MaybeThready/MT-EMI/docs/分镜.md

# MT-EMI 项目展示分镜

## 1. 开头

- +6s（00:06）：拍摄全景，展示外设，口播项目简介。

## 2. 基本交互功能演示

### 2.1. 电容交互演示

- +13s（00:19）：依次演奏 24 个音，展示电容触摸特色交互方式

### 2.2. UI 交互演示

下面的交互方式展示要结合 LCD 显示，口播说明操作逻辑：

- +15s（00:34）：演示旋钮旋动、按下、微调三种交互方式。以音量为例
- +10s（00:44）：演示四个外接按键的使用，展示不同功能的切换。以波形、频谱为例

## 3. 多维表情调控演示

### 3.1. 基本表情演示

- +10s（00:54）：演示力度感应，以不同的力度按压同一个音，展示力度感应的音量变化。
- +10s（01:04）：演示弯音轮的使用，展示音高的连续变化。

### 3.2. 波表与失谐演示

- +14s（01:18）：演示波表端点和插值的调节，展示音色的变化。
- +10s（01:28）：演示失谐的调节，展示音色的变化。

### 3.3. ADSR 调节演示

- +15s（01:43）：演示 ADSR 的调节，展示音量包络的变化。

### 3.4. 效果器演示

- +15s（01:55）：演示混响、延迟、失真、合唱四种效果干湿比的调节，展示音色的变化。
- +15s（02:10）：演示高级音效设置，以延迟为例，展示高级参数的调节。

## 4. 高级功能演示

### 4.1. 和弦演奏模式演示

- +15s（02:25）：演示和弦演奏模式，展示左手和弦、右手旋律的演奏方式。

### 4.2. 音色保存与读取演示

- +30s（02:50）：先运用加速的方式从零开始捏制一个音色，然后以正常速度进行保存、掉电读取的演示

## 5. 结尾

- +10s（03:00）：用美妙的音色弹奏一段美妙的动机作为收尾
