MaybeThready/MT-EMI/docs/S1测试计划.md

# S1 上板测试计划

## 1. 目的与公共接线

四个测试顶层依次增加 ROM 与 I2S、单声部机架、32 声部机架、键盘与 UI。每次只选择一个 `src/test` 中的模块为 Gowin 顶层；四个模块使用相同的顶层端口名称，便于复用一份物理管脚约束。仍需将相应测试文件加入工程，并检查综合、布线报告及约束覆盖情况。

| 顶层端口 | 用途 | 预期 |
| --- | --- | --- |
| `clk_core`、`rst_n` | 50 MHz 输入时钟、低有效复位 | PLL 锁定后系统运行；复位后从乐句或键盘初始状态开始 |
| `i2s_bclk`、`i2s_lrck`、`i2s_dout` | MAX98357A 的 BCLK、LRCK、DIN | 标称 BCLK 1.536 MHz、LRCK 48 kHz；左声道有声，右声道静音 |
| `sd_mode_n` | MAX98357A 声道选择 | **逻辑高电平**，按当前 `i2s_driver` 的约定选择左声道；接线前核对所用功放板 |
| `data_a`、`data_b` | 两块键盘板 74HC165 的串行输出 | 仅第四项使用；1 表示按下 |
| `load_n`、`key_clk` | 74HC165 并行装载和移位时钟 | 前三项固定为 1 和 0；第四项由 `keyboard_driver` 驱动 |
| `status_led[0]` | I2S 帧计数心跳 | 逻辑电平持续翻转，约 1.46 Hz 闪烁频率；实际亮灭取决于 LED 极性 |
| `status_led[1]` | 错误锁存 | 正常为逻辑 0；前三项表示 I2S 欠载，第四项还包含 UI 配置错误和采样超时 |

开始时降低功放音量。示波器测频以板上实际 PLL 输出为准；下面的音频时长和频率按代码标称 48 kHz 计算。I2S 音频经单槽缓冲，机架输出通常会比计算事件晚一个音频帧左右；复位后的短暂静音属于启动过程。

## 2. `test_i2s`：ROM、相位和 I2S

参考文件：[test_i2s_440hz.wav](../assets/audio/s1_expected/test_i2s_440hz.wav)。参考文件截取持续输出的前 2 秒。

- 预期持续听到 **A4、440 Hz** 的纯正弦音，不应有周期性的静音、爆音或音高跳变。没有包络，响度基本恒定。
- 相位累加器每采样前进一步，使用 ROM 的波形 0；I2S 左声道传输 16 位补码采样，右声道传静音。
- 逻辑 `status_led[1]` 应保持 0。若其变为 1，先检查 ROM 采样是否赶上 I2S 接收时刻。

这一项通过后，再接入通道机架。只听到静音时，依次检查 PLL 锁定、`smp_tick_up`、ROM 地址/数据和 I2S 接线。

## 3. `test_static_music`：单声部乐句

参考文件：[test_static_music.wav](../assets/audio/s1_expected/test_static_music.wav)，含两个循环，共 4 秒。

| 乐句位置 | 0 | 1 | 2 | 3 | 4 | 5 | 6 | 7 |
| --- | --- | --- | --- | --- | --- | --- | --- | --- |
| 音符 | C4 | C4 | G4 | G4 | A4 | A4 | G4 | 休止 |

- 每格 12,000 个采样，即 250 ms；第 10,800 个采样发 `note_off`，释放持续 240 个采样，约 5 ms。换音前约有 20 ms 静音。整句每 2 秒重复。
- 单声部、正弦波；力度 `0xC000`，Attack/Decay 各 48 个采样，Sustain `0xB000`。应听到清楚的七个音和末尾休止，不应有两个音同时响起。
- 逻辑 `status_led[1]` 在第一次机架输出后应保持 0；若升高，检查机架每帧是否产生采样和 I2S 缓冲握手。

## 4. `test_dynamic_music`：32 声部与音色变化

参考文件：[test_dynamic_music.wav](../assets/audio/s1_expected/test_dynamic_music.wav)，含两个循环，共 7 秒。

- 每 250 ms 依次演奏 `C4 C4 G4 G4 A4 A4 G4 / F4 F4 E4 E4 D4 D4 C4`，单句 3.5 秒。每个新音只触发一个声部，声部在 32 路中轮流分配。
- 音符在本格第 10,000 个采样，约 208.3 ms 时释放；Release 为 4,800 个采样，约 100 ms。因此相邻音符约有 **58.3 ms 的释放尾音重叠**，听起来比上一项连贯。这种尾音叠加属于预期，不代表同时触发了多个新音。
- Attack 为 240 个采样（5 ms），Decay 为 2,400 个采样（50 ms），Sustain `0x9000`，力度 `0x7000`。正弦波与三角波插值系数随音符序号变化，音色应有规律地改变。当前测试未加入滑音。
- 21 位复音和在输出 I2S 前饱和到 16 位，单音不除以 32；通常不应听到持续削波或采样空洞。逻辑 `status_led[1]` 应保持 0。

## 5. `test_keyboard_interaction`：实物琴键

这一项使用两块键盘板、`keyboard_driver`、`user_interface`、32 声部机架和 I2S。当前驱动为所有琴键提供固定满刻度力度；旋钮、UI 按钮、弯音轮及音色存储不参与测试。UI 默认正弦波，Attack 约 5 ms、Decay 约 150 ms、Sustain 约 70%、Release 约 200 ms。顶层尚未使用 UI 输出的 `master_volume`，因此参考声音不按 UI 默认总音量 30% 缩放。

建议按下面顺序检查，按键编号见 [UI 交互设计](UI交互设计.md)：

1. 按住 A 板 P01（C4），确认只触发一次 `note_on`，持续发声；松开时只触发一次 `note_off`，声音在约 200 ms 内逐渐消失。
2. 按住 A 板 P10（A4），确认音高约 440 Hz；快速重复按放，检查不会卡音或漏释放。
3. 同时按住 P01、P05、P08（C4、E4、G4），确认能听到和弦；分别松开时，各音应独立进入 Release。
4. 观察 `load_n` 与 `key_clk` 的扫描，及内部 `key_states`、`note_on`、`note_off`、`note_busy`。逻辑 `status_led[1]` 应保持 0；若变为 1，分别排查 UI 配置、计算超时和 I2S 欠载。

[test_keyboard_interaction_demo.wav](../assets/audio/s1_expected/test_keyboard_interaction_demo.wav) 仅给出**可重复的演奏示例**：C4 按下 0～0.45 秒，A4 按下 0.70～1.15 秒，C4/E4/G4 和弦按下 1.40～2.10 秒，随后等待释放。实际键盘何时按下由演奏者决定，不能把这份 WAV 当成第四项的固定逐点黄金数据。

## 6. 生成与比较参考音频

在工程根目录运行：

```text
python scripts/audio/generate_s1_expected_audio.py
```

脚本读取现有的 `assets/audio/wavetables.mi`，在 `assets/audio/s1_expected/` 生成上述四个 **48 kHz、单声道、16 位 PCM WAV**。更新 ROM、音符序列或 ADSR 常数后，需同步更新脚本参数并重新生成。

WAV 用于比较音高、节奏、波形和包络趋势。脚本按照线性 ADSR 与定点波表运算生成听感参考，没有模拟 PLL 启动、键盘扫描抖动、每个 valid/ready 状态或 I2S 帧缓冲的精确延迟；录音对比时先对齐起点，并允许少量采样级相位和量化差异。第四项还取决于实际按键动作，重点检查事件与声音响应，不作固定逐点比较。
