MaybeThready/MT-EMI/docs/包络计算公式.md

# 包络模块计算公式

2026.10.19 最后一次修订

## Attack 阶段

Attack 阶段包络由 $(0, 0)$ 线性上升到 $(a, M)$，其中，$a$ 为 Attack 采样周期数，$M$ 为定点数最大值。

设当前阶段采样周期数为 $t$，则 Attack 阶段包络计算公式为：

$$ y(t) = K_a t $$

$$ K_a = M I_a $$

$$ I_a = \frac{1}{a} $$

## Decay 阶段

### 二次曲线方案

Decay 阶段包络由 $(0, M)$ 二次下降到 $(d, s)$，其中，$d$ 为 Decay 采样周期数，$s$ 为 Sustain 阶段的包络值。

设当前阶段采样周期数为 $t$，则 Decay 阶段包络计算公式为：

$$ y(t) = \frac{M - s}{d^2} t^2 - \frac{2(M-s)}{d} t + M $$

取微分，得

$$ -dy(t) = K_d(1-I_d t) dt $$

$$ K_d = \frac{2(M-s)}{d} $$

### 线性方案

Decay 阶段包络由 $(0, M)$ 线性下降到 $(d, s)$，其中，$d$ 为 Decay 采样周期数，$s$ 为 Sustain 阶段的包络值。

设当前阶段采样周期数为 $t$，则 Decay 阶段包络计算公式为：

$$ y(t) = M - K_d t $$

$$ K_d = \frac{M - s}{d} $$

## Sustain 阶段

Sustain 阶段包络为常数 $s$，即：

$$ y(t) = s $$

## Release 阶段

### 二次曲线方案

Release 阶段包络由 $(0, s)$ 二次下降到 $(r, 0)$，其中，$r$ 为 Release 采样周期数。

设当前阶段采样周期数为 $t$，则 Release 阶段包络计算公式为：

$$ y(t) = \frac{s}{r^2} t^2 - \frac{2s}{r} t + s$$

取微分，得

$$ -dy(t) = K_r(1-I_r t) dt $$

$$ K_r = \frac{2s}{r} $$

### 线性方案

Release 阶段包络由 $(0, s)$ 线性下降到 $(r, 0)$，其中，$r$ 为 Release 采样周期数。

设当前阶段采样周期数为 $t$，则 Release 阶段包络计算公式为：

$$ y(t) = s - K_r t $$

$$ K_r = \frac{s}{r} $$
