MaybeThready/MT-EMI/src/audio_mix_buffer/audio_mix_buffer.v

//Copyright (C)2014-2026 Gowin Semiconductor Corporation.
//All rights reserved.
//File Title: IP file
//Tool Version: V1.9.12.04 (64-bit)
//IP Version: 1.0
//Part Number: GW5AST-LV138FPG676AC1/I0
//Device: GW5AST-138
//Device Version: C
//Created Time: Tue Oct 27 20:31:01 2026

module audio_mix_buffer (dout, clka, cea, clkb, ceb, oce, reset, ada, din, adb);

output [23:0] dout;
input clka;
input cea;
input clkb;
input ceb;
input oce;
input reset;
input [16:0] ada;
input [23:0] din;
input [16:0] adb;

wire lut_f_0;
wire lut_f_1;
wire lut_f_2;
wire lut_f_3;
wire lut_f_4;
wire lut_f_5;
wire lut_f_6;
wire lut_f_7;
wire lut_f_8;
wire lut_f_9;
wire lut_f_10;
wire lut_f_11;
wire lut_f_12;
wire lut_f_13;
wire lut_f_14;
wire lut_f_15;
wire lut_f_16;
wire lut_f_17;
wire lut_f_18;
wire lut_f_19;
wire lut_f_20;
wire lut_f_21;
wire lut_f_22;
wire lut_f_23;
wire lut_f_24;
wire lut_f_25;
wire lut_f_26;
wire lut_f_27;
wire lut_f_28;
wire lut_f_29;
wire lut_f_30;
wire lut_f_31;
wire lut_f_32;
wire lut_f_33;
wire lut_f_34;
wire lut_f_35;
wire lut_f_36;
wire lut_f_37;
wire lut_f_38;
wire lut_f_39;
wire lut_f_40;
wire lut_f_41;
wire lut_f_42;
wire lut_f_43;
wire lut_f_44;
wire lut_f_45;
wire lut_f_46;
wire lut_f_47;
wire lut_f_48;
wire lut_f_49;
wire lut_f_50;
wire lut_f_51;
wire lut_f_52;
wire lut_f_53;
wire lut_f_54;
wire lut_f_55;
wire lut_f_56;
wire lut_f_57;
wire lut_f_58;
wire lut_f_59;
wire lut_f_60;
wire lut_f_61;
wire lut_f_62;
wire lut_f_63;
wire lut_f_64;
wire lut_f_65;
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
    .ADB({adb[10:0],gw_gnd,gw_gnd,gw_gnd})
);

defparam sdpx9b_inst_3.READ_MODE = 1'b0;
defparam sdpx9b_inst_3.BIT_WIDTH_0 = 9;
defparam sdpx9b_inst_3.BIT_WIDTH_1 = 9;
defparam sdpx9b_inst_3.BLK_SEL_0 = 3'b001;
defparam sdpx9b_inst_3.BLK_SEL_1 = 3'b001;
defparam sdpx9b_inst_3.RESET_MODE = "SYNC";

SDPX9B sdpx9b_inst_4 (
    .DO({sdpx9b_inst_4_dout_w[26:0],sdpx9b_inst_4_dout[8:0]}),
    .CLKA(clka),
    .CEA(cea),
    .CLKB(clkb),
    .CEB(ceb),
    .OCE(oce),
    .RESET(reset),
    .BLKSELA({gw_gnd,gw_gnd,lut_f_4}),
    .BLKSELB({gw_gnd,gw_gnd,lut_f_44}),
    .ADA({ada[10:0],gw_gnd,gw_gnd,gw_gnd}),
    .DI({gw_gnd,gw_gnd,gw_gnd,gw_gnd,gw_gnd,gw_gnd,gw_gnd,gw_gnd,gw_gnd,gw_gnd,gw_gnd,gw_gnd,gw_gnd,gw_gnd,gw_gnd,gw_gnd,gw_gnd,gw_gnd,gw_gnd,gw_gnd,gw_gnd,gw_gnd,gw_gnd,gw_gnd,gw_gnd,gw_gnd,gw_gnd,din[8:0]}),
    .ADB({adb[10:0],gw_gnd,gw_gnd,gw_gnd})
);

defparam sdpx9b_inst_4.READ_MODE = 1'b0;
defparam sdpx9b_inst_4.BIT_WIDTH_0 = 9;
defparam sdpx9b_inst_4.BIT_WIDTH_1 = 9;
defparam sdpx9b_inst_4.BLK_SEL_0 = 3'b001;
defparam sdpx9b_inst_4.BLK_SEL_1 = 3'b001;
defparam sdpx9b_inst_4.RESET_MODE = "SYNC";

SDPX9B sdpx9b_inst_5 (
    .DO({sdpx9b_inst_5_dout_w[26:0],sdpx9b_inst_5_dout[8:0]}),
    .CLKA(clka),
    .CEA(cea),
    .CLKB(clkb),
    .CEB(ceb),
    .OCE(oce),
    .RESET(reset),
    .BLKSELA({gw_gnd,gw_gnd,lut_f_5}),
    .BLKSELB({gw_gnd,gw_gnd,lut_f_45}),
    .ADA({ada[10:0],gw_gnd,gw_gnd,gw_gnd}),
    .DI({gw_gnd,gw_gnd,gw_gnd,gw_gnd,gw_gnd,gw_gnd,gw_gnd,gw_gnd,gw_gnd,gw_gnd,gw_gnd,gw_gnd,gw_gnd,gw_gnd,gw_gnd,gw_gnd,gw_gnd,gw_gnd,gw_gnd,gw_gnd,gw_gnd,gw_gnd,gw_gnd,gw_gnd,gw_gnd,gw_gnd,gw_gnd,din[8:0]}),
    .ADB({adb[10:0],gw_gnd,gw_gnd,gw_gnd})
);

defparam sdpx9b_inst_5.READ_MODE = 1'b0;
defparam sdpx9b_inst_5.BIT_WIDTH_0 = 9;
defparam sdpx9b_inst_5.BIT_WIDTH_1 = 9;
defparam sdpx9b_inst_5.BLK_SEL_0 = 3'b001;
defparam sdpx9b_inst_5.BLK_SEL_1 = 3'b001;
defparam sdpx9b_inst_5.RESET_MODE = "SYNC";

SDPX9B sdpx9b_inst_6 (
    .DO({sdpx9b_inst_6_dout_w[26:0],sdpx9b_inst_6_dout[8:0]}),
    .CLKA(clka),
    .CEA(cea),
    .CLKB(clkb),
    .CEB(ceb),
    .OCE(oce),
    .RESET(reset),
    .BLKSELA({gw_gnd,gw_gnd,lut_f_6}),
    .BLKSELB({gw_gnd,gw_gnd,lut_f_46}),
    .ADA({ada[10:0],gw_gnd,gw_gnd,gw_gnd}),
    .DI({gw_gnd,gw_gnd,gw_gnd,gw_gnd,gw_gnd,gw_gnd,gw_gnd,gw_gnd,gw_gnd,gw_gnd,gw_gnd,gw_gnd,gw_gnd,gw_gnd,gw_gnd,gw_gnd,gw_gnd,gw_gnd,gw_gnd,gw_gnd,gw_gnd,gw_gnd,gw_gnd,gw_gnd,gw_gnd,gw_gnd,gw_gnd,din[8:0]}),
    .ADB({adb[10:0],gw_gnd,gw_gnd,gw_gnd})
);

defparam sdpx9b_inst_6.READ_MODE = 1'b0;
defparam sdpx9b_inst_6.BIT_WIDTH_0 = 9;
defparam sdpx9b_inst_6.BIT_WIDTH_1 = 9;
defparam sdpx9b_inst_6.BLK_SEL_0 = 3'b001;
defparam sdpx9b_inst_6.BLK_SEL_1 = 3'b001;
defparam sdpx9b_inst_6.RESET_MODE = "SYNC";

SDPX9B sdpx9b_inst_7 (
    .DO({sdpx9b_inst_7_dout_w[26:0],sdpx9b_inst_7_dout[8:0]}),
    .CLKA(clka),
    .CEA(cea),
    .CLKB(clkb),
    .CEB(ceb),
    .OCE(oce),
    .RESET(reset),
    .BLKSELA({gw_gnd,gw_gnd,lut_f_7}),
    .BLKSELB({gw_gnd,gw_gnd,lut_f_47}),
    .ADA({ada[10:0],gw_gnd,gw_gnd,gw_gnd}),
    .DI({gw_gnd,gw_gnd,gw_gnd,gw_gnd,gw_gnd,gw_gnd,gw_gnd,gw_gnd,gw_gnd,gw_gnd,gw_gnd,gw_gnd,gw_gnd,gw_gnd,gw_gnd,gw_gnd,gw_gnd,gw_gnd,gw_gnd,gw_gnd,gw_gnd,gw_gnd,gw_gnd,gw_gnd,gw_gnd,gw_gnd,gw_gnd,din[8:0]}),
    .ADB({adb[10:0],gw_gnd,gw_gnd,gw_gnd})
);

defparam sdpx9b_inst_7.READ_MODE = 1'b0;
defparam sdpx9b_inst_7.BIT_WIDTH_0 = 9;
defparam sdpx9b_inst_7.BIT_WIDTH_1 = 9;
defparam sdpx9b_inst_7.BLK_SEL_0 = 3'b001;
defparam sdpx9b_inst_7.BLK_SEL_1 = 3'b001;
defparam sdpx9b_inst_7.RESET_MODE = "SYNC";

SDPX9B sdpx9b_inst_8 (
    .DO({sdpx9b_inst_8_dout_w[26:0],sdpx9b_inst_8_dout[8:0]}),
    .CLKA(clka),
    .CEA(cea),
    .CLKB(clkb),
    .CEB(ceb),
    .OCE(oce),
    .RESET(reset),
    .BLKSELA({gw_gnd,gw_gnd,lut_f_8}),
    .BLKSELB({gw_gnd,gw_gnd,lut_f_48}),
    .ADA({ada[10:0],gw_gnd,gw_gnd,gw_gnd}),
    .DI({gw_gnd,gw_gnd,gw_gnd,gw_gnd,gw_gnd,gw_gnd,gw_gnd,gw_gnd,gw_gnd,gw_gnd,gw_gnd,gw_gnd,gw_gnd,gw_gnd,gw_gnd,gw_gnd,gw_gnd,gw_gnd,gw_gnd,gw_gnd,gw_gnd,gw_gnd,gw_gnd,gw_gnd,gw_gnd,gw_gnd,gw_gnd,din[8:0]}),
    .ADB({adb[10:0],gw_gnd,gw_gnd,gw_gnd})
);

defparam sdpx9b_inst_8.READ_MODE = 1'b0;
defparam sdpx9b_inst_8.BIT_WIDTH_0 = 9;
defparam sdpx9b_inst_8.BIT_WIDTH_1 = 9;
defparam sdpx9b_inst_8.BLK_SEL_0 = 3'b001;
defparam sdpx9b_inst_8.BLK_SEL_1 = 3'b001;
defparam sdpx9b_inst_8.RESET_MODE = "SYNC";

SDPX9B sdpx9b_inst_9 (
    .DO({sdpx9b_inst_9_dout_w[26:0],sdpx9b_inst_9_dout[8:0]}),
    .CLKA(clka),
    .CEA(cea),
    .CLKB(clkb),
    .CEB(ceb),
    .OCE(oce),
    .RESET(reset),
    .BLKSELA({gw_gnd,gw_gnd,lut_f_9}),
    .BLKSELB({gw_gnd,gw_gnd,lut_f_49}),
    .ADA({ada[10:0],gw_gnd,gw_gnd,gw_gnd}),
    .DI({gw_gnd,gw_gnd,gw_gnd,gw_gnd,gw_gnd,gw_gnd,gw_gnd,gw_gnd,gw_gnd,gw_gnd,gw_gnd,gw_gnd,gw_gnd,gw_gnd,gw_gnd,gw_gnd,gw_gnd,gw_gnd,gw_gnd,gw_gnd,gw_gnd,gw_gnd,gw_gnd,gw_gnd,gw_gnd,gw_gnd,gw_gnd,din[8:0]}),
    .ADB({adb[10:0],gw_gnd,gw_gnd,gw_gnd})
);

defparam sdpx9b_inst_9.READ_MODE = 1'b0;
defparam sdpx9b_inst_9.BIT_WIDTH_0 = 9;
defparam sdpx9b_inst_9.BIT_WIDTH_1 = 9;
defparam sdpx9b_inst_9.BLK_SEL_0 = 3'b001;
defparam sdpx9b_inst_9.BLK_SEL_1 = 3'b001;
defparam sdpx9b_inst_9.RESET_MODE = "SYNC";

SDPX9B sdpx9b_inst_10 (
    .DO({sdpx9b_inst_10_dout_w[26:0],sdpx9b_inst_10_dout[8:0]}),
    .CLKA(clka),
    .CEA(cea),
    .CLKB(clkb),
    .CEB(ceb),
    .OCE(oce),
    .RESET(reset),
    .BLKSELA({gw_gnd,gw_gnd,lut_f_10}),
    .BLKSELB({gw_gnd,gw_gnd,lut_f_50}),
    .ADA({ada[10:0],gw_gnd,gw_gnd,gw_gnd}),
    .DI({gw_gnd,gw_gnd,gw_gnd,gw_gnd,gw_gnd,gw_gnd,gw_gnd,gw_gnd,gw_gnd,gw_gnd,gw_gnd,gw_gnd,gw_gnd,gw_gnd,gw_gnd,gw_gnd,gw_gnd,gw_gnd,gw_gnd,gw_gnd,gw_gnd,gw_gnd,gw_gnd,gw_gnd,gw_gnd,gw_gnd,gw_gnd,din[8:0]}),
    .ADB({adb[10:0],gw_gnd,gw_gnd,gw_gnd})
);

defparam sdpx9b_inst_10.READ_MODE = 1'b0;
defparam sdpx9b_inst_10.BIT_WIDTH_0 = 9;
defparam sdpx9b_inst_10.BIT_WIDTH_1 = 9;
defparam sdpx9b_inst_10.BLK_SEL_0 = 3'b001;
defparam sdpx9b_inst_10.BLK_SEL_1 = 3'b001;
defparam sdpx9b_inst_10.RESET_MODE = "SYNC";

SDPX9B sdpx9b_inst_11 (
    .DO({sdpx9b_inst_11_dout_w[26:0],sdpx9b_inst_11_dout[8:0]}),
    .CLKA(clka),
    .CEA(cea),
    .CLKB(clkb),
    .CEB(ceb),
    .OCE(oce),
    .RESET(reset),
    .BLKSELA({gw_gnd,gw_gnd,lut_f_11}),
    .BLKSELB({gw_gnd,gw_gnd,lut_f_51}),
    .ADA({ada[10:0],gw_gnd,gw_gnd,gw_gnd}),
    .DI({gw_gnd,gw_gnd,gw_gnd,gw_gnd,gw_gnd,gw_gnd,gw_gnd,gw_gnd,gw_gnd,gw_gnd,gw_gnd,gw_gnd,gw_gnd,gw_gnd,gw_gnd,gw_gnd,gw_gnd,gw_gnd,gw_gnd,gw_gnd,gw_gnd,gw_gnd,gw_gnd,gw_gnd,gw_gnd,gw_gnd,gw_gnd,din[8:0]}),
    .ADB({adb[10:0],gw_gnd,gw_gnd,gw_gnd})
);

defparam sdpx9b_inst_11.READ_MODE = 1'b0;
defparam sdpx9b_inst_11.BIT_WIDTH_0 = 9;
defparam sdpx9b_inst_11.BIT_WIDTH_1 = 9;
defparam sdpx9b_inst_11.BLK_SEL_0 = 3'b001;
defparam sdpx9b_inst_11.BLK_SEL_1 = 3'b001;
defparam sdpx9b_inst_11.RESET_MODE = "SYNC";

SDPX9B sdpx9b_inst_12 (
    .DO({sdpx9b_inst_12_dout_w[26:0],sdpx9b_inst_12_dout[8:0]}),
    .CLKA(clka),
    .CEA(cea),
    .CLKB(clkb),
    .CEB(ceb),
    .OCE(oce),
    .RESET(reset),
    .BLKSELA({gw_gnd,gw_gnd,lut_f_12}),
    .BLKSELB({gw_gnd,gw_gnd,lut_f_52}),
    .ADA({ada[10:0],gw_gnd,gw_gnd,gw_gnd}),
    .DI({gw_gnd,gw_gnd,gw_gnd,gw_gnd,gw_gnd,gw_gnd,gw_gnd,gw_gnd,gw_gnd,gw_gnd,gw_gnd,gw_gnd,gw_gnd,gw_gnd,gw_gnd,gw_gnd,gw_gnd,gw_gnd,gw_gnd,gw_gnd,gw_gnd,gw_gnd,gw_gnd,gw_gnd,gw_gnd,gw_gnd,gw_gnd,din[8:0]}),
    .ADB({adb[10:0],gw_gnd,gw_gnd,gw_gnd})
);

defparam sdpx9b_inst_12.READ_MODE = 1'b0;
defparam sdpx9b_inst_12.BIT_WIDTH_0 = 9;
defparam sdpx9b_inst_12.BIT_WIDTH_1 = 9;
defparam sdpx9b_inst_12.BLK_SEL_0 = 3'b001;
defparam sdpx9b_inst_12.BLK_SEL_1 = 3'b001;
defparam sdpx9b_inst_12.RESET_MODE = "SYNC";

SDPX9B sdpx9b_inst_13 (
    .DO({sdpx9b_inst_13_dout_w[26:0],sdpx9b_inst_13_dout[8:0]}),
    .CLKA(clka),
    .CEA(cea),
    .CLKB(clkb),
    .CEB(ceb),
    .OCE(oce),
    .RESET(reset),
    .BLKSELA({gw_gnd,gw_gnd,lut_f_13}),
    .BLKSELB({gw_gnd,gw_gnd,lut_f_53}),
    .ADA({ada[10:0],gw_gnd,gw_gnd,gw_gnd}),
    .DI({gw_gnd,gw_gnd,gw_gnd,gw_gnd,gw_gnd,gw_gnd,gw_gnd,gw_gnd,gw_gnd,gw_gnd,gw_gnd,gw_gnd,gw_gnd,gw_gnd,gw_gnd,gw_gnd,gw_gnd,gw_gnd,gw_gnd,gw_gnd,gw_gnd,gw_gnd,gw_gnd,gw_gnd,gw_gnd,gw_gnd,gw_gnd,din[8:0]}),
    .ADB({adb[10:0],gw_gnd,gw_gnd,gw_gnd})
);

defparam sdpx9b_inst_13.READ_MODE = 1'b0;
defparam sdpx9b_inst_13.BIT_WIDTH_0 = 9;
defparam sdpx9b_inst_13.BIT_WIDTH_1 = 9;
defparam sdpx9b_inst_13.BLK_SEL_0 = 3'b001;
defparam sdpx9b_inst_13.BLK_SEL_1 = 3'b001;
defparam sdpx9b_inst_13.RESET_MODE = "SYNC";

SDPX9B sdpx9b_inst_14 (
    .DO({sdpx9b_inst_14_dout_w[26:0],sdpx9b_inst_14_dout[8:0]}),
    .CLKA(clka),
    .CEA(cea),
    .CLKB(clkb),
    .CEB(ceb),
    .OCE(oce),
    .RESET(reset),
    .BLKSELA({gw_gnd,gw_gnd,lut_f_14}),
    .BLKSELB({gw_gnd,gw_gnd,lut_f_54}),
    .ADA({ada[10:0],gw_gnd,gw_gnd,gw_gnd}),
    .DI({gw_gnd,gw_gnd,gw_gnd,gw_gnd,gw_gnd,gw_gnd,gw_gnd,gw_gnd,gw_gnd,gw_gnd,gw_gnd,gw_gnd,gw_gnd,gw_gnd,gw_gnd,gw_gnd,gw_gnd,gw_gnd,gw_gnd,gw_gnd,gw_gnd,gw_gnd,gw_gnd,gw_gnd,gw_gnd,gw_gnd,gw_gnd,din[8:0]}),
    .ADB({adb[10:0],gw_gnd,gw_gnd,gw_gnd})
);

defparam sdpx9b_inst_14.READ_MODE = 1'b0;
defparam sdpx9b_inst_14.BIT_WIDTH_0 = 9;
defparam sdpx9b_inst_14.BIT_WIDTH_1 = 9;
defparam sdpx9b_inst_14.BLK_SEL_0 = 3'b001;
defparam sdpx9b_inst_14.BLK_SEL_1 = 3'b001;
defparam sdpx9b_inst_14.RESET_MODE = "SYNC";

SDPX9B sdpx9b_inst_15 (
    .DO({sdpx9b_inst_15_dout_w[26:0],sdpx9b_inst_15_dout[8:0]}),
    .CLKA(clka),
    .CEA(cea),
    .CLKB(clkb),
    .CEB(ceb),
    .OCE(oce),
    .RESET(reset),
    .BLKSELA({gw_gnd,gw_gnd,lut_f_15}),
    .BLKSELB({gw_gnd,gw_gnd,lut_f_55}),
    .ADA({ada[10:0],gw_gnd,gw_gnd,gw_gnd}),
    .DI({gw_gnd,gw_gnd,gw_gnd,gw_gnd,gw_gnd,gw_gnd,gw_gnd,gw_gnd,gw_gnd,gw_gnd,gw_gnd,gw_gnd,gw_gnd,gw_gnd,gw_gnd,gw_gnd,gw_gnd,gw_gnd,gw_gnd,gw_gnd,gw_gnd,gw_gnd,gw_gnd,gw_gnd,gw_gnd,gw_gnd,gw_gnd,din[8:0]}),
    .ADB({adb[10:0],gw_gnd,gw_gnd,gw_gnd})
);

defparam sdpx9b_inst_15.READ_MODE = 1'b0;
defparam sdpx9b_inst_15.BIT_WIDTH_0 = 9;
defparam sdpx9b_inst_15.BIT_WIDTH_1 = 9;
defparam sdpx9b_inst_15.BLK_SEL_0 = 3'b001;
defparam sdpx9b_inst_15.BLK_SEL_1 = 3'b001;
defparam sdpx9b_inst_15.RESET_MODE = "SYNC";

SDPX9B sdpx9b_inst_16 (
    .DO({sdpx9b_inst_16_dout_w[26:0],sdpx9b_inst_16_dout[8:0]}),
    .CLKA(clka),
    .CEA(cea),
    .CLKB(clkb),
    .CEB(ceb),
    .OCE(oce),
    .RESET(reset),
    .BLKSELA({gw_gnd,gw_gnd,lut_f_16}),
    .BLKSELB({gw_gnd,gw_gnd,lut_f_56}),
    .ADA({ada[10:0],gw_gnd,gw_gnd,gw_gnd}),
    .DI({gw_gnd,gw_gnd,gw_gnd,gw_gnd,gw_gnd,gw_gnd,gw_gnd,gw_gnd,gw_gnd,gw_gnd,gw_gnd,gw_gnd,gw_gnd,gw_gnd,gw_gnd,gw_gnd,gw_gnd,gw_gnd,gw_gnd,gw_gnd,gw_gnd,gw_gnd,gw_gnd,gw_gnd,gw_gnd,gw_gnd,gw_gnd,din[8:0]}),
    .ADB({adb[10:0],gw_gnd,gw_gnd,gw_gnd})
);

defparam sdpx9b_inst_16.READ_MODE = 1'b0;
defparam sdpx9b_inst_16.BIT_WIDTH_0 = 9;
defparam sdpx9b_inst_16.BIT_WIDTH_1 = 9;
defparam sdpx9b_inst_16.BLK_SEL_0 = 3'b001;
defparam sdpx9b_inst_16.BLK_SEL_1 = 3'b001;
defparam sdpx9b_inst_16.RESET_MODE = "SYNC";

SDPX9B sdpx9b_inst_17 (
    .DO({sdpx9b_inst_17_dout_w[26:0],sdpx9b_inst_17_dout[8:0]}),
    .CLKA(clka),
    .CEA(cea),
    .CLKB(clkb),
    .CEB(ceb),
    .OCE(oce),
    .RESET(reset),
    .BLKSELA({gw_gnd,gw_gnd,lut_f_17}),
    .BLKSELB({gw_gnd,gw_gnd,lut_f_57}),
    .ADA({ada[10:0],gw_gnd,gw_gnd,gw_gnd}),
    .DI({gw_gnd,gw_gnd,gw_gnd,gw_gnd,gw_gnd,gw_gnd,gw_gnd,gw_gnd,gw_gnd,gw_gnd,gw_gnd,gw_gnd,gw_gnd,gw_gnd,gw_gnd,gw_gnd,gw_gnd,gw_gnd,gw_gnd,gw_gnd,gw_gnd,gw_gnd,gw_gnd,gw_gnd,gw_gnd,gw_gnd,gw_gnd,din[8:0]}),
    .ADB({adb[10:0],gw_gnd,gw_gnd,gw_gnd})
);

defparam sdpx9b_inst_17.READ_MODE = 1'b0;
defparam sdpx9b_inst_17.BIT_WIDTH_0 = 9;
defparam sdpx9b_inst_17.BIT_WIDTH_1 = 9;
defparam sdpx9b_inst_17.BLK_SEL_0 = 3'b001;
defparam sdpx9b_inst_17.BLK_SEL_1 = 3'b001;
defparam sdpx9b_inst_17.RESET_MODE = "SYNC";

SDPX9B sdpx9b_inst_18 (
    .DO({sdpx9b_inst_18_dout_w[26:0],sdpx9b_inst_18_dout[8:0]}),
    .CLKA(clka),
    .CEA(cea),
    .CLKB(clkb),
    .CEB(ceb),
    .OCE(oce),
    .RESET(reset),
    .BLKSELA({gw_gnd,gw_gnd,lut_f_18}),
    .BLKSELB({gw_gnd,gw_gnd,lut_f_58}),
    .ADA({ada[10:0],gw_gnd,gw_gnd,gw_gnd}),
    .DI({gw_gnd,gw_gnd,gw_gnd,gw_gnd,gw_gnd,gw_gnd,gw_gnd,gw_gnd,gw_gnd,gw_gnd,gw_gnd,gw_gnd,gw_gnd,gw_gnd,gw_gnd,gw_gnd,gw_gnd,gw_gnd,gw_gnd,gw_gnd,gw_gnd,gw_gnd,gw_gnd,gw_gnd,gw_gnd,gw_gnd,gw_gnd,din[8:0]}),
    .ADB({adb[10:0],gw_gnd,gw_gnd,gw_gnd})
);

defparam sdpx9b_inst_18.READ_MODE = 1'b0;
defparam sdpx9b_inst_18.BIT_WIDTH_0 = 9;
defparam sdpx9b_inst_18.BIT_WIDTH_1 = 9;
defparam sdpx9b_inst_18.BLK_SEL_0 = 3'b001;
defparam sdpx9b_inst_18.BLK_SEL_1 = 3'b001;
defparam sdpx9b_inst_18.RESET_MODE = "SYNC";

SDPX9B sdpx9b_inst_19 (
    .DO({sdpx9b_inst_19_dout_w[26:0],sdpx9b_inst_19_dout[8:0]}),
    .CLKA(clka),
    .CEA(cea),
    .CLKB(clkb),
    .CEB(ceb),
    .OCE(oce),
    .RESET(reset),
    .BLKSELA({gw_gnd,gw_gnd,lut_f_19}),
    .BLKSELB({gw_gnd,gw_gnd,lut_f_59}),
    .ADA({ada[10:0],gw_gnd,gw_gnd,gw_gnd}),
    .DI({gw_gnd,gw_gnd,gw_gnd,gw_gnd,gw_gnd,gw_gnd,gw_gnd,gw_gnd,gw_gnd,gw_gnd,gw_gnd,gw_gnd,gw_gnd,gw_gnd,gw_gnd,gw_gnd,gw_gnd,gw_gnd,gw_gnd,gw_gnd,gw_gnd,gw_gnd,gw_gnd,gw_gnd,gw_gnd,gw_gnd,gw_gnd,din[8:0]}),
    .ADB({adb[10:0],gw_gnd,gw_gnd,gw_gnd})
);

defparam sdpx9b_inst_19.READ_MODE = 1'b0;
defparam sdpx9b_inst_19.BIT_WIDTH_0 = 9;
defparam sdpx9b_inst_19.BIT_WIDTH_1 = 9;
defparam sdpx9b_inst_19.BLK_SEL_0 = 3'b001;
defparam sdpx9b_inst_19.BLK_SEL_1 = 3'b001;
defparam sdpx9b_inst_19.RESET_MODE = "SYNC";

SDPX9B sdpx9b_inst_20 (
    .DO({sdpx9b_inst_20_dout_w[26:0],sdpx9b_inst_20_dout[8:0]}),
    .CLKA(clka),
    .CEA(cea),
    .CLKB(clkb),
    .CEB(ceb),
    .OCE(oce),
    .RESET(reset),
    .BLKSELA({gw_gnd,gw_gnd,lut_f_20}),
    .BLKSELB({gw_gnd,gw_gnd,lut_f_60}),
    .ADA({ada[10:0],gw_gnd,gw_gnd,gw_gnd}),
    .DI({gw_gnd,gw_gnd,gw_gnd,gw_gnd,gw_gnd,gw_gnd,gw_gnd,gw_gnd,gw_gnd,gw_gnd,gw_gnd,gw_gnd,gw_gnd,gw_gnd,gw_gnd,gw_gnd,gw_gnd,gw_gnd,gw_gnd,gw_gnd,gw_gnd,gw_gnd,gw_gnd,gw_gnd,gw_gnd,gw_gnd,gw_gnd,din[8:0]}),
    .ADB({adb[10:0],gw_gnd,gw_gnd,gw_gnd})
);

defparam sdpx9b_inst_20.READ_MODE = 1'b0;
defparam sdpx9b_inst_20.BIT_WIDTH_0 = 9;
defparam sdpx9b_inst_20.BIT_WIDTH_1 = 9;
defparam sdpx9b_inst_20.BLK_SEL_0 = 3'b001;
defparam sdpx9b_inst_20.BLK_SEL_1 = 3'b001;
defparam sdpx9b_inst_20.RESET_MODE = "SYNC";

SDPX9B sdpx9b_inst_21 (
    .DO({sdpx9b_inst_21_dout_w[26:0],sdpx9b_inst_21_dout[8:0]}),
    .CLKA(clka),
    .CEA(cea),
    .CLKB(clkb),
    .CEB(ceb),
    .OCE(oce),
    .RESET(reset),
    .BLKSELA({gw_gnd,gw_gnd,lut_f_21}),
    .BLKSELB({gw_gnd,gw_gnd,lut_f_61}),
    .ADA({ada[10:0],gw_gnd,gw_gnd,gw_gnd}),
    .DI({gw_gnd,gw_gnd,gw_gnd,gw_gnd,gw_gnd,gw_gnd,gw_gnd,gw_gnd,gw_gnd,gw_gnd,gw_gnd,gw_gnd,gw_gnd,gw_gnd,gw_gnd,gw_gnd,gw_gnd,gw_gnd,gw_gnd,gw_gnd,gw_gnd,gw_gnd,gw_gnd,gw_gnd,gw_gnd,gw_gnd,gw_gnd,din[8:0]}),
    .ADB({adb[10:0],gw_gnd,gw_gnd,gw_gnd})
);

defparam sdpx9b_inst_21.READ_MODE = 1'b0;
defparam sdpx9b_inst_21.BIT_WIDTH_0 = 9;
defparam sdpx9b_inst_21.BIT_WIDTH_1 = 9;
defparam sdpx9b_inst_21.BLK_SEL_0 = 3'b001;
defparam sdpx9b_inst_21.BLK_SEL_1 = 3'b001;
defparam sdpx9b_inst_21.RESET_MODE = "SYNC";

SDPX9B sdpx9b_inst_22 (
    .DO({sdpx9b_inst_22_dout_w[26:0],sdpx9b_inst_22_dout[8:0]}),
    .CLKA(clka),
    .CEA(cea),
    .CLKB(clkb),
    .CEB(ceb),
    .OCE(oce),
    .RESET(reset),
    .BLKSELA({gw_gnd,gw_gnd,lut_f_22}),
    .BLKSELB({gw_gnd,gw_gnd,lut_f_62}),
    .ADA({ada[10:0],gw_gnd,gw_gnd,gw_gnd}),
    .DI({gw_gnd,gw_gnd,gw_gnd,gw_gnd,gw_gnd,gw_gnd,gw_gnd,gw_gnd,gw_gnd,gw_gnd,gw_gnd,gw_gnd,gw_gnd,gw_gnd,gw_gnd,gw_gnd,gw_gnd,gw_gnd,gw_gnd,gw_gnd,gw_gnd,gw_gnd,gw_gnd,gw_gnd,gw_gnd,gw_gnd,gw_gnd,din[8:0]}),
    .ADB({adb[10:0],gw_gnd,gw_gnd,gw_gnd})
);

defparam sdpx9b_inst_22.READ_MODE = 1'b0;
defparam sdpx9b_inst_22.BIT_WIDTH_0 = 9;
defparam sdpx9b_inst_22.BIT_WIDTH_1 = 9;
defparam sdpx9b_inst_22.BLK_SEL_0 = 3'b001;
defparam sdpx9b_inst_22.BLK_SEL_1 = 3'b001;
defparam sdpx9b_inst_22.RESET_MODE = "SYNC";

SDPX9B sdpx9b_inst_23 (
    .DO({sdpx9b_inst_23_dout_w[26:0],sdpx9b_inst_23_dout[8:0]}),
    .CLKA(clka),
    .CEA(cea),
    .CLKB(clkb),
    .CEB(ceb),
    .OCE(oce),
    .RESET(reset),
    .BLKSELA({gw_gnd,gw_gnd,lut_f_23}),
    .BLKSELB({gw_gnd,gw_gnd,lut_f_63}),
    .ADA({ada[10:0],gw_gnd,gw_gnd,gw_gnd}),
    .DI({gw_gnd,gw_gnd,gw_gnd,gw_gnd,gw_gnd,gw_gnd,gw_gnd,gw_gnd,gw_gnd,gw_gnd,gw_gnd,gw_gnd,gw_gnd,gw_gnd,gw_gnd,gw_gnd,gw_gnd,gw_gnd,gw_gnd,gw_gnd,gw_gnd,gw_gnd,gw_gnd,gw_gnd,gw_gnd,gw_gnd,gw_gnd,din[8:0]}),
    .ADB({adb[10:0],gw_gnd,gw_gnd,gw_gnd})
);

defparam sdpx9b_inst_23.READ_MODE = 1'b0;
defparam sdpx9b_inst_23.BIT_WIDTH_0 = 9;
defparam sdpx9b_inst_23.BIT_WIDTH_1 = 9;
defparam sdpx9b_inst_23.BLK_SEL_0 = 3'b001;
defparam sdpx9b_inst_23.BLK_SEL_1 = 3'b001;
defparam sdpx9b_inst_23.RESET_MODE = "SYNC";

SDPX9B sdpx9b_inst_24 (
    .DO({sdpx9b_inst_24_dout_w[26:0],sdpx9b_inst_24_dout[8:0]}),
    .CLKA(clka),
    .CEA(cea),
    .CLKB(clkb),
    .CEB(ceb),
    .OCE(oce),
    .RESET(reset),
    .BLKSELA({gw_gnd,gw_gnd,lut_f_24}),
    .BLKSELB({gw_gnd,gw_gnd,lut_f_64}),
    .ADA({ada[10:0],gw_gnd,gw_gnd,gw_gnd}),
    .DI({gw_gnd,gw_gnd,gw_gnd,gw_gnd,gw_gnd,gw_gnd,gw_gnd,gw_gnd,gw_gnd,gw_gnd,gw_gnd,gw_gnd,gw_gnd,gw_gnd,gw_gnd,gw_gnd,gw_gnd,gw_gnd,gw_gnd,gw_gnd,gw_gnd,gw_gnd,gw_gnd,gw_gnd,gw_gnd,gw_gnd,gw_gnd,din[8:0]}),
    .ADB({adb[10:0],gw_gnd,gw_gnd,gw_gnd})
);

defparam sdpx9b_inst_24.READ_MODE = 1'b0;
defparam sdpx9b_inst_24.BIT_WIDTH_0 = 9;
defparam sdpx9b_inst_24.BIT_WIDTH_1 = 9;
defparam sdpx9b_inst_24.BLK_SEL_0 = 3'b001;
defparam sdpx9b_inst_24.BLK_SEL_1 = 3'b001;
defparam sdpx9b_inst_24.RESET_MODE = "SYNC";

SDPX9B sdpx9b_inst_25 (
    .DO({sdpx9b_inst_25_dout_w[26:0],sdpx9b_inst_25_dout[8:0]}),
    .CLKA(clka),
    .CEA(cea),
    .CLKB(clkb),
    .CEB(ceb),
    .OCE(oce),
    .RESET(reset),
    .BLKSELA({gw_gnd,gw_gnd,lut_f_25}),
    .BLKSELB({gw_gnd,gw_gnd,lut_f_65}),
    .ADA({ada[10:0],gw_gnd,gw_gnd,gw_gnd}),
    .DI({gw_gnd,gw_gnd,gw_gnd,gw_gnd,gw_gnd,gw_gnd,gw_gnd,gw_gnd,gw_gnd,gw_gnd,gw_gnd,gw_gnd,gw_gnd,gw_gnd,gw_gnd,gw_gnd,gw_gnd,gw_gnd,gw_gnd,gw_gnd,gw_gnd,gw_gnd,gw_gnd,gw_gnd,gw_gnd,gw_gnd,gw_gnd,din[8:0]}),
    .ADB({adb[10:0],gw_gnd,gw_gnd,gw_gnd})
);

defparam sdpx9b_inst_25.READ_MODE = 1'b0;
defparam sdpx9b_inst_25.BIT_WIDTH_0 = 9;
defparam sdpx9b_inst_25.BIT_WIDTH_1 = 9;
defparam sdpx9b_inst_25.BLK_SEL_0 = 3'b001;
defparam sdpx9b_inst_25.BLK_SEL_1 = 3'b001;
defparam sdpx9b_inst_25.RESET_MODE = "SYNC";

SDPX9B sdpx9b_inst_26 (
    .DO({sdpx9b_inst_26_dout_w[26:0],sdpx9b_inst_26_dout[8:0]}),
    .CLKA(clka),
    .CEA(cea),
    .CLKB(clkb),
    .CEB(ceb),
    .OCE(oce),
    .RESET(reset),
    .BLKSELA({gw_gnd,gw_gnd,lut_f_26}),
    .BLKSELB({gw_gnd,gw_gnd,lut_f_66}),
    .ADA({ada[10:0],gw_gnd,gw_gnd,gw_gnd}),
    .DI({gw_gnd,gw_gnd,gw_gnd,gw_gnd,gw_gnd,gw_gnd,gw_gnd,gw_gnd,gw_gnd,gw_gnd,gw_gnd,gw_gnd,gw_gnd,gw_gnd,gw_gnd,gw_gnd,gw_gnd,gw_gnd,gw_gnd,gw_gnd,gw_gnd,gw_gnd,gw_gnd,gw_gnd,gw_gnd,gw_gnd,gw_gnd,din[8:0]}),
    .ADB({adb[10:0],gw_gnd,gw_gnd,gw_gnd})
);

defparam sdpx9b_inst_26.READ_MODE = 1'b0;
defparam sdpx9b_inst_26.BIT_WIDTH_0 = 9;
defparam sdpx9b_inst_26.BIT_WIDTH_1 = 9;
defparam sdpx9b_inst_26.BLK_SEL_0 = 3'b001;
defparam sdpx9b_inst_26.BLK_SEL_1 = 3'b001;
defparam sdpx9b_inst_26.RESET_MODE = "SYNC";

SDPX9B sdpx9b_inst_27 (
    .DO({sdpx9b_inst_27_dout_w[26:0],sdpx9b_inst_27_dout[8:0]}),
    .CLKA(clka),
    .CEA(cea),
    .CLKB(clkb),
    .CEB(ceb),
    .OCE(oce),
    .RESET(reset),
    .BLKSELA({gw_gnd,gw_gnd,lut_f_27}),
    .BLKSELB({gw_gnd,gw_gnd,lut_f_67}),
    .ADA({ada[10:0],gw_gnd,gw_gnd,gw_gnd}),
    .DI({gw_gnd,gw_gnd,gw_gnd,gw_gnd,gw_gnd,gw_gnd,gw_gnd,gw_gnd,gw_gnd,gw_gnd,gw_gnd,gw_gnd,gw_gnd,gw_gnd,gw_gnd,gw_gnd,gw_gnd,gw_gnd,gw_gnd,gw_gnd,gw_gnd,gw_gnd,gw_gnd,gw_gnd,gw_gnd,gw_gnd,gw_gnd,din[8:0]}),
    .ADB({adb[10:0],gw_gnd,gw_gnd,gw_gnd})
);

defparam sdpx9b_inst_27.READ_MODE = 1'b0;
defparam sdpx9b_inst_27.BIT_WIDTH_0 = 9;
defparam sdpx9b_inst_27.BIT_WIDTH_1 = 9;
defparam sdpx9b_inst_27.BLK_SEL_0 = 3'b001;
defparam sdpx9b_inst_27.BLK_SEL_1 = 3'b001;
defparam sdpx9b_inst_27.RESET_MODE = "SYNC";

SDPX9B sdpx9b_inst_28 (
    .DO({sdpx9b_inst_28_dout_w[26:0],sdpx9b_inst_28_dout[8:0]}),
    .CLKA(clka),
    .CEA(cea),
    .CLKB(clkb),
    .CEB(ceb),
    .OCE(oce),
    .RESET(reset),
    .BLKSELA({gw_gnd,gw_gnd,lut_f_28}),
    .BLKSELB({gw_gnd,gw_gnd,lut_f_68}),
    .ADA({ada[10:0],gw_gnd,gw_gnd,gw_gnd}),
    .DI({gw_gnd,gw_gnd,gw_gnd,gw_gnd,gw_gnd,gw_gnd,gw_gnd,gw_gnd,gw_gnd,gw_gnd,gw_gnd,gw_gnd,gw_gnd,gw_gnd,gw_gnd,gw_gnd,gw_gnd,gw_gnd,gw_gnd,gw_gnd,gw_gnd,gw_gnd,gw_gnd,gw_gnd,gw_gnd,gw_gnd,gw_gnd,din[8:0]}),
    .ADB({adb[10:0],gw_gnd,gw_gnd,gw_gnd})
);

defparam sdpx9b_inst_28.READ_MODE = 1'b0;
defparam sdpx9b_inst_28.BIT_WIDTH_0 = 9;
defparam sdpx9b_inst_28.BIT_WIDTH_1 = 9;
defparam sdpx9b_inst_28.BLK_SEL_0 = 3'b001;
defparam sdpx9b_inst_28.BLK_SEL_1 = 3'b001;
defparam sdpx9b_inst_28.RESET_MODE = "SYNC";

SDPX9B sdpx9b_inst_29 (
    .DO({sdpx9b_inst_29_dout_w[26:0],sdpx9b_inst_29_dout[8:0]}),
    .CLKA(clka),
    .CEA(cea),
    .CLKB(clkb),
    .CEB(ceb),
    .OCE(oce),
    .RESET(reset),
    .BLKSELA({gw_gnd,gw_gnd,lut_f_29}),
    .BLKSELB({gw_gnd,gw_gnd,lut_f_69}),
    .ADA({ada[10:0],gw_gnd,gw_gnd,gw_gnd}),
    .DI({gw_gnd,gw_gnd,gw_gnd,gw_gnd,gw_gnd,gw_gnd,gw_gnd,gw_gnd,gw_gnd,gw_gnd,gw_gnd,gw_gnd,gw_gnd,gw_gnd,gw_gnd,gw_gnd,gw_gnd,gw_gnd,gw_gnd,gw_gnd,gw_gnd,gw_gnd,gw_gnd,gw_gnd,gw_gnd,gw_gnd,gw_gnd,din[8:0]}),
    .ADB({adb[10:0],gw_gnd,gw_gnd,gw_gnd})
);

defparam sdpx9b_inst_29.READ_MODE = 1'b0;
defparam sdpx9b_inst_29.BIT_WIDTH_0 = 9;
defparam sdpx9b_inst_29.BIT_WIDTH_1 = 9;
defparam sdpx9b_inst_29.BLK_SEL_0 = 3'b001;
defparam sdpx9b_inst_29.BLK_SEL_1 = 3'b001;
defparam sdpx9b_inst_29.RESET_MODE = "SYNC";

SDPX9B sdpx9b_inst_30 (
    .DO({sdpx9b_inst_30_dout_w[26:0],sdpx9b_inst_30_dout[8:0]}),
    .CLKA(clka),
    .CEA(cea),
    .CLKB(clkb),
    .CEB(ceb),
    .OCE(oce),
    .RESET(reset),
    .BLKSELA({gw_gnd,gw_gnd,lut_f_30}),
    .BLKSELB({gw_gnd,gw_gnd,lut_f_70}),
    .ADA({ada[10:0],gw_gnd,gw_gnd,gw_gnd}),
    .DI({gw_gnd,gw_gnd,gw_gnd,gw_gnd,gw_gnd,gw_gnd,gw_gnd,gw_gnd,gw_gnd,gw_gnd,gw_gnd,gw_gnd,gw_gnd,gw_gnd,gw_gnd,gw_gnd,gw_gnd,gw_gnd,gw_gnd,gw_gnd,gw_gnd,gw_gnd,gw_gnd,gw_gnd,gw_gnd,gw_gnd,gw_gnd,din[8:0]}),
    .ADB({adb[10:0],gw_gnd,gw_gnd,gw_gnd})
);

defparam sdpx9b_inst_30.READ_MODE = 1'b0;
defparam sdpx9b_inst_30.BIT_WIDTH_0 = 9;
defparam sdpx9b_inst_30.BIT_WIDTH_1 = 9;
defparam sdpx9b_inst_30.BLK_SEL_0 = 3'b001;
defparam sdpx9b_inst_30.BLK_SEL_1 = 3'b001;
defparam sdpx9b_inst_30.RESET_MODE = "SYNC";

SDPX9B sdpx9b_inst_31 (
    .DO({sdpx9b_inst_31_dout_w[26:0],sdpx9b_inst_31_dout[8:0]}),
    .CLKA(clka),
    .CEA(cea),
    .CLKB(clkb),
    .CEB(ceb),
    .OCE(oce),
    .RESET(reset),
    .BLKSELA({gw_gnd,gw_gnd,lut_f_31}),
    .BLKSELB({gw_gnd,gw_gnd,lut_f_71}),
    .ADA({ada[10:0],gw_gnd,gw_gnd,gw_gnd}),
    .DI({gw_gnd,gw_gnd,gw_gnd,gw_gnd,gw_gnd,gw_gnd,gw_gnd,gw_gnd,gw_gnd,gw_gnd,gw_gnd,gw_gnd,gw_gnd,gw_gnd,gw_gnd,gw_gnd,gw_gnd,gw_gnd,gw_gnd,gw_gnd,gw_gnd,gw_gnd,gw_gnd,gw_gnd,gw_gnd,gw_gnd,gw_gnd,din[8:0]}),
    .ADB({adb[10:0],gw_gnd,gw_gnd,gw_gnd})
);

defparam sdpx9b_inst_31.READ_MODE = 1'b0;
defparam sdpx9b_inst_31.BIT_WIDTH_0 = 9;
defparam sdpx9b_inst_31.BIT_WIDTH_1 = 9;
defparam sdpx9b_inst_31.BLK_SEL_0 = 3'b001;
defparam sdpx9b_inst_31.BLK_SEL_1 = 3'b001;
defparam sdpx9b_inst_31.RESET_MODE = "SYNC";

SDPX9B sdpx9b_inst_32 (
    .DO({sdpx9b_inst_32_dout_w[26:0],sdpx9b_inst_32_dout[8:0]}),
    .CLKA(clka),
    .CEA(cea),
    .CLKB(clkb),
    .CEB(ceb),
    .OCE(oce),
    .RESET(reset),
    .BLKSELA({gw_gnd,gw_gnd,lut_f_32}),
    .BLKSELB({gw_gnd,gw_gnd,lut_f_72}),
    .ADA({ada[10:0],gw_gnd,gw_gnd,gw_gnd}),
    .DI({gw_gnd,gw_gnd,gw_gnd,gw_gnd,gw_gnd,gw_gnd,gw_gnd,gw_gnd,gw_gnd,gw_gnd,gw_gnd,gw_gnd,gw_gnd,gw_gnd,gw_gnd,gw_gnd,gw_gnd,gw_gnd,gw_gnd,gw_gnd,gw_gnd,gw_gnd,gw_gnd,gw_gnd,gw_gnd,gw_gnd,gw_gnd,din[8:0]}),
    .ADB({adb[10:0],gw_gnd,gw_gnd,gw_gnd})
);

defparam sdpx9b_inst_32.READ_MODE = 1'b0;
defparam sdpx9b_inst_32.BIT_WIDTH_0 = 9;
defparam sdpx9b_inst_32.BIT_WIDTH_1 = 9;
defparam sdpx9b_inst_32.BLK_SEL_0 = 3'b001;
defparam sdpx9b_inst_32.BLK_SEL_1 = 3'b001;
defparam sdpx9b_inst_32.RESET_MODE = "SYNC";

SDPX9B sdpx9b_inst_33 (
    .DO({sdpx9b_inst_33_dout_w[26:0],sdpx9b_inst_33_dout[8:0]}),
    .CLKA(clka),
    .CEA(cea),
    .CLKB(clkb),
    .CEB(ceb),
    .OCE(oce),
    .RESET(reset),
    .BLKSELA({gw_gnd,gw_gnd,lut_f_33}),
    .BLKSELB({gw_gnd,gw_gnd,lut_f_73}),
    .ADA({ada[10:0],gw_gnd,gw_gnd,gw_gnd}),
    .DI({gw_gnd,gw_gnd,gw_gnd,gw_gnd,gw_gnd,gw_gnd,gw_gnd,gw_gnd,gw_gnd,gw_gnd,gw_gnd,gw_gnd,gw_gnd,gw_gnd,gw_gnd,gw_gnd,gw_gnd,gw_gnd,gw_gnd,gw_gnd,gw_gnd,gw_gnd,gw_gnd,gw_gnd,gw_gnd,gw_gnd,gw_gnd,din[8:0]}),
    .ADB({adb[10:0],gw_gnd,gw_gnd,gw_gnd})
);

defparam sdpx9b_inst_33.READ_MODE = 1'b0;
defparam sdpx9b_inst_33.BIT_WIDTH_0 = 9;
defparam sdpx9b_inst_33.BIT_WIDTH_1 = 9;
defparam sdpx9b_inst_33.BLK_SEL_0 = 3'b001;
defparam sdpx9b_inst_33.BLK_SEL_1 = 3'b001;
defparam sdpx9b_inst_33.RESET_MODE = "SYNC";

SDPX9B sdpx9b_inst_34 (
    .DO({sdpx9b_inst_34_dout_w[26:0],sdpx9b_inst_34_dout[8:0]}),
    .CLKA(clka),
    .CEA(cea),
    .CLKB(clkb),
    .CEB(ceb),
    .OCE(oce),
    .RESET(reset),
    .BLKSELA({gw_gnd,gw_gnd,lut_f_34}),
    .BLKSELB({gw_gnd,gw_gnd,lut_f_74}),
    .ADA({ada[10:0],gw_gnd,gw_gnd,gw_gnd}),
    .DI({gw_gnd,gw_gnd,gw_gnd,gw_gnd,gw_gnd,gw_gnd,gw_gnd,gw_gnd,gw_gnd,gw_gnd,gw_gnd,gw_gnd,gw_gnd,gw_gnd,gw_gnd,gw_gnd,gw_gnd,gw_gnd,gw_gnd,gw_gnd,gw_gnd,gw_gnd,gw_gnd,gw_gnd,gw_gnd,gw_gnd,gw_gnd,din[8:0]}),
    .ADB({adb[10:0],gw_gnd,gw_gnd,gw_gnd})
);

defparam sdpx9b_inst_34.READ_MODE = 1'b0;
defparam sdpx9b_inst_34.BIT_WIDTH_0 = 9;
defparam sdpx9b_inst_34.BIT_WIDTH_1 = 9;
defparam sdpx9b_inst_34.BLK_SEL_0 = 3'b001;
defparam sdpx9b_inst_34.BLK_SEL_1 = 3'b001;
defparam sdpx9b_inst_34.RESET_MODE = "SYNC";

SDPX9B sdpx9b_inst_35 (
    .DO({sdpx9b_inst_35_dout_w[26:0],sdpx9b_inst_35_dout[8:0]}),
    .CLKA(clka),
    .CEA(cea),
    .CLKB(clkb),
    .CEB(ceb),
    .OCE(oce),
    .RESET(reset),
    .BLKSELA({gw_gnd,gw_gnd,lut_f_35}),
    .BLKSELB({gw_gnd,gw_gnd,lut_f_75}),
    .ADA({ada[10:0],gw_gnd,gw_gnd,gw_gnd}),
    .DI({gw_gnd,gw_gnd,gw_gnd,gw_gnd,gw_gnd,gw_gnd,gw_gnd,gw_gnd,gw_gnd,gw_gnd,gw_gnd,gw_gnd,gw_gnd,gw_gnd,gw_gnd,gw_gnd,gw_gnd,gw_gnd,gw_gnd,gw_gnd,gw_gnd,gw_gnd,gw_gnd,gw_gnd,gw_gnd,gw_gnd,gw_gnd,din[8:0]}),
    .ADB({adb[10:0],gw_gnd,gw_gnd,gw_gnd})
);

defparam sdpx9b_inst_35.READ_MODE = 1'b0;
defparam sdpx9b_inst_35.BIT_WIDTH_0 = 9;
defparam sdpx9b_inst_35.BIT_WIDTH_1 = 9;
defparam sdpx9b_inst_35.BLK_SEL_0 = 3'b001;
defparam sdpx9b_inst_35.BLK_SEL_1 = 3'b001;
defparam sdpx9b_inst_35.RESET_MODE = "SYNC";

SDPX9B sdpx9b_inst_36 (
    .DO({sdpx9b_inst_36_dout_w[26:0],sdpx9b_inst_36_dout[8:0]}),
    .CLKA(clka),
    .CEA(cea),
    .CLKB(clkb),
    .CEB(ceb),
    .OCE(oce),
    .RESET(reset),
    .BLKSELA({gw_gnd,gw_gnd,lut_f_36}),
    .BLKSELB({gw_gnd,gw_gnd,lut_f_76}),
    .ADA({ada[10:0],gw_gnd,gw_gnd,gw_gnd}),
    .DI({gw_gnd,gw_gnd,gw_gnd,gw_gnd,gw_gnd,gw_gnd,gw_gnd,gw_gnd,gw_gnd,gw_gnd,gw_gnd,gw_gnd,gw_gnd,gw_gnd,gw_gnd,gw_gnd,gw_gnd,gw_gnd,gw_gnd,gw_gnd,gw_gnd,gw_gnd,gw_gnd,gw_gnd,gw_gnd,gw_gnd,gw_gnd,din[8:0]}),
    .ADB({adb[10:0],gw_gnd,gw_gnd,gw_gnd})
);

defparam sdpx9b_inst_36.READ_MODE = 1'b0;
defparam sdpx9b_inst_36.BIT_WIDTH_0 = 9;
defparam sdpx9b_inst_36.BIT_WIDTH_1 = 9;
defparam sdpx9b_inst_36.BLK_SEL_0 = 3'b001;
defparam sdpx9b_inst_36.BLK_SEL_1 = 3'b001;
defparam sdpx9b_inst_36.RESET_MODE = "SYNC";

SDPX9B sdpx9b_inst_37 (
    .DO({sdpx9b_inst_37_dout_w[26:0],sdpx9b_inst_37_dout[8:0]}),
    .CLKA(clka),
    .CEA(cea),
    .CLKB(clkb),
    .CEB(ceb),
    .OCE(oce),
    .RESET(reset),
    .BLKSELA({gw_gnd,gw_gnd,lut_f_37}),
    .BLKSELB({gw_gnd,gw_gnd,lut_f_77}),
    .ADA({ada[10:0],gw_gnd,gw_gnd,gw_gnd}),
    .DI({gw_gnd,gw_gnd,gw_gnd,gw_gnd,gw_gnd,gw_gnd,gw_gnd,gw_gnd,gw_gnd,gw_gnd,gw_gnd,gw_gnd,gw_gnd,gw_gnd,gw_gnd,gw_gnd,gw_gnd,gw_gnd,gw_gnd,gw_gnd,gw_gnd,gw_gnd,gw_gnd,gw_gnd,gw_gnd,gw_gnd,gw_gnd,din[8:0]}),
    .ADB({adb[10:0],gw_gnd,gw_gnd,gw_gnd})
);

defparam sdpx9b_inst_37.READ_MODE = 1'b0;
defparam sdpx9b_inst_37.BIT_WIDTH_0 = 9;
defparam sdpx9b_inst_37.BIT_WIDTH_1 = 9;
defparam sdpx9b_inst_37.BLK_SEL_0 = 3'b001;
defparam sdpx9b_inst_37.BLK_SEL_1 = 3'b001;
defparam sdpx9b_inst_37.RESET_MODE = "SYNC";

SDPX9B sdpx9b_inst_38 (
    .DO({sdpx9b_inst_38_dout_w[26:0],sdpx9b_inst_38_dout[8:0]}),
    .CLKA(clka),
    .CEA(cea),
    .CLKB(clkb),
    .CEB(ceb),
    .OCE(oce),
    .RESET(reset),
    .BLKSELA({gw_gnd,gw_gnd,lut_f_38}),
    .BLKSELB({gw_gnd,gw_gnd,lut_f_78}),
    .ADA({ada[10:0],gw_gnd,gw_gnd,gw_gnd}),
    .DI({gw_gnd,gw_gnd,gw_gnd,gw_gnd,gw_gnd,gw_gnd,gw_gnd,gw_gnd,gw_gnd,gw_gnd,gw_gnd,gw_gnd,gw_gnd,gw_gnd,gw_gnd,gw_gnd,gw_gnd,gw_gnd,gw_gnd,gw_gnd,gw_gnd,gw_gnd,gw_gnd,gw_gnd,gw_gnd,gw_gnd,gw_gnd,din[8:0]}),
    .ADB({adb[10:0],gw_gnd,gw_gnd,gw_gnd})
);

defparam sdpx9b_inst_38.READ_MODE = 1'b0;
defparam sdpx9b_inst_38.BIT_WIDTH_0 = 9;
defparam sdpx9b_inst_38.BIT_WIDTH_1 = 9;
defparam sdpx9b_inst_38.BLK_SEL_0 = 3'b001;
defparam sdpx9b_inst_38.BLK_SEL_1 = 3'b001;
defparam sdpx9b_inst_38.RESET_MODE = "SYNC";

SDPX9B sdpx9b_inst_39 (
    .DO({sdpx9b_inst_39_dout_w[26:0],sdpx9b_inst_39_dout[8:0]}),
    .CLKA(clka),
    .CEA(cea),
    .CLKB(clkb),
    .CEB(ceb),
    .OCE(oce),
    .RESET(reset),
    .BLKSELA({gw_gnd,gw_gnd,lut_f_39}),
    .BLKSELB({gw_gnd,gw_gnd,lut_f_79}),
    .ADA({ada[10:0],gw_gnd,gw_gnd,gw_gnd}),
    .DI({gw_gnd,gw_gnd,gw_gnd,gw_gnd,gw_gnd,gw_gnd,gw_gnd,gw_gnd,gw_gnd,gw_gnd,gw_gnd,gw_gnd,gw_gnd,gw_gnd,gw_gnd,gw_gnd,gw_gnd,gw_gnd,gw_gnd,gw_gnd,gw_gnd,gw_gnd,gw_gnd,gw_gnd,gw_gnd,gw_gnd,gw_gnd,din[8:0]}),
    .ADB({adb[10:0],gw_gnd,gw_gnd,gw_gnd})
);

defparam sdpx9b_inst_39.READ_MODE = 1'b0;
defparam sdpx9b_inst_39.BIT_WIDTH_0 = 9;
defparam sdpx9b_inst_39.BIT_WIDTH_1 = 9;
defparam sdpx9b_inst_39.BLK_SEL_0 = 3'b001;
defparam sdpx9b_inst_39.BLK_SEL_1 = 3'b001;
defparam sdpx9b_inst_39.RESET_MODE = "SYNC";

SDPX9B sdpx9b_inst_40 (
    .DO({sdpx9b_inst_40_dout_w[26:0],sdpx9b_inst_40_dout[17:9]}),
    .CLKA(clka),
    .CEA(cea),
    .CLKB(clkb),
    .CEB(ceb),
    .OCE(oce),
    .RESET(reset),
    .BLKSELA({gw_gnd,gw_gnd,lut_f_0}),
    .BLKSELB({gw_gnd,gw_gnd,lut_f_40}),
    .ADA({ada[10:0],gw_gnd,gw_gnd,gw_gnd}),
    .DI({gw_gnd,gw_gnd,gw_gnd,gw_gnd,gw_gnd,gw_gnd,gw_gnd,gw_gnd,gw_gnd,gw_gnd,gw_gnd,gw_gnd,gw_gnd,gw_gnd,gw_gnd,gw_gnd,gw_gnd,gw_gnd,gw_gnd,gw_gnd,gw_gnd,gw_gnd,gw_gnd,gw_gnd,gw_gnd,gw_gnd,gw_gnd,din[17:9]}),
    .ADB({adb[10:0],gw_gnd,gw_gnd,gw_gnd})
);

defparam sdpx9b_inst_40.READ_MODE = 1'b0;
defparam sdpx9b_inst_40.BIT_WIDTH_0 = 9;
defparam sdpx9b_inst_40.BIT_WIDTH_1 = 9;
defparam sdpx9b_inst_40.BLK_SEL_0 = 3'b001;
defparam sdpx9b_inst_40.BLK_SEL_1 = 3'b001;
defparam sdpx9b_inst_40.RESET_MODE = "SYNC";

SDPX9B sdpx9b_inst_41 (
    .DO({sdpx9b_inst_41_dout_w[26:0],sdpx9b_inst_41_dout[17:9]}),
    .CLKA(clka),
    .CEA(cea),
    .CLKB(clkb),
    .CEB(ceb),
    .OCE(oce),
    .RESET(reset),
    .BLKSELA({gw_gnd,gw_gnd,lut_f_1}),
    .BLKSELB({gw_gnd,gw_gnd,lut_f_41}),
    .ADA({ada[10:0],gw_gnd,gw_gnd,gw_gnd}),
    .DI({gw_gnd,gw_gnd,gw_gnd,gw_gnd,gw_gnd,gw_gnd,gw_gnd,gw_gnd,gw_gnd,gw_gnd,gw_gnd,gw_gnd,gw_gnd,gw_gnd,gw_gnd,gw_gnd,gw_gnd,gw_gnd,gw_gnd,gw_gnd,gw_gnd,gw_gnd,gw_gnd,gw_gnd,gw_gnd,gw_gnd,gw_gnd,din[17:9]}),
    .ADB({adb[10:0],gw_gnd,gw_gnd,gw_gnd})
);

defparam sdpx9b_inst_41.READ_MODE = 1'b0;
defparam sdpx9b_inst_41.BIT_WIDTH_0 = 9;
defparam sdpx9b_inst_41.BIT_WIDTH_1 = 9;
defparam sdpx9b_inst_41.BLK_SEL_0 = 3'b001;
defparam sdpx9b_inst_41.BLK_SEL_1 = 3'b001;
defparam sdpx9b_inst_41.RESET_MODE = "SYNC";

SDPX9B sdpx9b_inst_42 (
    .DO({sdpx9b_inst_42_dout_w[26:0],sdpx9b_inst_42_dout[17:9]}),
    .CLKA(clka),
    .CEA(cea),
    .CLKB(clkb),
    .CEB(ceb),
    .OCE(oce),
    .RESET(reset),
    .BLKSELA({gw_gnd,gw_gnd,lut_f_2}),
    .BLKSELB({gw_gnd,gw_gnd,lut_f_42}),
    .ADA({ada[10:0],gw_gnd,gw_gnd,gw_gnd}),
    .DI({gw_gnd,gw_gnd,gw_gnd,gw_gnd,gw_gnd,gw_gnd,gw_gnd,gw_gnd,gw_gnd,gw_gnd,gw_gnd,gw_gnd,gw_gnd,gw_gnd,gw_gnd,gw_gnd,gw_gnd,gw_gnd,gw_gnd,gw_gnd,gw_gnd,gw_gnd,gw_gnd,gw_gnd,gw_gnd,gw_gnd,gw_gnd,din[17:9]}),
    .ADB({adb[10:0],gw_gnd,gw_gnd,gw_gnd})
);

defparam sdpx9b_inst_42.READ_MODE = 1'b0;
defparam sdpx9b_inst_42.BIT_WIDTH_0 = 9;
defparam sdpx9b_inst_42.BIT_WIDTH_1 = 9;
defparam sdpx9b_inst_42.BLK_SEL_0 = 3'b001;
defparam sdpx9b_inst_42.BLK_SEL_1 = 3'b001;
defparam sdpx9b_inst_42.RESET_MODE = "SYNC";

SDPX9B sdpx9b_inst_43 (
    .DO({sdpx9b_inst_43_dout_w[26:0],sdpx9b_inst_43_dout[17:9]}),
    .CLKA(clka),
    .CEA(cea),
    .CLKB(clkb),
    .CEB(ceb),
    .OCE(oce),
    .RESET(reset),
    .BLKSELA({gw_gnd,gw_gnd,lut_f_3}),
    .BLKSELB({gw_gnd,gw_gnd,lut_f_43}),
    .ADA({ada[10:0],gw_gnd,gw_gnd,gw_gnd}),
    .DI({gw_gnd,gw_gnd,gw_gnd,gw_gnd,gw_gnd,gw_gnd,gw_gnd,gw_gnd,gw_gnd,gw_gnd,gw_gnd,gw_gnd,gw_gnd,gw_gnd,gw_gnd,gw_gnd,gw_gnd,gw_gnd,gw_gnd,gw_gnd,gw_gnd,gw_gnd,gw_gnd,gw_gnd,gw_gnd,gw_gnd,gw_gnd,din[17:9]}),
    .ADB({adb[10:0],gw_gnd,gw_gnd,gw_gnd})
);

defparam sdpx9b_inst_43.READ_MODE = 1'b0;
defparam sdpx9b_inst_43.BIT_WIDTH_0 = 9;
defparam sdpx9b_inst_43.BIT_WIDTH_1 = 9;
defparam sdpx9b_inst_43.BLK_SEL_0 = 3'b001;
defparam sdpx9b_inst_43.BLK_SEL_1 = 3'b001;
defparam sdpx9b_inst_43.RESET_MODE = "SYNC";

SDPX9B sdpx9b_inst_44 (
    .DO({sdpx9b_inst_44_dout_w[26:0],sdpx9b_inst_44_dout[17:9]}),
    .CLKA(clka),
    .CEA(cea),
    .CLKB(clkb),
    .CEB(ceb),
    .OCE(oce),
    .RESET(reset),
    .BLKSELA({gw_gnd,gw_gnd,lut_f_4}),
    .BLKSELB({gw_gnd,gw_gnd,lut_f_44}),
    .ADA({ada[10:0],gw_gnd,gw_gnd,gw_gnd}),
    .DI({gw_gnd,gw_gnd,gw_gnd,gw_gnd,gw_gnd,gw_gnd,gw_gnd,gw_gnd,gw_gnd,gw_gnd,gw_gnd,gw_gnd,gw_gnd,gw_gnd,gw_gnd,gw_gnd,gw_gnd,gw_gnd,gw_gnd,gw_gnd,gw_gnd,gw_gnd,gw_gnd,gw_gnd,gw_gnd,gw_gnd,gw_gnd,din[17:9]}),
    .ADB({adb[10:0],gw_gnd,gw_gnd,gw_gnd})
);

defparam sdpx9b_inst_44.READ_MODE = 1'b0;
defparam sdpx9b_inst_44.BIT_WIDTH_0 = 9;
defparam sdpx9b_inst_44.BIT_WIDTH_1 = 9;
defparam sdpx9b_inst_44.BLK_SEL_0 = 3'b001;
defparam sdpx9b_inst_44.BLK_SEL_1 = 3'b001;
defparam sdpx9b_inst_44.RESET_MODE = "SYNC";

SDPX9B sdpx9b_inst_45 (
    .DO({sdpx9b_inst_45_dout_w[26:0],sdpx9b_inst_45_dout[17:9]}),
    .CLKA(clka),
    .CEA(cea),
    .CLKB(clkb),
    .CEB(ceb),
    .OCE(oce),
    .RESET(reset),
    .BLKSELA({gw_gnd,gw_gnd,lut_f_5}),
    .BLKSELB({gw_gnd,gw_gnd,lut_f_45}),
    .ADA({ada[10:0],gw_gnd,gw_gnd,gw_gnd}),
    .DI({gw_gnd,gw_gnd,gw_gnd,gw_gnd,gw_gnd,gw_gnd,gw_gnd,gw_gnd,gw_gnd,gw_gnd,gw_gnd,gw_gnd,gw_gnd,gw_gnd,gw_gnd,gw_gnd,gw_gnd,gw_gnd,gw_gnd,gw_gnd,gw_gnd,gw_gnd,gw_gnd,gw_gnd,gw_gnd,gw_gnd,gw_gnd,din[17:9]}),
    .ADB({adb[10:0],gw_gnd,gw_gnd,gw_gnd})
);

defparam sdpx9b_inst_45.READ_MODE = 1'b0;
defparam sdpx9b_inst_45.BIT_WIDTH_0 = 9;
defparam sdpx9b_inst_45.BIT_WIDTH_1 = 9;
defparam sdpx9b_inst_45.BLK_SEL_0 = 3'b001;
defparam sdpx9b_inst_45.BLK_SEL_1 = 3'b001;
defparam sdpx9b_inst_45.RESET_MODE = "SYNC";

SDPX9B sdpx9b_inst_46 (
    .DO({sdpx9b_inst_46_dout_w[26:0],sdpx9b_inst_46_dout[17:9]}),
    .CLKA(clka),
    .CEA(cea),
    .CLKB(clkb),
    .CEB(ceb),
    .OCE(oce),
    .RESET(reset),
    .BLKSELA({gw_gnd,gw_gnd,lut_f_6}),
    .BLKSELB({gw_gnd,gw_gnd,lut_f_46}),
    .ADA({ada[10:0],gw_gnd,gw_gnd,gw_gnd}),
    .DI({gw_gnd,gw_gnd,gw_gnd,gw_gnd,gw_gnd,gw_gnd,gw_gnd,gw_gnd,gw_gnd,gw_gnd,gw_gnd,gw_gnd,gw_gnd,gw_gnd,gw_gnd,gw_gnd,gw_gnd,gw_gnd,gw_gnd,gw_gnd,gw_gnd,gw_gnd,gw_gnd,gw_gnd,gw_gnd,gw_gnd,gw_gnd,din[17:9]}),
    .ADB({adb[10:0],gw_gnd,gw_gnd,gw_gnd})
);

defparam sdpx9b_inst_46.READ_MODE = 1'b0;
defparam sdpx9b_inst_46.BIT_WIDTH_0 = 9;
defparam sdpx9b_inst_46.BIT_WIDTH_1 = 9;
defparam sdpx9b_inst_46.BLK_SEL_0 = 3'b001;
defparam sdpx9b_inst_46.BLK_SEL_1 = 3'b001;
defparam sdpx9b_inst_46.RESET_MODE = "SYNC";

SDPX9B sdpx9b_inst_47 (
    .DO({sdpx9b_inst_47_dout_w[26:0],sdpx9b_inst_47_dout[17:9]}),
    .CLKA(clka),
    .CEA(cea),
    .CLKB(clkb),
    .CEB(ceb),
    .OCE(oce),
    .RESET(reset),
    .BLKSELA({gw_gnd,gw_gnd,lut_f_7}),
    .BLKSELB({gw_gnd,gw_gnd,lut_f_47}),
    .ADA({ada[10:0],gw_gnd,gw_gnd,gw_gnd}),
    .DI({gw_gnd,gw_gnd,gw_gnd,gw_gnd,gw_gnd,gw_gnd,gw_gnd,gw_gnd,gw_gnd,gw_gnd,gw_gnd,gw_gnd,gw_gnd,gw_gnd,gw_gnd,gw_gnd,gw_gnd,gw_gnd,gw_gnd,gw_gnd,gw_gnd,gw_gnd,gw_gnd,gw_gnd,gw_gnd,gw_gnd,gw_gnd,din[17:9]}),
    .ADB({adb[10:0],gw_gnd,gw_gnd,gw_gnd})
);

defparam sdpx9b_inst_47.READ_MODE = 1'b0;
defparam sdpx9b_inst_47.BIT_WIDTH_0 = 9;
defparam sdpx9b_inst_47.BIT_WIDTH_1 = 9;
defparam sdpx9b_inst_47.BLK_SEL_0 = 3'b001;
defparam sdpx9b_inst_47.BLK_SEL_1 = 3'b001;
defparam sdpx9b_inst_47.RESET_MODE = "SYNC";

SDPX9B sdpx9b_inst_48 (
    .DO({sdpx9b_inst_48_dout_w[26:0],sdpx9b_inst_48_dout[17:9]}),
    .CLKA(clka),
    .CEA(cea),
    .CLKB(clkb),
    .CEB(ceb),
    .OCE(oce),
    .RESET(reset),
    .BLKSELA({gw_gnd,gw_gnd,lut_f_8}),
    .BLKSELB({gw_gnd,gw_gnd,lut_f_48}),
    .ADA({ada[10:0],gw_gnd,gw_gnd,gw_gnd}),
    .DI({gw_gnd,gw_gnd,gw_gnd,gw_gnd,gw_gnd,gw_gnd,gw_gnd,gw_gnd,gw_gnd,gw_gnd,gw_gnd,gw_gnd,gw_gnd,gw_gnd,gw_gnd,gw_gnd,gw_gnd,gw_gnd,gw_gnd,gw_gnd,gw_gnd,gw_gnd,gw_gnd,gw_gnd,gw_gnd,gw_gnd,gw_gnd,din[17:9]}),
    .ADB({adb[10:0],gw_gnd,gw_gnd,gw_gnd})
);

defparam sdpx9b_inst_48.READ_MODE = 1'b0;
defparam sdpx9b_inst_48.BIT_WIDTH_0 = 9;
defparam sdpx9b_inst_48.BIT_WIDTH_1 = 9;
defparam sdpx9b_inst_48.BLK_SEL_0 = 3'b001;
defparam sdpx9b_inst_48.BLK_SEL_1 = 3'b001;
defparam sdpx9b_inst_48.RESET_MODE = "SYNC";

SDPX9B sdpx9b_inst_49 (
    .DO({sdpx9b_inst_49_dout_w[26:0],sdpx9b_inst_49_dout[17:9]}),
    .CLKA(clka),
    .CEA(cea),
    .CLKB(clkb),
    .CEB(ceb),
    .OCE(oce),
    .RESET(reset),
    .BLKSELA({gw_gnd,gw_gnd,lut_f_9}),
    .BLKSELB({gw_gnd,gw_gnd,lut_f_49}),
    .ADA({ada[10:0],gw_gnd,gw_gnd,gw_gnd}),
    .DI({gw_gnd,gw_gnd,gw_gnd,gw_gnd,gw_gnd,gw_gnd,gw_gnd,gw_gnd,gw_gnd,gw_gnd,gw_gnd,gw_gnd,gw_gnd,gw_gnd,gw_gnd,gw_gnd,gw_gnd,gw_gnd,gw_gnd,gw_gnd,gw_gnd,gw_gnd,gw_gnd,gw_gnd,gw_gnd,gw_gnd,gw_gnd,din[17:9]}),
    .ADB({adb[10:0],gw_gnd,gw_gnd,gw_gnd})
);

defparam sdpx9b_inst_49.READ_MODE = 1'b0;
defparam sdpx9b_inst_49.BIT_WIDTH_0 = 9;
defparam sdpx9b_inst_49.BIT_WIDTH_1 = 9;
defparam sdpx9b_inst_49.BLK_SEL_0 = 3'b001;
defparam sdpx9b_inst_49.BLK_SEL_1 = 3'b001;
defparam sdpx9b_inst_49.RESET_MODE = "SYNC";

SDPX9B sdpx9b_inst_50 (
    .DO({sdpx9b_inst_50_dout_w[26:0],sdpx9b_inst_50_dout[17:9]}),
    .CLKA(clka),
    .CEA(cea),
    .CLKB(clkb),
    .CEB(ceb),
    .OCE(oce),
    .RESET(reset),
    .BLKSELA({gw_gnd,gw_gnd,lut_f_10}),
    .BLKSELB({gw_gnd,gw_gnd,lut_f_50}),
    .ADA({ada[10:0],gw_gnd,gw_gnd,gw_gnd}),
    .DI({gw_gnd,gw_gnd,gw_gnd,gw_gnd,gw_gnd,gw_gnd,gw_gnd,gw_gnd,gw_gnd,gw_gnd,gw_gnd,gw_gnd,gw_gnd,gw_gnd,gw_gnd,gw_gnd,gw_gnd,gw_gnd,gw_gnd,gw_gnd,gw_gnd,gw_gnd,gw_gnd,gw_gnd,gw_gnd,gw_gnd,gw_gnd,din[17:9]}),
    .ADB({adb[10:0],gw_gnd,gw_gnd,gw_gnd})
);

defparam sdpx9b_inst_50.READ_MODE = 1'b0;
defparam sdpx9b_inst_50.BIT_WIDTH_0 = 9;
defparam sdpx9b_inst_50.BIT_WIDTH_1 = 9;
defparam sdpx9b_inst_50.BLK_SEL_0 = 3'b001;
defparam sdpx9b_inst_50.BLK_SEL_1 = 3'b001;
defparam sdpx9b_inst_50.RESET_MODE = "SYNC";

SDPX9B sdpx9b_inst_51 (
    .DO({sdpx9b_inst_51_dout_w[26:0],sdpx9b_inst_51_dout[17:9]}),
    .CLKA(clka),
    .CEA(cea),
    .CLKB(clkb),
    .CEB(ceb),
    .OCE(oce),
    .RESET(reset),
    .BLKSELA({gw_gnd,gw_gnd,lut_f_11}),
    .BLKSELB({gw_gnd,gw_gnd,lut_f_51}),
    .ADA({ada[10:0],gw_gnd,gw_gnd,gw_gnd}),
    .DI({gw_gnd,gw_gnd,gw_gnd,gw_gnd,gw_gnd,gw_gnd,gw_gnd,gw_gnd,gw_gnd,gw_gnd,gw_gnd,gw_gnd,gw_gnd,gw_gnd,gw_gnd,gw_gnd,gw_gnd,gw_gnd,gw_gnd,gw_gnd,gw_gnd,gw_gnd,gw_gnd,gw_gnd,gw_gnd,gw_gnd,gw_gnd,din[17:9]}),
    .ADB({adb[10:0],gw_gnd,gw_gnd,gw_gnd})
);

defparam sdpx9b_inst_51.READ_MODE = 1'b0;
defparam sdpx9b_inst_51.BIT_WIDTH_0 = 9;
defparam sdpx9b_inst_51.BIT_WIDTH_1 = 9;
defparam sdpx9b_inst_51.BLK_SEL_0 = 3'b001;
defparam sdpx9b_inst_51.BLK_SEL_1 = 3'b001;
defparam sdpx9b_inst_51.RESET_MODE = "SYNC";

SDPX9B sdpx9b_inst_52 (
    .DO({sdpx9b_inst_52_dout_w[26:0],sdpx9b_inst_52_dout[17:9]}),
    .CLKA(clka),
    .CEA(cea),
    .CLKB(clkb),
    .CEB(ceb),
    .OCE(oce),
    .RESET(reset),
    .BLKSELA({gw_gnd,gw_gnd,lut_f_12}),
    .BLKSELB({gw_gnd,gw_gnd,lut_f_52}),
    .ADA({ada[10:0],gw_gnd,gw_gnd,gw_gnd}),
    .DI({gw_gnd,gw_gnd,gw_gnd,gw_gnd,gw_gnd,gw_gnd,gw_gnd,gw_gnd,gw_gnd,gw_gnd,gw_gnd,gw_gnd,gw_gnd,gw_gnd,gw_gnd,gw_gnd,gw_gnd,gw_gnd,gw_gnd,gw_gnd,gw_gnd,gw_gnd,gw_gnd,gw_gnd,gw_gnd,gw_gnd,gw_gnd,din[17:9]}),
    .ADB({adb[10:0],gw_gnd,gw_gnd,gw_gnd})
);

defparam sdpx9b_inst_52.READ_MODE = 1'b0;
defparam sdpx9b_inst_52.BIT_WIDTH_0 = 9;
defparam sdpx9b_inst_52.BIT_WIDTH_1 = 9;
defparam sdpx9b_inst_52.BLK_SEL_0 = 3'b001;
defparam sdpx9b_inst_52.BLK_SEL_1 = 3'b001;
defparam sdpx9b_inst_52.RESET_MODE = "SYNC";

SDPX9B sdpx9b_inst_53 (
    .DO({sdpx9b_inst_53_dout_w[26:0],sdpx9b_inst_53_dout[17:9]}),
    .CLKA(clka),
    .CEA(cea),
    .CLKB(clkb),
    .CEB(ceb),
    .OCE(oce),
    .RESET(reset),
    .BLKSELA({gw_gnd,gw_gnd,lut_f_13}),
    .BLKSELB({gw_gnd,gw_gnd,lut_f_53}),
    .ADA({ada[10:0],gw_gnd,gw_gnd,gw_gnd}),
    .DI({gw_gnd,gw_gnd,gw_gnd,gw_gnd,gw_gnd,gw_gnd,gw_gnd,gw_gnd,gw_gnd,gw_gnd,gw_gnd,gw_gnd,gw_gnd,gw_gnd,gw_gnd,gw_gnd,gw_gnd,gw_gnd,gw_gnd,gw_gnd,gw_gnd,gw_gnd,gw_gnd,gw_gnd,gw_gnd,gw_gnd,gw_gnd,din[17:9]}),
    .ADB({adb[10:0],gw_gnd,gw_gnd,gw_gnd})
);

defparam sdpx9b_inst_53.READ_MODE = 1'b0;
defparam sdpx9b_inst_53.BIT_WIDTH_0 = 9;
defparam sdpx9b_inst_53.BIT_WIDTH_1 = 9;
defparam sdpx9b_inst_53.BLK_SEL_0 = 3'b001;
defparam sdpx9b_inst_53.BLK_SEL_1 = 3'b001;
defparam sdpx9b_inst_53.RESET_MODE = "SYNC";

SDPX9B sdpx9b_inst_54 (
    .DO({sdpx9b_inst_54_dout_w[26:0],sdpx9b_inst_54_dout[17:9]}),
    .CLKA(clka),
    .CEA(cea),
    .CLKB(clkb),
    .CEB(ceb),
    .OCE(oce),
    .RESET(reset),
    .BLKSELA({gw_gnd,gw_gnd,lut_f_14}),
    .BLKSELB({gw_gnd,gw_gnd,lut_f_54}),
    .ADA({ada[10:0],gw_gnd,gw_gnd,gw_gnd}),
    .DI({gw_gnd,gw_gnd,gw_gnd,gw_gnd,gw_gnd,gw_gnd,gw_gnd,gw_gnd,gw_gnd,gw_gnd,gw_gnd,gw_gnd,gw_gnd,gw_gnd,gw_gnd,gw_gnd,gw_gnd,gw_gnd,gw_gnd,gw_gnd,gw_gnd,gw_gnd,gw_gnd,gw_gnd,gw_gnd,gw_gnd,gw_gnd,din[17:9]}),
    .ADB({adb[10:0],gw_gnd,gw_gnd,gw_gnd})
);

defparam sdpx9b_inst_54.READ_MODE = 1'b0;
defparam sdpx9b_inst_54.BIT_WIDTH_0 = 9;
defparam sdpx9b_inst_54.BIT_WIDTH_1 = 9;
defparam sdpx9b_inst_54.BLK_SEL_0 = 3'b001;
defparam sdpx9b_inst_54.BLK_SEL_1 = 3'b001;
defparam sdpx9b_inst_54.RESET_MODE = "SYNC";

SDPX9B sdpx9b_inst_55 (
    .DO({sdpx9b_inst_55_dout_w[26:0],sdpx9b_inst_55_dout[17:9]}),
    .CLKA(clka),
    .CEA(cea),
    .CLKB(clkb),
    .CEB(ceb),
    .OCE(oce),
    .RESET(reset),
    .BLKSELA({gw_gnd,gw_gnd,lut_f_15}),
    .BLKSELB({gw_gnd,gw_gnd,lut_f_55}),
    .ADA({ada[10:0],gw_gnd,gw_gnd,gw_gnd}),
    .DI({gw_gnd,gw_gnd,gw_gnd,gw_gnd,gw_gnd,gw_gnd,gw_gnd,gw_gnd,gw_gnd,gw_gnd,gw_gnd,gw_gnd,gw_gnd,gw_gnd,gw_gnd,gw_gnd,gw_gnd,gw_gnd,gw_gnd,gw_gnd,gw_gnd,gw_gnd,gw_gnd,gw_gnd,gw_gnd,gw_gnd,gw_gnd,din[17:9]}),
    .ADB({adb[10:0],gw_gnd,gw_gnd,gw_gnd})
);

defparam sdpx9b_inst_55.READ_MODE = 1'b0;
defparam sdpx9b_inst_55.BIT_WIDTH_0 = 9;
defparam sdpx9b_inst_55.BIT_WIDTH_1 = 9;
defparam sdpx9b_inst_55.BLK_SEL_0 = 3'b001;
defparam sdpx9b_inst_55.BLK_SEL_1 = 3'b001;
defparam sdpx9b_inst_55.RESET_MODE = "SYNC";

SDPX9B sdpx9b_inst_56 (
    .DO({sdpx9b_inst_56_dout_w[26:0],sdpx9b_inst_56_dout[17:9]}),
    .CLKA(clka),
    .CEA(cea),
    .CLKB(clkb),
    .CEB(ceb),
    .OCE(oce),
    .RESET(reset),
    .BLKSELA({gw_gnd,gw_gnd,lut_f_16}),
    .BLKSELB({gw_gnd,gw_gnd,lut_f_56}),
    .ADA({ada[10:0],gw_gnd,gw_gnd,gw_gnd}),
    .DI({gw_gnd,gw_gnd,gw_gnd,gw_gnd,gw_gnd,gw_gnd,gw_gnd,gw_gnd,gw_gnd,gw_gnd,gw_gnd,gw_gnd,gw_gnd,gw_gnd,gw_gnd,gw_gnd,gw_gnd,gw_gnd,gw_gnd,gw_gnd,gw_gnd,gw_gnd,gw_gnd,gw_gnd,gw_gnd,gw_gnd,gw_gnd,din[17:9]}),
    .ADB({adb[10:0],gw_gnd,gw_gnd,gw_gnd})
);

defparam sdpx9b_inst_56.READ_MODE = 1'b0;
defparam sdpx9b_inst_56.BIT_WIDTH_0 = 9;
defparam sdpx9b_inst_56.BIT_WIDTH_1 = 9;
defparam sdpx9b_inst_56.BLK_SEL_0 = 3'b001;
defparam sdpx9b_inst_56.BLK_SEL_1 = 3'b001;
defparam sdpx9b_inst_56.RESET_MODE = "SYNC";

SDPX9B sdpx9b_inst_57 (
    .DO({sdpx9b_inst_57_dout_w[26:0],sdpx9b_inst_57_dout[17:9]}),
    .CLKA(clka),
    .CEA(cea),
    .CLKB(clkb),
    .CEB(ceb),
    .OCE(oce),
    .RESET(reset),
    .BLKSELA({gw_gnd,gw_gnd,lut_f_17}),
    .BLKSELB({gw_gnd,gw_gnd,lut_f_57}),
    .ADA({ada[10:0],gw_gnd,gw_gnd,gw_gnd}),
    .DI({gw_gnd,gw_gnd,gw_gnd,gw_gnd,gw_gnd,gw_gnd,gw_gnd,gw_gnd,gw_gnd,gw_gnd,gw_gnd,gw_gnd,gw_gnd,gw_gnd,gw_gnd,gw_gnd,gw_gnd,gw_gnd,gw_gnd,gw_gnd,gw_gnd,gw_gnd,gw_gnd,gw_gnd,gw_gnd,gw_gnd,gw_gnd,din[17:9]}),
    .ADB({adb[10:0],gw_gnd,gw_gnd,gw_gnd})
);

defparam sdpx9b_inst_57.READ_MODE = 1'b0;
defparam sdpx9b_inst_57.BIT_WIDTH_0 = 9;
defparam sdpx9b_inst_57.BIT_WIDTH_1 = 9;
defparam sdpx9b_inst_57.BLK_SEL_0 = 3'b001;
defparam sdpx9b_inst_57.BLK_SEL_1 = 3'b001;
defparam sdpx9b_inst_57.RESET_MODE = "SYNC";

SDPX9B sdpx9b_inst_58 (
    .DO({sdpx9b_inst_58_dout_w[26:0],sdpx9b_inst_58_dout[17:9]}),
    .CLKA(clka),
    .CEA(cea),
    .CLKB(clkb),
    .CEB(ceb),
    .OCE(oce),
    .RESET(reset),
    .BLKSELA({gw_gnd,gw_gnd,lut_f_18}),
    .BLKSELB({gw_gnd,gw_gnd,lut_f_58}),
    .ADA({ada[10:0],gw_gnd,gw_gnd,gw_gnd}),
    .DI({gw_gnd,gw_gnd,gw_gnd,gw_gnd,gw_gnd,gw_gnd,gw_gnd,gw_gnd,gw_gnd,gw_gnd,gw_gnd,gw_gnd,gw_gnd,gw_gnd,gw_gnd,gw_gnd,gw_gnd,gw_gnd,gw_gnd,gw_gnd,gw_gnd,gw_gnd,gw_gnd,gw_gnd,gw_gnd,gw_gnd,gw_gnd,din[17:9]}),
    .ADB({adb[10:0],gw_gnd,gw_gnd,gw_gnd})
);

defparam sdpx9b_inst_58.READ_MODE = 1'b0;
defparam sdpx9b_inst_58.BIT_WIDTH_0 = 9;
defparam sdpx9b_inst_58.BIT_WIDTH_1 = 9;
defparam sdpx9b_inst_58.BLK_SEL_0 = 3'b001;
defparam sdpx9b_inst_58.BLK_SEL_1 = 3'b001;
defparam sdpx9b_inst_58.RESET_MODE = "SYNC";

SDPX9B sdpx9b_inst_59 (
    .DO({sdpx9b_inst_59_dout_w[26:0],sdpx9b_inst_59_dout[17:9]}),
    .CLKA(clka),
    .CEA(cea),
    .CLKB(clkb),
    .CEB(ceb),
    .OCE(oce),
    .RESET(reset),
    .BLKSELA({gw_gnd,gw_gnd,lut_f_19}),
    .BLKSELB({gw_gnd,gw_gnd,lut_f_59}),
    .ADA({ada[10:0],gw_gnd,gw_gnd,gw_gnd}),
    .DI({gw_gnd,gw_gnd,gw_gnd,gw_gnd,gw_gnd,gw_gnd,gw_gnd,gw_gnd,gw_gnd,gw_gnd,gw_gnd,gw_gnd,gw_gnd,gw_gnd,gw_gnd,gw_gnd,gw_gnd,gw_gnd,gw_gnd,gw_gnd,gw_gnd,gw_gnd,gw_gnd,gw_gnd,gw_gnd,gw_gnd,gw_gnd,din[17:9]}),
    .ADB({adb[10:0],gw_gnd,gw_gnd,gw_gnd})
);

defparam sdpx9b_inst_59.READ_MODE = 1'b0;
defparam sdpx9b_inst_59.BIT_WIDTH_0 = 9;
defparam sdpx9b_inst_59.BIT_WIDTH_1 = 9;
defparam sdpx9b_inst_59.BLK_SEL_0 = 3'b001;
defparam sdpx9b_inst_59.BLK_SEL_1 = 3'b001;
defparam sdpx9b_inst_59.RESET_MODE = "SYNC";

SDPX9B sdpx9b_inst_60 (
    .DO({sdpx9b_inst_60_dout_w[26:0],sdpx9b_inst_60_dout[17:9]}),
    .CLKA(clka),
    .CEA(cea),
    .CLKB(clkb),
    .CEB(ceb),
    .OCE(oce),
    .RESET(reset),
    .BLKSELA({gw_gnd,gw_gnd,lut_f_20}),
    .BLKSELB({gw_gnd,gw_gnd,lut_f_60}),
    .ADA({ada[10:0],gw_gnd,gw_gnd,gw_gnd}),
    .DI({gw_gnd,gw_gnd,gw_gnd,gw_gnd,gw_gnd,gw_gnd,gw_gnd,gw_gnd,gw_gnd,gw_gnd,gw_gnd,gw_gnd,gw_gnd,gw_gnd,gw_gnd,gw_gnd,gw_gnd,gw_gnd,gw_gnd,gw_gnd,gw_gnd,gw_gnd,gw_gnd,gw_gnd,gw_gnd,gw_gnd,gw_gnd,din[17:9]}),
    .ADB({adb[10:0],gw_gnd,gw_gnd,gw_gnd})
);

defparam sdpx9b_inst_60.READ_MODE = 1'b0;
defparam sdpx9b_inst_60.BIT_WIDTH_0 = 9;
defparam sdpx9b_inst_60.BIT_WIDTH_1 = 9;
defparam sdpx9b_inst_60.BLK_SEL_0 = 3'b001;
defparam sdpx9b_inst_60.BLK_SEL_1 = 3'b001;
defparam sdpx9b_inst_60.RESET_MODE = "SYNC";

SDPX9B sdpx9b_inst_61 (
    .DO({sdpx9b_inst_61_dout_w[26:0],sdpx9b_inst_61_dout[17:9]}),
    .CLKA(clka),
    .CEA(cea),
    .CLKB(clkb),
    .CEB(ceb),
    .OCE(oce),
    .RESET(reset),
    .BLKSELA({gw_gnd,gw_gnd,lut_f_21}),
    .BLKSELB({gw_gnd,gw_gnd,lut_f_61}),
    .ADA({ada[10:0],gw_gnd,gw_gnd,gw_gnd}),
    .DI({gw_gnd,gw_gnd,gw_gnd,gw_gnd,gw_gnd,gw_gnd,gw_gnd,gw_gnd,gw_gnd,gw_gnd,gw_gnd,gw_gnd,gw_gnd,gw_gnd,gw_gnd,gw_gnd,gw_gnd,gw_gnd,gw_gnd,gw_gnd,gw_gnd,gw_gnd,gw_gnd,gw_gnd,gw_gnd,gw_gnd,gw_gnd,din[17:9]}),
    .ADB({adb[10:0],gw_gnd,gw_gnd,gw_gnd})
);

defparam sdpx9b_inst_61.READ_MODE = 1'b0;
defparam sdpx9b_inst_61.BIT_WIDTH_0 = 9;
defparam sdpx9b_inst_61.BIT_WIDTH_1 = 9;
defparam sdpx9b_inst_61.BLK_SEL_0 = 3'b001;
defparam sdpx9b_inst_61.BLK_SEL_1 = 3'b001;
defparam sdpx9b_inst_61.RESET_MODE = "SYNC";

SDPX9B sdpx9b_inst_62 (
    .DO({sdpx9b_inst_62_dout_w[26:0],sdpx9b_inst_62_dout[17:9]}),
    .CLKA(clka),
    .CEA(cea),
    .CLKB(clkb),
    .CEB(ceb),
    .OCE(oce),
    .RESET(reset),
    .BLKSELA({gw_gnd,gw_gnd,lut_f_22}),
    .BLKSELB({gw_gnd,gw_gnd,lut_f_62}),
    .ADA({ada[10:0],gw_gnd,gw_gnd,gw_gnd}),
    .DI({gw_gnd,gw_gnd,gw_gnd,gw_gnd,gw_gnd,gw_gnd,gw_gnd,gw_gnd,gw_gnd,gw_gnd,gw_gnd,gw_gnd,gw_gnd,gw_gnd,gw_gnd,gw_gnd,gw_gnd,gw_gnd,gw_gnd,gw_gnd,gw_gnd,gw_gnd,gw_gnd,gw_gnd,gw_gnd,gw_gnd,gw_gnd,din[17:9]}),
    .ADB({adb[10:0],gw_gnd,gw_gnd,gw_gnd})
);

defparam sdpx9b_inst_62.READ_MODE = 1'b0;
defparam sdpx9b_inst_62.BIT_WIDTH_0 = 9;
defparam sdpx9b_inst_62.BIT_WIDTH_1 = 9;
defparam sdpx9b_inst_62.BLK_SEL_0 = 3'b001;
defparam sdpx9b_inst_62.BLK_SEL_1 = 3'b001;
defparam sdpx9b_inst_62.RESET_MODE = "SYNC";

SDPX9B sdpx9b_inst_63 (
    .DO({sdpx9b_inst_63_dout_w[26:0],sdpx9b_inst_63_dout[17:9]}),
    .CLKA(clka),
    .CEA(cea),
    .CLKB(clkb),
    .CEB(ceb),
    .OCE(oce),
    .RESET(reset),
    .BLKSELA({gw_gnd,gw_gnd,lut_f_23}),
    .BLKSELB({gw_gnd,gw_gnd,lut_f_63}),
    .ADA({ada[10:0],gw_gnd,gw_gnd,gw_gnd}),
    .DI({gw_gnd,gw_gnd,gw_gnd,gw_gnd,gw_gnd,gw_gnd,gw_gnd,gw_gnd,gw_gnd,gw_gnd,gw_gnd,gw_gnd,gw_gnd,gw_gnd,gw_gnd,gw_gnd,gw_gnd,gw_gnd,gw_gnd,gw_gnd,gw_gnd,gw_gnd,gw_gnd,gw_gnd,gw_gnd,gw_gnd,gw_gnd,din[17:9]}),
    .ADB({adb[10:0],gw_gnd,gw_gnd,gw_gnd})
);

defparam sdpx9b_inst_63.READ_MODE = 1'b0;
defparam sdpx9b_inst_63.BIT_WIDTH_0 = 9;
defparam sdpx9b_inst_63.BIT_WIDTH_1 = 9;
defparam sdpx9b_inst_63.BLK_SEL_0 = 3'b001;
defparam sdpx9b_inst_63.BLK_SEL_1 = 3'b001;
defparam sdpx9b_inst_63.RESET_MODE = "SYNC";

SDPX9B sdpx9b_inst_64 (
    .DO({sdpx9b_inst_64_dout_w[26:0],sdpx9b_inst_64_dout[17:9]}),
    .CLKA(clka),
    .CEA(cea),
    .CLKB(clkb),
    .CEB(ceb),
    .OCE(oce),
    .RESET(reset),
    .BLKSELA({gw_gnd,gw_gnd,lut_f_24}),
    .BLKSELB({gw_gnd,gw_gnd,lut_f_64}),
    .ADA({ada[10:0],gw_gnd,gw_gnd,gw_gnd}),
    .DI({gw_gnd,gw_gnd,gw_gnd,gw_gnd,gw_gnd,gw_gnd,gw_gnd,gw_gnd,gw_gnd,gw_gnd,gw_gnd,gw_gnd,gw_gnd,gw_gnd,gw_gnd,gw_gnd,gw_gnd,gw_gnd,gw_gnd,gw_gnd,gw_gnd,gw_gnd,gw_gnd,gw_gnd,gw_gnd,gw_gnd,gw_gnd,din[17:9]}),
    .ADB({adb[10:0],gw_gnd,gw_gnd,gw_gnd})
);

defparam sdpx9b_inst_64.READ_MODE = 1'b0;
defparam sdpx9b_inst_64.BIT_WIDTH_0 = 9;
defparam sdpx9b_inst_64.BIT_WIDTH_1 = 9;
defparam sdpx9b_inst_64.BLK_SEL_0 = 3'b001;
defparam sdpx9b_inst_64.BLK_SEL_1 = 3'b001;
defparam sdpx9b_inst_64.RESET_MODE = "SYNC";

SDPX9B sdpx9b_inst_65 (
    .DO({sdpx9b_inst_65_dout_w[26:0],sdpx9b_inst_65_dout[17:9]}),
    .CLKA(clka),
    .CEA(cea),
    .CLKB(clkb),
    .CEB(ceb),
    .OCE(oce),
    .RESET(reset),
    .BLKSELA({gw_gnd,gw_gnd,lut_f_25}),
    .BLKSELB({gw_gnd,gw_gnd,lut_f_65}),
    .ADA({ada[10:0],gw_gnd,gw_gnd,gw_gnd}),
    .DI({gw_gnd,gw_gnd,gw_gnd,gw_gnd,gw_gnd,gw_gnd,gw_gnd,gw_gnd,gw_gnd,gw_gnd,gw_gnd,gw_gnd,gw_gnd,gw_gnd,gw_gnd,gw_gnd,gw_gnd,gw_gnd,gw_gnd,gw_gnd,gw_gnd,gw_gnd,gw_gnd,gw_gnd,gw_gnd,gw_gnd,gw_gnd,din[17:9]}),
    .ADB({adb[10:0],gw_gnd,gw_gnd,gw_gnd})
);

defparam sdpx9b_inst_65.READ_MODE = 1'b0;
defparam sdpx9b_inst_65.BIT_WIDTH_0 = 9;
defparam sdpx9b_inst_65.BIT_WIDTH_1 = 9;
defparam sdpx9b_inst_65.BLK_SEL_0 = 3'b001;
defparam sdpx9b_inst_65.BLK_SEL_1 = 3'b001;
defparam sdpx9b_inst_65.RESET_MODE = "SYNC";

SDPX9B sdpx9b_inst_66 (
    .DO({sdpx9b_inst_66_dout_w[26:0],sdpx9b_inst_66_dout[17:9]}),
    .CLKA(clka),
    .CEA(cea),
    .CLKB(clkb),
    .CEB(ceb),
    .OCE(oce),
    .RESET(reset),
    .BLKSELA({gw_gnd,gw_gnd,lut_f_26}),
    .BLKSELB({gw_gnd,gw_gnd,lut_f_66}),
    .ADA({ada[10:0],gw_gnd,gw_gnd,gw_gnd}),
    .DI({gw_gnd,gw_gnd,gw_gnd,gw_gnd,gw_gnd,gw_gnd,gw_gnd,gw_gnd,gw_gnd,gw_gnd,gw_gnd,gw_gnd,gw_gnd,gw_gnd,gw_gnd,gw_gnd,gw_gnd,gw_gnd,gw_gnd,gw_gnd,gw_gnd,gw_gnd,gw_gnd,gw_gnd,gw_gnd,gw_gnd,gw_gnd,din[17:9]}),
    .ADB({adb[10:0],gw_gnd,gw_gnd,gw_gnd})
);

defparam sdpx9b_inst_66.READ_MODE = 1'b0;
defparam sdpx9b_inst_66.BIT_WIDTH_0 = 9;
defparam sdpx9b_inst_66.BIT_WIDTH_1 = 9;
defparam sdpx9b_inst_66.BLK_SEL_0 = 3'b001;
defparam sdpx9b_inst_66.BLK_SEL_1 = 3'b001;
defparam sdpx9b_inst_66.RESET_MODE = "SYNC";

SDPX9B sdpx9b_inst_67 (
    .DO({sdpx9b_inst_67_dout_w[26:0],sdpx9b_inst_67_dout[17:9]}),
    .CLKA(clka),
    .CEA(cea),
    .CLKB(clkb),
    .CEB(ceb),
    .OCE(oce),
    .RESET(reset),
    .BLKSELA({gw_gnd,gw_gnd,lut_f_27}),
    .BLKSELB({gw_gnd,gw_gnd,lut_f_67}),
    .ADA({ada[10:0],gw_gnd,gw_gnd,gw_gnd}),
    .DI({gw_gnd,gw_gnd,gw_gnd,gw_gnd,gw_gnd,gw_gnd,gw_gnd,gw_gnd,gw_gnd,gw_gnd,gw_gnd,gw_gnd,gw_gnd,gw_gnd,gw_gnd,gw_gnd,gw_gnd,gw_gnd,gw_gnd,gw_gnd,gw_gnd,gw_gnd,gw_gnd,gw_gnd,gw_gnd,gw_gnd,gw_gnd,din[17:9]}),
    .ADB({adb[10:0],gw_gnd,gw_gnd,gw_gnd})
);

defparam sdpx9b_inst_67.READ_MODE = 1'b0;
defparam sdpx9b_inst_67.BIT_WIDTH_0 = 9;
defparam sdpx9b_inst_67.BIT_WIDTH_1 = 9;
defparam sdpx9b_inst_67.BLK_SEL_0 = 3'b001;
defparam sdpx9b_inst_67.BLK_SEL_1 = 3'b001;
defparam sdpx9b_inst_67.RESET_MODE = "SYNC";

SDPX9B sdpx9b_inst_68 (
    .DO({sdpx9b_inst_68_dout_w[26:0],sdpx9b_inst_68_dout[17:9]}),
    .CLKA(clka),
    .CEA(cea),
    .CLKB(clkb),
    .CEB(ceb),
    .OCE(oce),
    .RESET(reset),
    .BLKSELA({gw_gnd,gw_gnd,lut_f_28}),
    .BLKSELB({gw_gnd,gw_gnd,lut_f_68}),
    .ADA({ada[10:0],gw_gnd,gw_gnd,gw_gnd}),
    .DI({gw_gnd,gw_gnd,gw_gnd,gw_gnd,gw_gnd,gw_gnd,gw_gnd,gw_gnd,gw_gnd,gw_gnd,gw_gnd,gw_gnd,gw_gnd,gw_gnd,gw_gnd,gw_gnd,gw_gnd,gw_gnd,gw_gnd,gw_gnd,gw_gnd,gw_gnd,gw_gnd,gw_gnd,gw_gnd,gw_gnd,gw_gnd,din[17:9]}),
    .ADB({adb[10:0],gw_gnd,gw_gnd,gw_gnd})
);

defparam sdpx9b_inst_68.READ_MODE = 1'b0;
defparam sdpx9b_inst_68.BIT_WIDTH_0 = 9;
defparam sdpx9b_inst_68.BIT_WIDTH_1 = 9;
defparam sdpx9b_inst_68.BLK_SEL_0 = 3'b001;
defparam sdpx9b_inst_68.BLK_SEL_1 = 3'b001;
defparam sdpx9b_inst_68.RESET_MODE = "SYNC";

SDPX9B sdpx9b_inst_69 (
    .DO({sdpx9b_inst_69_dout_w[26:0],sdpx9b_inst_69_dout[17:9]}),
    .CLKA(clka),
    .CEA(cea),
    .CLKB(clkb),
    .CEB(ceb),
    .OCE(oce),
    .RESET(reset),
    .BLKSELA({gw_gnd,gw_gnd,lut_f_29}),
    .BLKSELB({gw_gnd,gw_gnd,lut_f_69}),
    .ADA({ada[10:0],gw_gnd,gw_gnd,gw_gnd}),
    .DI({gw_gnd,gw_gnd,gw_gnd,gw_gnd,gw_gnd,gw_gnd,gw_gnd,gw_gnd,gw_gnd,gw_gnd,gw_gnd,gw_gnd,gw_gnd,gw_gnd,gw_gnd,gw_gnd,gw_gnd,gw_gnd,gw_gnd,gw_gnd,gw_gnd,gw_gnd,gw_gnd,gw_gnd,gw_gnd,gw_gnd,gw_gnd,din[17:9]}),
    .ADB({adb[10:0],gw_gnd,gw_gnd,gw_gnd})
);

defparam sdpx9b_inst_69.READ_MODE = 1'b0;
defparam sdpx9b_inst_69.BIT_WIDTH_0 = 9;
defparam sdpx9b_inst_69.BIT_WIDTH_1 = 9;
defparam sdpx9b_inst_69.BLK_SEL_0 = 3'b001;
defparam sdpx9b_inst_69.BLK_SEL_1 = 3'b001;
defparam sdpx9b_inst_69.RESET_MODE = "SYNC";

SDPX9B sdpx9b_inst_70 (
    .DO({sdpx9b_inst_70_dout_w[26:0],sdpx9b_inst_70_dout[17:9]}),
    .CLKA(clka),
    .CEA(cea),
    .CLKB(clkb),
    .CEB(ceb),
    .OCE(oce),
    .RESET(reset),
    .BLKSELA({gw_gnd,gw_gnd,lut_f_30}),
    .BLKSELB({gw_gnd,gw_gnd,lut_f_70}),
    .ADA({ada[10:0],gw_gnd,gw_gnd,gw_gnd}),
    .DI({gw_gnd,gw_gnd,gw_gnd,gw_gnd,gw_gnd,gw_gnd,gw_gnd,gw_gnd,gw_gnd,gw_gnd,gw_gnd,gw_gnd,gw_gnd,gw_gnd,gw_gnd,gw_gnd,gw_gnd,gw_gnd,gw_gnd,gw_gnd,gw_gnd,gw_gnd,gw_gnd,gw_gnd,gw_gnd,gw_gnd,gw_gnd,din[17:9]}),
    .ADB({adb[10:0],gw_gnd,gw_gnd,gw_gnd})
);

defparam sdpx9b_inst_70.READ_MODE = 1'b0;
defparam sdpx9b_inst_70.BIT_WIDTH_0 = 9;
defparam sdpx9b_inst_70.BIT_WIDTH_1 = 9;
defparam sdpx9b_inst_70.BLK_SEL_0 = 3'b001;
defparam sdpx9b_inst_70.BLK_SEL_1 = 3'b001;
defparam sdpx9b_inst_70.RESET_MODE = "SYNC";

SDPX9B sdpx9b_inst_71 (
    .DO({sdpx9b_inst_71_dout_w[26:0],sdpx9b_inst_71_dout[17:9]}),
    .CLKA(clka),
    .CEA(cea),
    .CLKB(clkb),
    .CEB(ceb),
    .OCE(oce),
    .RESET(reset),
    .BLKSELA({gw_gnd,gw_gnd,lut_f_31}),
    .BLKSELB({gw_gnd,gw_gnd,lut_f_71}),
    .ADA({ada[10:0],gw_gnd,gw_gnd,gw_gnd}),
    .DI({gw_gnd,gw_gnd,gw_gnd,gw_gnd,gw_gnd,gw_gnd,gw_gnd,gw_gnd,gw_gnd,gw_gnd,gw_gnd,gw_gnd,gw_gnd,gw_gnd,gw_gnd,gw_gnd,gw_gnd,gw_gnd,gw_gnd,gw_gnd,gw_gnd,gw_gnd,gw_gnd,gw_gnd,gw_gnd,gw_gnd,gw_gnd,din[17:9]}),
    .ADB({adb[10:0],gw_gnd,gw_gnd,gw_gnd})
);

defparam sdpx9b_inst_71.READ_MODE = 1'b0;
defparam sdpx9b_inst_71.BIT_WIDTH_0 = 9;
defparam sdpx9b_inst_71.BIT_WIDTH_1 = 9;
defparam sdpx9b_inst_71.BLK_SEL_0 = 3'b001;
defparam sdpx9b_inst_71.BLK_SEL_1 = 3'b001;
defparam sdpx9b_inst_71.RESET_MODE = "SYNC";

SDPX9B sdpx9b_inst_72 (
    .DO({sdpx9b_inst_72_dout_w[26:0],sdpx9b_inst_72_dout[17:9]}),
    .CLKA(clka),
    .CEA(cea),
    .CLKB(clkb),
    .CEB(ceb),
    .OCE(oce),
    .RESET(reset),
    .BLKSELA({gw_gnd,gw_gnd,lut_f_32}),
    .BLKSELB({gw_gnd,gw_gnd,lut_f_72}),
    .ADA({ada[10:0],gw_gnd,gw_gnd,gw_gnd}),
    .DI({gw_gnd,gw_gnd,gw_gnd,gw_gnd,gw_gnd,gw_gnd,gw_gnd,gw_gnd,gw_gnd,gw_gnd,gw_gnd,gw_gnd,gw_gnd,gw_gnd,gw_gnd,gw_gnd,gw_gnd,gw_gnd,gw_gnd,gw_gnd,gw_gnd,gw_gnd,gw_gnd,gw_gnd,gw_gnd,gw_gnd,gw_gnd,din[17:9]}),
    .ADB({adb[10:0],gw_gnd,gw_gnd,gw_gnd})
);

defparam sdpx9b_inst_72.READ_MODE = 1'b0;
defparam sdpx9b_inst_72.BIT_WIDTH_0 = 9;
defparam sdpx9b_inst_72.BIT_WIDTH_1 = 9;
defparam sdpx9b_inst_72.BLK_SEL_0 = 3'b001;
defparam sdpx9b_inst_72.BLK_SEL_1 = 3'b001;
defparam sdpx9b_inst_72.RESET_MODE = "SYNC";

SDPX9B sdpx9b_inst_73 (
    .DO({sdpx9b_inst_73_dout_w[26:0],sdpx9b_inst_73_dout[17:9]}),
    .CLKA(clka),
    .CEA(cea),
    .CLKB(clkb),
    .CEB(ceb),
    .OCE(oce),
    .RESET(reset),
    .BLKSELA({gw_gnd,gw_gnd,lut_f_33}),
    .BLKSELB({gw_gnd,gw_gnd,lut_f_73}),
    .ADA({ada[10:0],gw_gnd,gw_gnd,gw_gnd}),
    .DI({gw_gnd,gw_gnd,gw_gnd,gw_gnd,gw_gnd,gw_gnd,gw_gnd,gw_gnd,gw_gnd,gw_gnd,gw_gnd,gw_gnd,gw_gnd,gw_gnd,gw_gnd,gw_gnd,gw_gnd,gw_gnd,gw_gnd,gw_gnd,gw_gnd,gw_gnd,gw_gnd,gw_gnd,gw_gnd,gw_gnd,gw_gnd,din[17:9]}),
    .ADB({adb[10:0],gw_gnd,gw_gnd,gw_gnd})
);

defparam sdpx9b_inst_73.READ_MODE = 1'b0;
defparam sdpx9b_inst_73.BIT_WIDTH_0 = 9;
defparam sdpx9b_inst_73.BIT_WIDTH_1 = 9;
defparam sdpx9b_inst_73.BLK_SEL_0 = 3'b001;
defparam sdpx9b_inst_73.BLK_SEL_1 = 3'b001;
defparam sdpx9b_inst_73.RESET_MODE = "SYNC";

SDPX9B sdpx9b_inst_74 (
    .DO({sdpx9b_inst_74_dout_w[26:0],sdpx9b_inst_74_dout[17:9]}),
    .CLKA(clka),
    .CEA(cea),
    .CLKB(clkb),
    .CEB(ceb),
    .OCE(oce),
    .RESET(reset),
    .BLKSELA({gw_gnd,gw_gnd,lut_f_34}),
    .BLKSELB({gw_gnd,gw_gnd,lut_f_74}),
    .ADA({ada[10:0],gw_gnd,gw_gnd,gw_gnd}),
    .DI({gw_gnd,gw_gnd,gw_gnd,gw_gnd,gw_gnd,gw_gnd,gw_gnd,gw_gnd,gw_gnd,gw_gnd,gw_gnd,gw_gnd,gw_gnd,gw_gnd,gw_gnd,gw_gnd,gw_gnd,gw_gnd,gw_gnd,gw_gnd,gw_gnd,gw_gnd,gw_gnd,gw_gnd,gw_gnd,gw_gnd,gw_gnd,din[17:9]}),
    .ADB({adb[10:0],gw_gnd,gw_gnd,gw_gnd})
);

defparam sdpx9b_inst_74.READ_MODE = 1'b0;
defparam sdpx9b_inst_74.BIT_WIDTH_0 = 9;
defparam sdpx9b_inst_74.BIT_WIDTH_1 = 9;
defparam sdpx9b_inst_74.BLK_SEL_0 = 3'b001;
defparam sdpx9b_inst_74.BLK_SEL_1 = 3'b001;
defparam sdpx9b_inst_74.RESET_MODE = "SYNC";

SDPX9B sdpx9b_inst_75 (
    .DO({sdpx9b_inst_75_dout_w[26:0],sdpx9b_inst_75_dout[17:9]}),
    .CLKA(clka),
    .CEA(cea),
    .CLKB(clkb),
    .CEB(ceb),
    .OCE(oce),
    .RESET(reset),
    .BLKSELA({gw_gnd,gw_gnd,lut_f_35}),
    .BLKSELB({gw_gnd,gw_gnd,lut_f_75}),
    .ADA({ada[10:0],gw_gnd,gw_gnd,gw_gnd}),
    .DI({gw_gnd,gw_gnd,gw_gnd,gw_gnd,gw_gnd,gw_gnd,gw_gnd,gw_gnd,gw_gnd,gw_gnd,gw_gnd,gw_gnd,gw_gnd,gw_gnd,gw_gnd,gw_gnd,gw_gnd,gw_gnd,gw_gnd,gw_gnd,gw_gnd,gw_gnd,gw_gnd,gw_gnd,gw_gnd,gw_gnd,gw_gnd,din[17:9]}),
    .ADB({adb[10:0],gw_gnd,gw_gnd,gw_gnd})
);

defparam sdpx9b_inst_75.READ_MODE = 1'b0;
defparam sdpx9b_inst_75.BIT_WIDTH_0 = 9;
defparam sdpx9b_inst_75.BIT_WIDTH_1 = 9;
defparam sdpx9b_inst_75.BLK_SEL_0 = 3'b001;
defparam sdpx9b_inst_75.BLK_SEL_1 = 3'b001;
defparam sdpx9b_inst_75.RESET_MODE = "SYNC";

SDPX9B sdpx9b_inst_76 (
    .DO({sdpx9b_inst_76_dout_w[26:0],sdpx9b_inst_76_dout[17:9]}),
    .CLKA(clka),
    .CEA(cea),
    .CLKB(clkb),
    .CEB(ceb),
    .OCE(oce),
    .RESET(reset),
    .BLKSELA({gw_gnd,gw_gnd,lut_f_36}),
    .BLKSELB({gw_gnd,gw_gnd,lut_f_76}),
    .ADA({ada[10:0],gw_gnd,gw_gnd,gw_gnd}),
    .DI({gw_gnd,gw_gnd,gw_gnd,gw_gnd,gw_gnd,gw_gnd,gw_gnd,gw_gnd,gw_gnd,gw_gnd,gw_gnd,gw_gnd,gw_gnd,gw_gnd,gw_gnd,gw_gnd,gw_gnd,gw_gnd,gw_gnd,gw_gnd,gw_gnd,gw_gnd,gw_gnd,gw_gnd,gw_gnd,gw_gnd,gw_gnd,din[17:9]}),
    .ADB({adb[10:0],gw_gnd,gw_gnd,gw_gnd})
);

defparam sdpx9b_inst_76.READ_MODE = 1'b0;
defparam sdpx9b_inst_76.BIT_WIDTH_0 = 9;
defparam sdpx9b_inst_76.BIT_WIDTH_1 = 9;
defparam sdpx9b_inst_76.BLK_SEL_0 = 3'b001;
defparam sdpx9b_inst_76.BLK_SEL_1 = 3'b001;
defparam sdpx9b_inst_76.RESET_MODE = "SYNC";

SDPX9B sdpx9b_inst_77 (
    .DO({sdpx9b_inst_77_dout_w[26:0],sdpx9b_inst_77_dout[17:9]}),
    .CLKA(clka),
    .CEA(cea),
    .CLKB(clkb),
    .CEB(ceb),
    .OCE(oce),
    .RESET(reset),
    .BLKSELA({gw_gnd,gw_gnd,lut_f_37}),
    .BLKSELB({gw_gnd,gw_gnd,lut_f_77}),
    .ADA({ada[10:0],gw_gnd,gw_gnd,gw_gnd}),
    .DI({gw_gnd,gw_gnd,gw_gnd,gw_gnd,gw_gnd,gw_gnd,gw_gnd,gw_gnd,gw_gnd,gw_gnd,gw_gnd,gw_gnd,gw_gnd,gw_gnd,gw_gnd,gw_gnd,gw_gnd,gw_gnd,gw_gnd,gw_gnd,gw_gnd,gw_gnd,gw_gnd,gw_gnd,gw_gnd,gw_gnd,gw_gnd,din[17:9]}),
    .ADB({adb[10:0],gw_gnd,gw_gnd,gw_gnd})
);

defparam sdpx9b_inst_77.READ_MODE = 1'b0;
defparam sdpx9b_inst_77.BIT_WIDTH_0 = 9;
defparam sdpx9b_inst_77.BIT_WIDTH_1 = 9;
defparam sdpx9b_inst_77.BLK_SEL_0 = 3'b001;
defparam sdpx9b_inst_77.BLK_SEL_1 = 3'b001;
defparam sdpx9b_inst_77.RESET_MODE = "SYNC";

SDPX9B sdpx9b_inst_78 (
    .DO({sdpx9b_inst_78_dout_w[26:0],sdpx9b_inst_78_dout[17:9]}),
    .CLKA(clka),
    .CEA(cea),
    .CLKB(clkb),
    .CEB(ceb),
    .OCE(oce),
    .RESET(reset),
    .BLKSELA({gw_gnd,gw_gnd,lut_f_38}),
    .BLKSELB({gw_gnd,gw_gnd,lut_f_78}),
    .ADA({ada[10:0],gw_gnd,gw_gnd,gw_gnd}),
    .DI({gw_gnd,gw_gnd,gw_gnd,gw_gnd,gw_gnd,gw_gnd,gw_gnd,gw_gnd,gw_gnd,gw_gnd,gw_gnd,gw_gnd,gw_gnd,gw_gnd,gw_gnd,gw_gnd,gw_gnd,gw_gnd,gw_gnd,gw_gnd,gw_gnd,gw_gnd,gw_gnd,gw_gnd,gw_gnd,gw_gnd,gw_gnd,din[17:9]}),
    .ADB({adb[10:0],gw_gnd,gw_gnd,gw_gnd})
);

defparam sdpx9b_inst_78.READ_MODE = 1'b0;
defparam sdpx9b_inst_78.BIT_WIDTH_0 = 9;
defparam sdpx9b_inst_78.BIT_WIDTH_1 = 9;
defparam sdpx9b_inst_78.BLK_SEL_0 = 3'b001;
defparam sdpx9b_inst_78.BLK_SEL_1 = 3'b001;
defparam sdpx9b_inst_78.RESET_MODE = "SYNC";

SDPX9B sdpx9b_inst_79 (
    .DO({sdpx9b_inst_79_dout_w[26:0],sdpx9b_inst_79_dout[17:9]}),
    .CLKA(clka),
    .CEA(cea),
    .CLKB(clkb),
    .CEB(ceb),
    .OCE(oce),
    .RESET(reset),
    .BLKSELA({gw_gnd,gw_gnd,lut_f_39}),
    .BLKSELB({gw_gnd,gw_gnd,lut_f_79}),
    .ADA({ada[10:0],gw_gnd,gw_gnd,gw_gnd}),
    .DI({gw_gnd,gw_gnd,gw_gnd,gw_gnd,gw_gnd,gw_gnd,gw_gnd,gw_gnd,gw_gnd,gw_gnd,gw_gnd,gw_gnd,gw_gnd,gw_gnd,gw_gnd,gw_gnd,gw_gnd,gw_gnd,gw_gnd,gw_gnd,gw_gnd,gw_gnd,gw_gnd,gw_gnd,gw_gnd,gw_gnd,gw_gnd,din[17:9]}),
    .ADB({adb[10:0],gw_gnd,gw_gnd,gw_gnd})
);

defparam sdpx9b_inst_79.READ_MODE = 1'b0;
defparam sdpx9b_inst_79.BIT_WIDTH_0 = 9;
defparam sdpx9b_inst_79.BIT_WIDTH_1 = 9;
defparam sdpx9b_inst_79.BLK_SEL_0 = 3'b001;
defparam sdpx9b_inst_79.BLK_SEL_1 = 3'b001;
defparam sdpx9b_inst_79.RESET_MODE = "SYNC";

SDPB sdpb_inst_80 (
    .DO({sdpb_inst_80_dout_w[30:0],sdpb_inst_80_dout[18]}),
    .CLKA(clka),
    .CEA(cea),
    .CLKB(clkb),
    .CEB(ceb),
    .OCE(oce),
    .RESET(reset),
    .BLKSELA({ada[16],ada[15],ada[14]}),
    .BLKSELB({adb[16],adb[15],adb[14]}),
    .ADA(ada[13:0]),
    .DI({gw_gnd,gw_gnd,gw_gnd,gw_gnd,gw_gnd,gw_gnd,gw_gnd,gw_gnd,gw_gnd,gw_gnd,gw_gnd,gw_gnd,gw_gnd,gw_gnd,gw_gnd,gw_gnd,gw_gnd,gw_gnd,gw_gnd,gw_gnd,gw_gnd,gw_gnd,gw_gnd,gw_gnd,gw_gnd,gw_gnd,gw_gnd,gw_gnd,gw_gnd,gw_gnd,gw_gnd,din[18]}),
    .ADB(adb[13:0])
);

defparam sdpb_inst_80.READ_MODE = 1'b0;
defparam sdpb_inst_80.BIT_WIDTH_0 = 1;
defparam sdpb_inst_80.BIT_WIDTH_1 = 1;
defparam sdpb_inst_80.BLK_SEL_0 = 3'b000;
defparam sdpb_inst_80.BLK_SEL_1 = 3'b000;
defparam sdpb_inst_80.RESET_MODE = "SYNC";

SDPB sdpb_inst_81 (
    .DO({sdpb_inst_81_dout_w[30:0],sdpb_inst_81_dout[18]}),
    .CLKA(clka),
    .CEA(cea),
    .CLKB(clkb),
    .CEB(ceb),
    .OCE(oce),
    .RESET(reset),
    .BLKSELA({ada[16],ada[15],ada[14]}),
    .BLKSELB({adb[16],adb[15],adb[14]}),
    .ADA(ada[13:0]),
    .DI({gw_gnd,gw_gnd,gw_gnd,gw_gnd,gw_gnd,gw_gnd,gw_gnd,gw_gnd,gw_gnd,gw_gnd,gw_gnd,gw_gnd,gw_gnd,gw_gnd,gw_gnd,gw_gnd,gw_gnd,gw_gnd,gw_gnd,gw_gnd,gw_gnd,gw_gnd,gw_gnd,gw_gnd,gw_gnd,gw_gnd,gw_gnd,gw_gnd,gw_gnd,gw_gnd,gw_gnd,din[18]}),
    .ADB(adb[13:0])
);

defparam sdpb_inst_81.READ_MODE = 1'b0;
defparam sdpb_inst_81.BIT_WIDTH_0 = 1;
defparam sdpb_inst_81.BIT_WIDTH_1 = 1;
defparam sdpb_inst_81.BLK_SEL_0 = 3'b001;
defparam sdpb_inst_81.BLK_SEL_1 = 3'b001;
defparam sdpb_inst_81.RESET_MODE = "SYNC";

SDPB sdpb_inst_82 (
    .DO({sdpb_inst_82_dout_w[30:0],sdpb_inst_82_dout[18]}),
    .CLKA(clka),
    .CEA(cea),
    .CLKB(clkb),
    .CEB(ceb),
    .OCE(oce),
    .RESET(reset),
    .BLKSELA({ada[16],ada[15],ada[14]}),
    .BLKSELB({adb[16],adb[15],adb[14]}),
    .ADA(ada[13:0]),
    .DI({gw_gnd,gw_gnd,gw_gnd,gw_gnd,gw_gnd,gw_gnd,gw_gnd,gw_gnd,gw_gnd,gw_gnd,gw_gnd,gw_gnd,gw_gnd,gw_gnd,gw_gnd,gw_gnd,gw_gnd,gw_gnd,gw_gnd,gw_gnd,gw_gnd,gw_gnd,gw_gnd,gw_gnd,gw_gnd,gw_gnd,gw_gnd,gw_gnd,gw_gnd,gw_gnd,gw_gnd,din[18]}),
    .ADB(adb[13:0])
);

defparam sdpb_inst_82.READ_MODE = 1'b0;
defparam sdpb_inst_82.BIT_WIDTH_0 = 1;
defparam sdpb_inst_82.BIT_WIDTH_1 = 1;
defparam sdpb_inst_82.BLK_SEL_0 = 3'b010;
defparam sdpb_inst_82.BLK_SEL_1 = 3'b010;
defparam sdpb_inst_82.RESET_MODE = "SYNC";

SDPB sdpb_inst_83 (
    .DO({sdpb_inst_83_dout_w[30:0],sdpb_inst_83_dout[18]}),
    .CLKA(clka),
    .CEA(cea),
    .CLKB(clkb),
    .CEB(ceb),
    .OCE(oce),
    .RESET(reset),
    .BLKSELA({ada[16],ada[15],ada[14]}),
    .BLKSELB({adb[16],adb[15],adb[14]}),
    .ADA(ada[13:0]),
    .DI({gw_gnd,gw_gnd,gw_gnd,gw_gnd,gw_gnd,gw_gnd,gw_gnd,gw_gnd,gw_gnd,gw_gnd,gw_gnd,gw_gnd,gw_gnd,gw_gnd,gw_gnd,gw_gnd,gw_gnd,gw_gnd,gw_gnd,gw_gnd,gw_gnd,gw_gnd,gw_gnd,gw_gnd,gw_gnd,gw_gnd,gw_gnd,gw_gnd,gw_gnd,gw_gnd,gw_gnd,din[18]}),
    .ADB(adb[13:0])
);

defparam sdpb_inst_83.READ_MODE = 1'b0;
defparam sdpb_inst_83.BIT_WIDTH_0 = 1;
defparam sdpb_inst_83.BIT_WIDTH_1 = 1;
defparam sdpb_inst_83.BLK_SEL_0 = 3'b011;
defparam sdpb_inst_83.BLK_SEL_1 = 3'b011;
defparam sdpb_inst_83.RESET_MODE = "SYNC";

SDPB sdpb_inst_84 (
    .DO({sdpb_inst_84_dout_w[30:0],sdpb_inst_84_dout[18]}),
    .CLKA(clka),
    .CEA(cea),
    .CLKB(clkb),
    .CEB(ceb),
    .OCE(oce),
    .RESET(reset),
    .BLKSELA({ada[16],ada[15],ada[14]}),
    .BLKSELB({adb[16],adb[15],adb[14]}),
    .ADA(ada[13:0]),
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
    .ADA(ada[13:0]),
    .DI({gw_gnd,gw_gnd,gw_gnd,gw_gnd,gw_gnd,gw_gnd,gw_gnd,gw_gnd,gw_gnd,gw_gnd,gw_gnd,gw_gnd,gw_gnd,gw_gnd,gw_gnd,gw_gnd,gw_gnd,gw_gnd,gw_gnd,gw_gnd,gw_gnd,gw_gnd,gw_gnd,gw_gnd,gw_gnd,gw_gnd,gw_gnd,gw_gnd,gw_gnd,gw_gnd,gw_gnd,din[22]}),
    .ADB(adb[13:0])
);

defparam sdpb_inst_103.READ_MODE = 1'b0;
defparam sdpb_inst_103.BIT_WIDTH_0 = 1;
defparam sdpb_inst_103.BIT_WIDTH_1 = 1;
defparam sdpb_inst_103.BLK_SEL_0 = 3'b011;
defparam sdpb_inst_103.BLK_SEL_1 = 3'b011;
defparam sdpb_inst_103.RESET_MODE = "SYNC";
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
