MaybeThready/MT-EMI/src/rom_wavetables/rom_wavetables.v

//Copyright (C)2014-2026 Gowin Semiconductor Corporation.
//All rights reserved.
//File Title: IP file
//Tool Version: V1.9.12.04 (64-bit)
//IP Version: 1.0
//Part Number: GW5AST-LV138FPG676AC1/I0
//Device: GW5AST-138
//Device Version: C
//Created Time: Fri Oct 23 20:37:56 2026

module rom_wavetables (dout, clk, oce, ce, reset, ad);

output [15:0] dout;
input clk;
input oce;
input ce;
input reset;
input [13:0] ad;

wire lut_f_0;
wire lut_f_1;
wire lut_f_2;
wire lut_f_3;
wire lut_f_4;
wire lut_f_5;
wire lut_f_6;
wire lut_f_7;
wire [26:0] promx9_inst_0_dout_w;
wire [8:0] promx9_inst_0_dout;
wire [26:0] promx9_inst_1_dout_w;
wire [8:0] promx9_inst_1_dout;
wire [26:0] promx9_inst_2_dout_w;
wire [8:0] promx9_inst_2_dout;
wire [26:0] promx9_inst_3_dout_w;
wire [8:0] promx9_inst_3_dout;
wire [26:0] promx9_inst_4_dout_w;
wire [8:0] promx9_inst_4_dout;
wire [26:0] promx9_inst_5_dout_w;
wire [8:0] promx9_inst_5_dout;
wire [26:0] promx9_inst_6_dout_w;
wire [8:0] promx9_inst_6_dout;
wire [26:0] promx9_inst_7_dout_w;
wire [8:0] promx9_inst_7_dout;
wire [30:0] prom_inst_8_dout_w;
wire [30:0] prom_inst_9_dout_w;
wire [30:0] prom_inst_10_dout_w;
wire [30:0] prom_inst_11_dout_w;
wire [30:0] prom_inst_12_dout_w;
wire [30:0] prom_inst_13_dout_w;
wire [30:0] prom_inst_14_dout_w;
wire dff_q_0;
wire dff_q_1;
wire dff_q_2;
wire mux_o_0;
wire mux_o_1;
wire mux_o_2;
wire mux_o_3;
wire mux_o_4;
wire mux_o_5;
wire mux_o_7;
wire mux_o_8;
wire mux_o_9;
wire mux_o_10;
wire mux_o_11;
wire mux_o_12;
wire mux_o_14;
wire mux_o_15;
wire mux_o_16;
wire mux_o_17;
wire mux_o_18;
wire mux_o_19;
wire mux_o_21;
wire mux_o_22;
wire mux_o_23;
wire mux_o_24;
wire mux_o_25;
wire mux_o_26;
wire mux_o_28;
wire mux_o_29;
wire mux_o_30;
wire mux_o_31;
wire mux_o_32;
wire mux_o_33;
wire mux_o_35;
wire mux_o_36;
wire mux_o_37;
wire mux_o_38;
wire mux_o_39;
wire mux_o_40;
wire mux_o_42;
wire mux_o_43;
wire mux_o_44;
wire mux_o_45;
wire mux_o_46;
wire mux_o_47;
wire mux_o_49;
wire mux_o_50;
wire mux_o_51;
wire mux_o_52;
wire mux_o_53;
wire mux_o_54;
wire mux_o_56;
wire mux_o_57;
wire mux_o_58;
wire mux_o_59;
wire mux_o_60;
wire mux_o_61;
wire gw_gnd;

assign gw_gnd = 1'b0;

LUT4 lut_inst_0 (
  .F(lut_f_0),
  .I0(ce),
  .I1(ad[11]),
  .I2(ad[12]),
  .I3(ad[13])
);
defparam lut_inst_0.INIT = 16'h0002;
LUT4 lut_inst_1 (
  .F(lut_f_1),
  .I0(ce),
  .I1(ad[11]),
  .I2(ad[12]),
  .I3(ad[13])
);
defparam lut_inst_1.INIT = 16'h0008;
LUT4 lut_inst_2 (
  .F(lut_f_2),
  .I0(ce),
  .I1(ad[11]),
  .I2(ad[12]),
  .I3(ad[13])
);
defparam lut_inst_2.INIT = 16'h0020;
LUT4 lut_inst_3 (
  .F(lut_f_3),
  .I0(ce),
  .I1(ad[11]),
  .I2(ad[12]),
  .I3(ad[13])
);
defparam lut_inst_3.INIT = 16'h0080;
LUT4 lut_inst_4 (
  .F(lut_f_4),
  .I0(ce),
  .I1(ad[11]),
  .I2(ad[12]),
  .I3(ad[13])
);
defparam lut_inst_4.INIT = 16'h0200;
LUT4 lut_inst_5 (
  .F(lut_f_5),
  .I0(ce),
  .I1(ad[11]),
  .I2(ad[12]),
  .I3(ad[13])
);
defparam lut_inst_5.INIT = 16'h0800;
LUT4 lut_inst_6 (
  .F(lut_f_6),
  .I0(ce),
  .I1(ad[11]),
  .I2(ad[12]),
  .I3(ad[13])
);
defparam lut_inst_6.INIT = 16'h2000;
LUT4 lut_inst_7 (
  .F(lut_f_7),
  .I0(ce),
  .I1(ad[11]),
  .I2(ad[12]),
  .I3(ad[13])
);
defparam lut_inst_7.INIT = 16'h8000;
pROMX9 promx9_inst_0 (
    .DO({promx9_inst_0_dout_w[26:0],promx9_inst_0_dout[8:0]}),
    .CLK(clk),
    .OCE(oce),
    .CE(lut_f_0),
    .RESET(reset),
    .AD({ad[10:0],gw_gnd,gw_gnd,gw_gnd})
);

defparam promx9_inst_0.READ_MODE = 1'b0;
defparam promx9_inst_0.BIT_WIDTH = 9;
defparam promx9_inst_0.RESET_MODE = "ASYNC";
defparam promx9_inst_0.INIT_RAM_00 = 288'h0B78F637FA6C6DD0B6421483FEDDDE26AD24793011A5B14FDF8992B04B9F6C94B9946400;
defparam promx9_inst_0.INIT_RAM_01 = 288'h2D0A3EDC4C95825AFB64A5CCA3300F3F3B6B9C419A8A2380F819D9D3DD687116F2B0F448;
defparam promx9_inst_0.INIT_RAM_02 = 288'h4B1946601E7E7AD93A8435948732083FBBABBCD1E2AE4592009C1CF56E30D54913C17C8C;
defparam promx9_inst_0.INIT_RAM_03 = 288'h63A58CA33017473F6E9E42DB4A83B91429E2D8DFE9B1C752E50E55127CB838FAECADF4C8;
defparam promx9_inst_0.INIT_RAM_04 = 288'h74AE11057137D78993B14C602D04F9B87A0CED6A6F1478B395688328883DFBEC6D6E54F9;
defparam promx9_inst_0.INIT_RAM_05 = 288'h7C32130671B81FAFA7BB51A2CE55AA10A824F9F0F256298C05A09F378F81DDDD65EE971A;
defparam promx9_inst_0.INIT_RAM_06 = 288'h7830522621900FA7A4BA5162AE55B218AC27FBF1F2F689C421B0A83C12031E8DC622B128;
defparam promx9_inst_0.INIT_RAM_07 = 288'h66A7CE04209F976D87ACCA9F6CC4F1BC8011F16CF0955933DD9099350EC19DCD6DFA9F1F;
defparam promx9_inst_0.INIT_RAM_08 = 288'h4697C6404EBEA6F74E903C98897348EC1BDFD8E0EAB277CB2D3A6E2004BC9B5C3D6654FC;
defparam promx9_inst_0.INIT_RAM_09 = 288'h157FBA5A5BCD3240F363268DA4009F9F758DB04CE0CD9561FCA425FBF2B3B70A1455D0BA;
defparam promx9_inst_0.INIT_RAM_0A = 288'hD1DE29B217B32D3E7424077E3C6CD5BE87177630128681E043C9B8C658269086E2BD0657;
defparam promx9_inst_0.INIT_RAM_0B = 288'h79B253E7525887EFCDD1DE69F247D3414A7B2809BF7D1D35EEA3267DB414A7A27893F3CE;
defparam promx9_inst_0.INIT_RAM_0C = 288'h0BFBF8F9EBAD3648FB69AA902581781BBBB4C5D8A730F732F5266A2005FDBC4CD5C28F1D;
defparam promx9_inst_0.INIT_RAM_0D = 288'h86B997E983892847FBEA6B70B5E9BC3DD0C04C1C49221FCF475381ACCC612E15CA44D040;
defparam promx9_inst_0.INIT_RAM_0E = 288'hE86AF0D609DC55E0CA521FCB23306F9F839BBAD3E53036E2D9206921873EBCFD4606B734;
defparam promx9_inst_0.INIT_RAM_0F = 288'h2F8EC31F4E86B31164A0471F0D458230CE430F7EBABB1C659E871E7CB515E8A3290037F6;
defparam promx9_inst_0.INIT_RAM_10 = 288'h5B250E45017033D5C8D2E0EC33E8E3E5AEB4489BC98290378F819DBD55E691076B254C82;
defparam promx9_inst_0.INIT_RAM_11 = 288'h692C92472290C823F1E8EC3216FA74BA1AEC65AA91268238980BE4E1687015E9E46DF2D7;
defparam promx9_inst_0.INIT_RAM_12 = 288'h5924CEA571C86FF9DEE06870564A2C9A0EE9652AD166C268B81FEFE86C32371A8CCA24F2;
defparam promx9_inst_0.INIT_RAM_13 = 288'h290D835FDF0F17538CB854E6F1A7EB8188A7451B4A0320AFE3B5BDD060AC94794C2DDAD0;
defparam promx9_inst_0.INIT_RAM_14 = 288'hD865AF962A44BA28F96FB11548F3A9687E2404FBBA7B8CEE0ACD4B98451F0DD60A95126E;
defparam promx9_inst_0.INIT_RAM_15 = 288'h65ACD36833594C762305FCBB5C2D4E42F15FA34B628FB7132560973E99094310BFFBC9CA;
defparam promx9_inst_0.INIT_RAM_16 = 288'hD062EEB5FA54D23D08793718AAF4CA08D8551F8A023FAF1F336B9EC3DC2B14195449F4E3;
defparam promx9_inst_0.INIT_RAM_17 = 288'h1706C11F4F0F3773A6C95FAD556A14B63305783718EB34F224EA60258D8420BFB78797B6;
defparam promx9_inst_0.INIT_RAM_18 = 288'h3A18CA2401787819FBF4F638DB4D1642FD6CAD5226D2388BF9D8D963AD1428E3D9A0AA42;
defparam promx9_inst_0.INIT_RAM_19 = 288'h37180A242198902A06FBF9FB1C9DCEAB358ABD5AAB74A9D4AA350A7CBA5B0C85BA992A85;
defparam promx9_inst_0.INIT_RAM_1A = 288'h0F0440BF9F677FA7C6DCEB33F92C2DE2D55DA850A69278CC2DFAEF70B4D8AB754269187D;
defparam promx9_inst_0.INIT_RAM_1B = 288'hC0DDEDB63AC53A893A97C96350F82BE9DEE46CB3984B7562812A893F1C8CC5A271086C2A;
defparam promx9_inst_0.INIT_RAM_1C = 288'h4B2390E7F3C1C0D0602C140903F1B8BC4C1E0A83007FBF97A7C1D6E6F1375B1D3E7B298A;
defparam promx9_inst_0.INIT_RAM_1D = 288'hAED62A74EA4D0E7D3899CB64F228E45A210A81BF5EEF07538DBAD667B2182BA59AB14A9D;
defparam promx9_inst_0.INIT_RAM_1E = 288'hEB74FA3CEE5F238BC2DFEF373B5D96BB57A7D1E833998CA6431787C1DFAF575B8DB2CF62;
defparam promx9_inst_0.INIT_RAM_1F = 288'hFFFFFFFFFFFFFFFDFEFEFF3F7FAFCFE3EFF6FAFD3E5F1F7FB7D9EAF479BC9E2F0777B7D9;
defparam promx9_inst_0.INIT_RAM_20 = 288'hEDF77C1E2F279BD1EAF67B7DFF1F97D3EBF6FBFE3F3FAFDFF3FBFEFF7FFFFFFFFFFFFFFF;
defparam promx9_inst_0.INIT_RAM_21 = 288'hB3DB2E375BD5FB0787C5E432998CE68347A7D5EBB65B5DCEF37FC2E2F2397CEE8F4FADD9;
defparam promx9_inst_0.INIT_RAM_22 = 288'h52AB166BA60B219ED66EB8DD4F07BBF6070A8845A392293CB667389F50E934EA9D62BB62;
defparam promx9_inst_0.INIT_RAM_23 = 288'hCA67B4FB1DD7139BD6F07A7E5FB018302A1E130BC6E3F24140B060341C0F07F43A392C9D;
defparam promx9_inst_0.INIT_RAM_24 = 288'h1B1089C5A331C8FC894AA8158B761339B2E477BEA0B0F8D4965F3AA253AB163B6DDF038A;
defparam promx9_inst_0.INIT_RAM_25 = 288'h4626950B762B4DC2EF7EC2E33279A50AA15DB55E30B92CFEB373C6E9F7FD9F9028443C2A;
defparam promx9_inst_0.INIT_RAM_26 = 288'h4AA996EC86C3A5F30A8D4AA754AADDAAF58ACD6AB73C9EC79FEE060A890664228980DC7D;
defparam promx9_inst_0.INIT_RAM_27 = 288'h2A9A0F68E50AD18ED9763FA23239B522B56CBF64345B4E3763D3FB060785E402898CE885;
defparam promx9_inst_0.INIT_RAM_28 = 288'hE5F87EC0B108D896603AA253CB363B71E1058CCB68556B55FB25A6DCF37C3F40406C5C42;
defparam promx9_inst_0.INIT_RAM_29 = 288'h7D44A5541AC5C30F9EDAF33C7FA088A07E553620932AF62B71E5088F4D2955FBAE2F41B6;
defparam promx9_inst_0.INIT_RAM_2A = 288'hF27F82E3125190FA9758325C4FB8A4B68D5FBC64353C2ED7C816231D94CD6834DACD96E3;
defparam promx9_inst_0.INIT_RAM_2B = 288'h44A9582DD7C452614BB360B3BB8E9FB812241F968EA8F55311BEF98A4BA9162BE65B61CA;
defparam promx9_inst_0.INIT_RAM_2C = 288'h76C2E5347B260B41BDED7E02A32281B514A762381FB1A9BD4EE18CD4F17C3FD0D0D8A46E;
defparam promx9_inst_0.INIT_RAM_2D = 288'h894CAA371C8EC3A1EF078B89A6C45AAD94E983C9A8B64C168781DEFE06C72573AA4D64D0;
defparam promx9_inst_0.INIT_RAM_2E = 288'h7CC6E795EC068785E4028988E6844AA996EC86CBA9D6FC86C3A3F1088C8A472492C9A4F2;
defparam promx9_inst_0.INIT_RAM_2F = 288'h53325DB109A55EF59DE078C0C29261BD22B46BBE6393EB0E0F4BC8F50305C50392516CD7;
defparam promx9_inst_0.INIT_RAM_30 = 288'h0D900CA8A57B51F31EA1D9F19B1EAFE83C4333A3160D47C4728164C46B3A1F40C0ECBE82;
defparam promx9_inst_0.INIT_RAM_31 = 288'hADE0751CFFA8708669482D9B90394D3EEB9BE0F9C1A332C9FD48CA784567760C36AFA1F6;
defparam promx9_inst_0.INIT_RAM_32 = 288'h3424572E184CC6B381D4F47F221249C530C07443E6F5EC2EB7A9FB11928E2985FB9A1B34;
defparam promx9_inst_0.INIT_RAM_33 = 288'hA3DC335C4F685C806A49AF5CD0F9CD8B17B4EE8185E5840AA9A6FB92536EB9EE3FBC2E40;
defparam promx9_inst_0.INIT_RAM_34 = 288'hFC8909E7A52B41F726A8DEF4DD1FD898A07B52B41F524A7DE747CDFB88496754FB25E71D;
defparam promx9_inst_0.INIT_RAM_35 = 288'h41ABDB9089A58319B8F204078684A301D917A1DBF35C6F887490744FB2DED21A6DE347CE;
defparam promx9_inst_0.INIT_RAM_36 = 288'h744568570CEF2BEE25291FD58D9834CEC18DDD79C264036A698CF390532F3A5E97F85457;
defparam promx9_inst_0.INIT_RAM_37 = 288'h955670FB5F2048806E4EB2DF327AAE0F63DF068ECD297623CA414EBDEA7AE041917D1ABA;
defparam promx9_inst_0.INIT_RAM_38 = 288'hA7DFB5BDC060ECD499643DE4D55C26CFC411201BD3CCC7DCAAB387DB79426423827D9AFC;
defparam promx9_inst_0.INIT_RAM_39 = 288'hAC62371E80C120F0A86C4227168CBF1FEE272B2196CE58AD16E9A4E980C646248B05E11F;
defparam promx9_inst_0.INIT_RAM_3A = 288'hA5DEF59DD070F8DE9F684066362C970FE6242A2116AE58B51AEDA7EB81C6E674C321F128;
defparam promx9_inst_0.INIT_RAM_3B = 288'h9556F1BBEF7880A2835A3962D47BC6A7B40C1E9B93ED080CC6C593E27D44C57442E1D31A;
defparam promx9_inst_0.INIT_RAM_3C = 288'h7D4AEBB8FE0FC8485543AE5D51CA6DFF63E20A114EEA86D42E796ECFF44043332A598EF9;
defparam promx9_inst_0.INIT_RAM_3D = 288'h5F3C24554C36E3D41C2720164E48AD1EF3ABEE83C82735235A113AB667B9E01199952CC8;
defparam promx9_inst_0.INIT_RAM_3E = 288'h3D2B1BD11A1DD74FD9060F8E0A26A41A716BCEF3C023332A5D92FB96D8325C4FB0A0B48C;
defparam promx9_inst_0.INIT_RAM_3F = 288'h191952EC97DCBAC192E27DC525B46B01E524AB62777ED0F94908B67446E9B7FD8F8C2C48;

pROMX9 promx9_inst_1 (
    .DO({promx9_inst_1_dout_w[26:0],promx9_inst_1_dout[8:0]}),
    .CLK(clk),
    .OCE(oce),
    .CE(lut_f_1),
    .RESET(reset),
    .AD({ad[10:0],gw_gnd,gw_gnd,gw_gnd})
);

defparam promx9_inst_1.READ_MODE = 1'b0;
defparam promx9_inst_1.BIT_WIDTH = 9;
defparam promx9_inst_1.RESET_MODE = "ASYNC";
defparam promx9_inst_1.INIT_RAM_00 = 288'hF50749E8159B96314ABE6BBC213229DD54DC87502E7A5EB824786E5034A0B37B4E6F9C00;
defparam promx9_inst_1.INIT_RAM_01 = 288'hD3760143C37281A7059BDA737CDFF8C4C695643EA595EC870BE8272CA2D7AEF915530DB8;
defparam promx9_inst_1.INIT_RAM_02 = 288'hB566F9BFF1898928C67C4AAB98DDFFC4465543AE5D71CA760365E40B120F4AC6F4428574;
defparam promx9_inst_1.INIT_RAM_03 = 288'h9CDAB37CDFF0BCC292623D64D58C4EEFD81E27A0566E48B51EF3ABEE0387E7151B560D38;
defparam promx9_inst_1.INIT_RAM_04 = 288'h8BD22F1A9ED02C786D4F33DFF30B0E4B87F41315D10B97546E997DD7F80224239A95AD07;
defparam promx9_inst_1.INIT_RAM_05 = 288'h844E2D199E4FE45259452E9D51BA5DF359DC068F4DC9E67BFE6161C8F0BE4232A2156AE6;
defparam promx9_inst_1.INIT_RAM_06 = 288'h884FEDF9EE77F45A5C462EDD71BA55EB55D9048E4D298643E25158C46E3D018241E150D8;
defparam promx9_inst_1.INIT_RAM_07 = 288'h99D8721BEF686C947953B5A0B34B164781EF0F134F8AB6D4267167CB717E82429A0962E1;
defparam promx9_inst_1.INIT_RAM_08 = 288'hB9E879DFC1495D0AB27043A7969CBF17E621279F556D983CD6C792E07B8384B3CA9DAD04;
defparam promx9_inst_1.INIT_RAM_09 = 288'hEB0085C5B43AD1C10D9D59B27C0F68648C7350335F527AA6075DDB048D8C6905F3AE3146;
defparam promx9_inst_1.INIT_RAM_0A = 288'h2EA2166DF854D6C38CDC78C1E3A332457AE98A502D998E27C038483A28198F892546FBA9;
defparam promx9_inst_1.INIT_RAM_0B = 288'h86CDEC38BDAF7C12332EA1D62DC834C2B785D87680A2F2D2155EDA82CC2B786D8F700E32;
defparam promx9_inst_1.INIT_RAM_0C = 288'hF4844726245ACDB90596D5AFFA8E8FE8464C3AA798EF18D50EDB96E07A4263C3324172E3;
defparam promx9_inst_1.INIT_RAM_0D = 288'h79C6A8368C7EDBBA051614CF6A264BC63140B463F6FDF038BCAE7F53B3DEF1FA3DBF31C0;
defparam promx9_inst_1.INIT_RAM_0E = 288'h18154F4A062BAE2136AE6074FCDF98647E6545AC5AEFD9252AE197DEF9016312C1FD4ACC;
defparam promx9_inst_1.INIT_RAM_0F = 288'hD0F17D00C18150F09C60392112CA85D333BDF1018564F3A2657AE283CB2A376CDF03CA0A;
defparam promx9_inst_1.INIT_RAM_10 = 288'hA55B31DB0E97D02C382D9F53EC27241E534CB7E4769D7FD0748063432A598F089CDEB57E;
defparam promx9_inst_1.INIT_RAM_11 = 288'h9753ADD8ED773BDE0F17940E09159349E7149AD5AEF98DCF6BF61C1F17D00A2623960F29;
defparam promx9_inst_1.INIT_RAM_12 = 288'hA75B717A9E3F9408222017CFC9C5DB69F3179B556EB94D9F4BE21118140DE8F57B39DD0E;
defparam promx9_inst_1.INIT_RAM_13 = 288'hD772BCC030F8ECAE74482B592E681C827959BB64F61CEF58204C43301F938B96BBD62730;
defparam promx9_inst_1.INIT_RAM_14 = 288'h281A9089E5C349D90790CF2AD71C5E9B83DCFB8485A48319F934B5683B211239FD6EEF92;
defparam promx9_inst_1.INIT_RAM_15 = 288'h9AD36CB7DCAEB78BDDFA8384C3E2B9C110A15D34DD9058F4DEA169C1E736DCFF48083836;
defparam promx9_inst_1.INIT_RAM_16 = 288'h301D516A15B331C4F8874927751B3DFB29ABE0F63DE060E8D096623CA4150BF6B3BA0D1D;
defparam promx9_inst_1.INIT_RAM_17 = 288'hE9797F00C0F8CC8E5A372092CAA5F34DCEFB88492734DB15DF17A0DAF2BBFF50507C6A4A;
defparam promx9_inst_1.INIT_RAM_18 = 288'hC66775FC0E8F8BE8050B8A0744C2F1C10494532E194DD77C0A29279CD32BF72C2E6357BE;
defparam promx9_inst_1.INIT_RAM_19 = 288'hC96835FBEE6F73D7FA04864503723958CC76432594AB663359CCF683C5E5138A4D6AD77B;
defparam promx9_inst_1.INIT_RAM_1A = 288'hF17BFF6070A0845A3A23950C26E3DA212CA3582F998D973BD607118FCB67749AC59AE983;
defparam promx9_inst_1.INIT_RAM_1B = 288'h3FA25269D542C978C668B6DCCF17DC1A231C93CCA7D49AA582D777C163B35A6D96FB95D6;
defparam promx9_inst_1.INIT_RAM_1C = 288'hB55CAF381C464331A0D46C371C1E4F47B5E2F5FD3FA050705C402A198F08C4F2C988D876;
defparam promx9_inst_1.INIT_RAM_1D = 288'h51AA15AB25BAF584C866B4DB2DE723A9E0F67EC0E13108B476472A98CE27F46A6D52B763;
defparam promx9_inst_1.INIT_RAM_1E = 288'h150B45E321A8E0763E209108E4B27148AA592E980C868361C0EA793EA090C8B47A51329E;
defparam promx9_inst_1.INIT_RAM_1F = 288'h000000001008040402018100A0603820120A058301C0F0884C28160C068381E1008C4A27;
defparam promx9_inst_1.INIT_RAM_20 = 288'h1288C401E0E06830160A04C220F07030160A048200E06028100602010040201000000000;
defparam promx9_inst_1.INIT_RAM_21 = 288'h4CA511E8B43208FA793A9C0D86832180BA592A9489C4B23910823E1D8E06A32178B45427;
defparam promx9_inst_1.INIT_RAM_22 = 288'hADD529B469FCE2632A91C762D1084C0DFAF6783A9C8DE6CB4D9AC8612F56EB256AA1469E;
defparam promx9_inst_1.INIT_RAM_23 = 288'h36188B24F230F0662A1005C1C05FEFD3D7E2ED74793C1DC6C351A0CC6431181BCDCAD563;
defparam promx9_inst_1.INIT_RAM_24 = 288'hE56FB65A6CD63B0577B5D82A9499F4CA4F1C88C19F6F17336DA2C65E2C9509D49A24FE76;
defparam promx9_inst_1.INIT_RAM_25 = 288'hBA59AB1499DCB63F1181BD5CED9662F960A34B220F66E309508E3A168842807FDFBFC5D6;
defparam promx9_inst_1.INIT_RAM_26 = 288'hB5D6A93389445E0EF6733598CB652A590C76331588E371406413FAF5F739BBED7E832583;
defparam promx9_inst_1.INIT_RAM_27 = 288'hD5E630B72AFD3273278A409DEDD652E14C94411C0BC4C1D0A02E05FA78BA3C0D7E77197B;
defparam promx9_inst_1.INIT_RAM_28 = 288'h1A87C15F5EFF2B6BA0C5DDEC54D9CC9220FB73B4D7CAA4B208DC5A238CC3E0CFC797A5BE;
defparam promx9_inst_1.INIT_RAM_29 = 288'h833B9ACBF54240F262258D03A06F7F6383ABCA5FACF519DC921CF8713316CA1459D4C04A;
defparam promx9_inst_1.INIT_RAM_2A = 288'h0E00BD3CFDB6730769A84DE3D057634D74A1441C0AE3E1303BEBDDE2EB72B7DB2D366B1D;
defparam promx9_inst_1.INIT_RAM_2B = 288'hBBD6E7F23843B1A0B54D1F8C6481684BEFDCE0E9B1771AB4F2430776349709E421A8A036;
defparam promx9_inst_1.INIT_RAM_2C = 288'h89BD5AEB94E1F8C04313023D7CED864EED599E48206E664AB520742B8EC3E03F372B5D92;
defparam promx9_inst_1.INIT_RAM_2D = 288'h773395E8F379406011F8F4B6794BAD566D177CB69769C3F17C8022027978FA9C5DB69D30;
defparam promx9_inst_1.INIT_RAM_2E = 288'h83B9588A24017C7C1CFDF6B7398BBD5A6B1479B496491381405E0FF7F3B5D8EB753A5D0E;
defparam promx9_inst_1.INIT_RAM_2F = 288'hAD4DE26F0662A50C6320077F5D7DA646DF4C94C1DC8C24F9F4B6380B7D3A5B0C75B29529;
defparam promx9_inst_1.INIT_RAM_30 = 288'hF2F033776A8CB20EE25EA64E84F1581BC5BDCCDD2A12C84391809C3C150600CF4717437E;
defparam promx9_inst_1.INIT_RAM_31 = 288'h529FCB03105F937B97B852A48FD6BAC516651F867E7CDD3E06B936883AD8AA03D154600A;
defparam promx9_inst_1.INIT_RAM_32 = 288'hCC5BE8F1F7BB3D4E7F2B8BC0FDFDBE3ED1408C3C592A23D94C5805EEEDB1F68A0C69E6CC;
defparam promx9_inst_1.INIT_RAM_33 = 288'h5CA40CC3C09FA78196B6D0E34F163A78EA4C11FEBA3A8BFD5A5B056E2CD16621C847D3C0;
defparam promx9_inst_1.INIT_RAM_34 = 288'h03F736386ADCC20ADA57A14B42F02F6B6185ADCC20CDC58A1CBA3304F7F6B8BB0CDE1AE3;
defparam promx9_inst_1.INIT_RAM_35 = 288'hBED4648F866280E8480E7C38998B650228E95EA44CC3A07F8F718CB0CD614DF59A20BA32;
defparam promx9_inst_1.INIT_RAM_36 = 288'h8C3AD7C90318D813DBD7606A9277D335407323067DBC0C9D9A750D702D10E5B1700BADA9;
defparam promx9_inst_1.INIT_RAM_37 = 288'h6B29CF24B0E7BB8192B1CD60ED9559F49E21F9F172F699E439C0B24295C53FCE7686E746;
defparam promx9_inst_1.INIT_RAM_38 = 288'h58A08A624FA7172D679C425B4AB3E1343DEFE0646C53482B594E792506FDBBEC85866704;
defparam promx9_inst_1.INIT_RAM_39 = 288'h541E09018F46E31158943E19098348E413D9D55EA951B75AED185C16FF79D9EB7CFE20E1;
defparam promx9_inst_1.INIT_RAM_3A = 288'h5AA14A823F970B2361983FD9E9E370F41BDCD65F2971B752E9145914FE79399B44E210D8;
defparam promx9_inst_1.INIT_RAM_3B = 288'h6B294E64208F835F7DA646DD4B94415C4DF4E1E4AC3307FB3D3C6D1E02FB5A9BC5222EE6;
defparam promx9_inst_1.INIT_RAM_3C = 288'h8335546711F83BB9ABBCD1E2CE459A049E1EF66EF1358933D58892308BFFDCDCDDAA7307;
defparam promx9_inst_1.INIT_RAM_3D = 288'hA1441BCAC3D1202DE4D96029D1C75AE50E5511FC77F8DAE4A9F0C64A18863FFE6E6ED538;
defparam promx9_inst_1.INIT_RAM_3E = 288'hC355244EF5EA2CB227FA70B215E963E99095318C7FFCDCDDA66F0569A80DC3C057634D74;
defparam promx9_inst_1.INIT_RAM_3F = 288'hE766ED33782B49406E1E027AFA5B9D021CDC551DC8A13F0EBAF94A8C395668127877D5B8;

pROMX9 promx9_inst_2 (
    .DO({promx9_inst_2_dout_w[26:0],promx9_inst_2_dout[8:0]}),
    .CLK(clk),
    .OCE(oce),
    .CE(lut_f_2),
    .RESET(reset),
    .AD({ad[10:0],gw_gnd,gw_gnd,gw_gnd})
);

defparam promx9_inst_2.READ_MODE = 1'b0;
defparam promx9_inst_2.BIT_WIDTH = 9;
defparam promx9_inst_2.RESET_MODE = "ASYNC";
defparam promx9_inst_2.INIT_RAM_00 = 288'hF07034180B05024100703014080301004000F07034180B05024100703014080301004000;
defparam promx9_inst_2.INIT_RAM_01 = 288'hF07034180B05024100703014080301004000F07034180B05024100703014080301004000;
defparam promx9_inst_2.INIT_RAM_02 = 288'hF07034180B05024100703014080301004000F07034180B05024100703014080301004000;
defparam promx9_inst_2.INIT_RAM_03 = 288'hF07034180B05024100703014080301004000F07034180B05024100703014080301004000;
defparam promx9_inst_2.INIT_RAM_04 = 288'hF07034180B05024100703014080301004000F07034180B05024100703014080301004000;
defparam promx9_inst_2.INIT_RAM_05 = 288'hF07034180B05024100703014080301004000F07034180B05024100703014080301004000;
defparam promx9_inst_2.INIT_RAM_06 = 288'hF07034180B05024100703014080301004000F07034180B05024100703014080301004000;
defparam promx9_inst_2.INIT_RAM_07 = 288'hF07034180B05024100703014080301004000F07034180B05024100703014080301004000;
defparam promx9_inst_2.INIT_RAM_08 = 288'hF07034180B05024100703014080301004000F07034180B05024100703014080301004000;
defparam promx9_inst_2.INIT_RAM_09 = 288'hF07034180B05024100703014080301004000F07034180B05024100703014080301004000;
defparam promx9_inst_2.INIT_RAM_0A = 288'hF07034180B05024100703014080301004000F07034180B05024100703014080301004000;
defparam promx9_inst_2.INIT_RAM_0B = 288'hF07034180B05024100703014080301004000F07034180B05024100703014080301004000;
defparam promx9_inst_2.INIT_RAM_0C = 288'hF07034180B05024100703014080301004000F07034180B05024100703014080301004000;
defparam promx9_inst_2.INIT_RAM_0D = 288'hF07034180B05024100703014080301004000F07034180B05024100703014080301004000;
defparam promx9_inst_2.INIT_RAM_0E = 288'hF07034180B05024100703014080301004000F07034180B05024100703014080301004000;
defparam promx9_inst_2.INIT_RAM_0F = 288'hF07034180B05024100703014080301004000F07034180B05024100703014080301004000;
defparam promx9_inst_2.INIT_RAM_10 = 288'hF07034180B05024100703014080301004000F07034180B05024100703014080301004000;
defparam promx9_inst_2.INIT_RAM_11 = 288'hF07034180B05024100703014080301004000F07034180B05024100703014080301004000;
defparam promx9_inst_2.INIT_RAM_12 = 288'hF07034180B05024100703014080301004000F07034180B05024100703014080301004000;
defparam promx9_inst_2.INIT_RAM_13 = 288'hF07034180B05024100703014080301004000F07034180B05024100703014080301004000;
defparam promx9_inst_2.INIT_RAM_14 = 288'hF07034180B05024100703014080301004000F07034180B05024100703014080301004000;
defparam promx9_inst_2.INIT_RAM_15 = 288'hF07034180B05024100703014080301004000F07034180B05024100703014080301004000;
defparam promx9_inst_2.INIT_RAM_16 = 288'hF07034180B05024100703014080301004000F07034180B05024100703014080301004000;
defparam promx9_inst_2.INIT_RAM_17 = 288'hF07034180B05024100703014080301004000F07034180B05024100703014080301004000;
defparam promx9_inst_2.INIT_RAM_18 = 288'hF07034180B05024100703014080301004000F07034180B05024100703014080301004000;
defparam promx9_inst_2.INIT_RAM_19 = 288'hF07034180B05024100703014080301004000F07034180B05024100703014080301004000;
defparam promx9_inst_2.INIT_RAM_1A = 288'hF07034180B05024100703014080301004000F07034180B05024100703014080301004000;
defparam promx9_inst_2.INIT_RAM_1B = 288'hF07034180B05024100703014080301004000F07034180B05024100703014080301004000;
defparam promx9_inst_2.INIT_RAM_1C = 288'hF07034180B05024100703014080301004000F07034180B05024100703014080301004000;
defparam promx9_inst_2.INIT_RAM_1D = 288'hF07034180B05024100703014080301004000F07034180B05024100703014080301004000;
defparam promx9_inst_2.INIT_RAM_1E = 288'hF07034180B05024100703014080301004000F07034180B05024100703014080301004000;
defparam promx9_inst_2.INIT_RAM_1F = 288'hF07034180B05024100703014080301004000F07034180B05024100703014080301004000;
defparam promx9_inst_2.INIT_RAM_20 = 288'h10100C08050301C10090502C180D0703C00010100C08050301C10090502C180D0703C1FF;
defparam promx9_inst_2.INIT_RAM_21 = 288'h10100C08050301C10090502C180D0703C00010100C08050301C10090502C180D0703C000;
defparam promx9_inst_2.INIT_RAM_22 = 288'h10100C08050301C10090502C180D0703C00010100C08050301C10090502C180D0703C000;
defparam promx9_inst_2.INIT_RAM_23 = 288'h10100C08050301C10090502C180D0703C00010100C08050301C10090502C180D0703C000;
defparam promx9_inst_2.INIT_RAM_24 = 288'h10100C08050301C10090502C180D0703C00010100C08050301C10090502C180D0703C000;
defparam promx9_inst_2.INIT_RAM_25 = 288'h10100C08050301C10090502C180D0703C00010100C08050301C10090502C180D0703C000;
defparam promx9_inst_2.INIT_RAM_26 = 288'h10100C08050301C10090502C180D0703C00010100C08050301C10090502C180D0703C000;
defparam promx9_inst_2.INIT_RAM_27 = 288'h10100C08050301C10090502C180D0703C00010100C08050301C10090502C180D0703C000;
defparam promx9_inst_2.INIT_RAM_28 = 288'h10100C08050301C10090502C180D0703C00010100C08050301C10090502C180D0703C000;
defparam promx9_inst_2.INIT_RAM_29 = 288'h10100C08050301C10090502C180D0703C00010100C08050301C10090502C180D0703C000;
defparam promx9_inst_2.INIT_RAM_2A = 288'h10100C08050301C10090502C180D0703C00010100C08050301C10090502C180D0703C000;
defparam promx9_inst_2.INIT_RAM_2B = 288'h10100C08050301C10090502C180D0703C00010100C08050301C10090502C180D0703C000;
defparam promx9_inst_2.INIT_RAM_2C = 288'h10100C08050301C10090502C180D0703C00010100C08050301C10090502C180D0703C000;
defparam promx9_inst_2.INIT_RAM_2D = 288'h10100C08050301C10090502C180D0703C00010100C08050301C10090502C180D0703C000;
defparam promx9_inst_2.INIT_RAM_2E = 288'h10100C08050301C10090502C180D0703C00010100C08050301C10090502C180D0703C000;
defparam promx9_inst_2.INIT_RAM_2F = 288'h10100C08050301C10090502C180D0703C00010100C08050301C10090502C180D0703C000;
defparam promx9_inst_2.INIT_RAM_30 = 288'h10100C08050301C10090502C180D0703C00010100C08050301C10090502C180D0703C000;
defparam promx9_inst_2.INIT_RAM_31 = 288'h10100C08050301C10090502C180D0703C00010100C08050301C10090502C180D0703C000;
defparam promx9_inst_2.INIT_RAM_32 = 288'h10100C08050301C10090502C180D0703C00010100C08050301C10090502C180D0703C000;
defparam promx9_inst_2.INIT_RAM_33 = 288'h10100C08050301C10090502C180D0703C00010100C08050301C10090502C180D0703C000;
defparam promx9_inst_2.INIT_RAM_34 = 288'h10100C08050301C10090502C180D0703C00010100C08050301C10090502C180D0703C000;
defparam promx9_inst_2.INIT_RAM_35 = 288'h10100C08050301C10090502C180D0703C00010100C08050301C10090502C180D0703C000;
defparam promx9_inst_2.INIT_RAM_36 = 288'h10100C08050301C10090502C180D0703C00010100C08050301C10090502C180D0703C000;
defparam promx9_inst_2.INIT_RAM_37 = 288'h10100C08050301C10090502C180D0703C00010100C08050301C10090502C180D0703C000;
defparam promx9_inst_2.INIT_RAM_38 = 288'h10100C08050301C10090502C180D0703C00010100C08050301C10090502C180D0703C000;
defparam promx9_inst_2.INIT_RAM_39 = 288'h10100C08050301C10090502C180D0703C00010100C08050301C10090502C180D0703C000;
defparam promx9_inst_2.INIT_RAM_3A = 288'h10100C08050301C10090502C180D0703C00010100C08050301C10090502C180D0703C000;
defparam promx9_inst_2.INIT_RAM_3B = 288'h10100C08050301C10090502C180D0703C00010100C08050301C10090502C180D0703C000;
defparam promx9_inst_2.INIT_RAM_3C = 288'h10100C08050301C10090502C180D0703C00010100C08050301C10090502C180D0703C000;
defparam promx9_inst_2.INIT_RAM_3D = 288'h10100C08050301C10090502C180D0703C00010100C08050301C10090502C180D0703C000;
defparam promx9_inst_2.INIT_RAM_3E = 288'h10100C08050301C10090502C180D0703C00010100C08050301C10090502C180D0703C000;
defparam promx9_inst_2.INIT_RAM_3F = 288'h10100C08050301C10090502C180D0703C00010100C08050301C10090502C180D0703C000;

pROMX9 promx9_inst_3 (
    .DO({promx9_inst_3_dout_w[26:0],promx9_inst_3_dout[8:0]}),
    .CLK(clk),
    .OCE(oce),
    .CE(lut_f_3),
    .RESET(reset),
    .AD({ad[10:0],gw_gnd,gw_gnd,gw_gnd})
);

defparam promx9_inst_3.READ_MODE = 1'b0;
defparam promx9_inst_3.BIT_WIDTH = 9;
defparam promx9_inst_3.RESET_MODE = "ASYNC";
defparam promx9_inst_3.INIT_RAM_00 = 288'h10100C08050301C10090502C180D0703C00010100C08050301C10090502C180D0703C000;
defparam promx9_inst_3.INIT_RAM_01 = 288'h10100C08050301C10090502C180D0703C00010100C08050301C10090502C180D0703C000;
defparam promx9_inst_3.INIT_RAM_02 = 288'h10100C08050301C10090502C180D0703C00010100C08050301C10090502C180D0703C000;
defparam promx9_inst_3.INIT_RAM_03 = 288'h10100C08050301C10090502C180D0703C00010100C08050301C10090502C180D0703C000;
defparam promx9_inst_3.INIT_RAM_04 = 288'h10100C08050301C10090502C180D0703C00010100C08050301C10090502C180D0703C000;
defparam promx9_inst_3.INIT_RAM_05 = 288'h10100C08050301C10090502C180D0703C00010100C08050301C10090502C180D0703C000;
defparam promx9_inst_3.INIT_RAM_06 = 288'h10100C08050301C10090502C180D0703C00010100C08050301C10090502C180D0703C000;
defparam promx9_inst_3.INIT_RAM_07 = 288'h10100C08050301C10090502C180D0703C00010100C08050301C10090502C180D0703C000;
defparam promx9_inst_3.INIT_RAM_08 = 288'h10100C08050301C10090502C180D0703C00010100C08050301C10090502C180D0703C000;
defparam promx9_inst_3.INIT_RAM_09 = 288'h10100C08050301C10090502C180D0703C00010100C08050301C10090502C180D0703C000;
defparam promx9_inst_3.INIT_RAM_0A = 288'h10100C08050301C10090502C180D0703C00010100C08050301C10090502C180D0703C000;
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
defparam promx9_inst_3.INIT_RAM_2F = 288'hF07034180B05024100703014080301004000F07034180B05024100703014080301004000;
defparam promx9_inst_3.INIT_RAM_30 = 288'hF07034180B05024100703014080301004000F07034180B05024100703014080301004000;
defparam promx9_inst_3.INIT_RAM_31 = 288'hF07034180B05024100703014080301004000F07034180B05024100703014080301004000;
defparam promx9_inst_3.INIT_RAM_32 = 288'hF07034180B05024100703014080301004000F07034180B05024100703014080301004000;
defparam promx9_inst_3.INIT_RAM_33 = 288'hF07034180B05024100703014080301004000F07034180B05024100703014080301004000;
defparam promx9_inst_3.INIT_RAM_34 = 288'hF07034180B05024100703014080301004000F07034180B05024100703014080301004000;
defparam promx9_inst_3.INIT_RAM_35 = 288'hF07034180B05024100703014080301004000F07034180B05024100703014080301004000;
defparam promx9_inst_3.INIT_RAM_36 = 288'hF07034180B05024100703014080301004000F07034180B05024100703014080301004000;
defparam promx9_inst_3.INIT_RAM_37 = 288'hF07034180B05024100703014080301004000F07034180B05024100703014080301004000;
defparam promx9_inst_3.INIT_RAM_38 = 288'hF07034180B05024100703014080301004000F07034180B05024100703014080301004000;
defparam promx9_inst_3.INIT_RAM_39 = 288'hF07034180B05024100703014080301004000F07034180B05024100703014080301004000;
defparam promx9_inst_3.INIT_RAM_3A = 288'hF07034180B05024100703014080301004000F07034180B05024100703014080301004000;
defparam promx9_inst_3.INIT_RAM_3B = 288'hF07034180B05024100703014080301004000F07034180B05024100703014080301004000;
defparam promx9_inst_3.INIT_RAM_3C = 288'hF07034180B05024100703014080301004000F07034180B05024100703014080301004000;
defparam promx9_inst_3.INIT_RAM_3D = 288'hF07034180B05024100703014080301004000F07034180B05024100703014080301004000;
defparam promx9_inst_3.INIT_RAM_3E = 288'hF07034180B05024100703014080301004000F07034180B05024100703014080301004000;
defparam promx9_inst_3.INIT_RAM_3F = 288'hF07034180B05024100703014080301004000F07034180B05024100703014080301004000;

pROMX9 promx9_inst_4 (
    .DO({promx9_inst_4_dout_w[26:0],promx9_inst_4_dout[8:0]}),
    .CLK(clk),
    .OCE(oce),
    .CE(lut_f_4),
    .RESET(reset),
    .AD({ad[10:0],gw_gnd,gw_gnd,gw_gnd})
);

defparam promx9_inst_4.READ_MODE = 1'b0;
defparam promx9_inst_4.BIT_WIDTH = 9;
defparam promx9_inst_4.RESET_MODE = "ASYNC";
defparam promx9_inst_4.INIT_RAM_00 = 288'hF8783A1C0D86832180B8582A14098482210078381A0C058281208038180A040180802000;
defparam promx9_inst_4.INIT_RAM_01 = 288'hF8783A1C0D86832180B8582A14098482210078381A0C058281208038180A040180802000;
defparam promx9_inst_4.INIT_RAM_02 = 288'hF8783A1C0D86832180B8582A14098482210078381A0C058281208038180A040180802000;
defparam promx9_inst_4.INIT_RAM_03 = 288'hF8783A1C0D86832180B8582A14098482210078381A0C058281208038180A040180802000;
defparam promx9_inst_4.INIT_RAM_04 = 288'hF8783A1C0D86832180B8582A14098482210078381A0C058281208038180A040180802000;
defparam promx9_inst_4.INIT_RAM_05 = 288'hF8783A1C0D86832180B8582A14098482210078381A0C058281208038180A040180802000;
defparam promx9_inst_4.INIT_RAM_06 = 288'hF8783A1C0D86832180B8582A14098482210078381A0C058281208038180A040180802000;
defparam promx9_inst_4.INIT_RAM_07 = 288'hF8783A1C0D86832180B8582A14098482210078381A0C058281208038180A040180802000;
defparam promx9_inst_4.INIT_RAM_08 = 288'hF8783A1C0D86832180B8582A14098482210078381A0C058281208038180A040180802000;
defparam promx9_inst_4.INIT_RAM_09 = 288'hF8783A1C0D86832180B8582A14098482210078381A0C058281208038180A040180802000;
defparam promx9_inst_4.INIT_RAM_0A = 288'hF8783A1C0D86832180B8582A14098482210078381A0C058281208038180A040180802000;
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
defparam promx9_inst_4.INIT_RAM_2F = 288'hF8783A1C0D86832180B8582A14098482210078381A0C058281208038180A040180802000;
defparam promx9_inst_4.INIT_RAM_30 = 288'hF8783A1C0D86832180B8582A14098482210078381A0C058281208038180A040180802000;
defparam promx9_inst_4.INIT_RAM_31 = 288'hF8783A1C0D86832180B8582A14098482210078381A0C058281208038180A040180802000;
defparam promx9_inst_4.INIT_RAM_32 = 288'hF8783A1C0D86832180B8582A14098482210078381A0C058281208038180A040180802000;
defparam promx9_inst_4.INIT_RAM_33 = 288'hF8783A1C0D86832180B8582A14098482210078381A0C058281208038180A040180802000;
defparam promx9_inst_4.INIT_RAM_34 = 288'hF8783A1C0D86832180B8582A14098482210078381A0C058281208038180A040180802000;
defparam promx9_inst_4.INIT_RAM_35 = 288'hF8783A1C0D86832180B8582A14098482210078381A0C058281208038180A040180802000;
defparam promx9_inst_4.INIT_RAM_36 = 288'hF8783A1C0D86832180B8582A14098482210078381A0C058281208038180A040180802000;
defparam promx9_inst_4.INIT_RAM_37 = 288'hF8783A1C0D86832180B8582A14098482210078381A0C058281208038180A040180802000;
defparam promx9_inst_4.INIT_RAM_38 = 288'hF8783A1C0D86832180B8582A14098482210078381A0C058281208038180A040180802000;
defparam promx9_inst_4.INIT_RAM_39 = 288'hF8783A1C0D86832180B8582A14098482210078381A0C058281208038180A040180802000;
defparam promx9_inst_4.INIT_RAM_3A = 288'hF8783A1C0D86832180B8582A14098482210078381A0C058281208038180A040180802000;
defparam promx9_inst_4.INIT_RAM_3B = 288'hF8783A1C0D86832180B8582A14098482210078381A0C058281208038180A040180802000;
defparam promx9_inst_4.INIT_RAM_3C = 288'hF8783A1C0D86832180B8582A14098482210078381A0C058281208038180A040180802000;
defparam promx9_inst_4.INIT_RAM_3D = 288'hF8783A1C0D86832180B8582A14098482210078381A0C058281208038180A040180802000;
defparam promx9_inst_4.INIT_RAM_3E = 288'hF8783A1C0D86832180B8582A14098482210078381A0C058281208038180A040180802000;
defparam promx9_inst_4.INIT_RAM_3F = 288'hF8783A1C0D86832180B8582A14098482210078381A0C058281208038180A040180802000;

pROMX9 promx9_inst_5 (
    .DO({promx9_inst_5_dout_w[26:0],promx9_inst_5_dout[8:0]}),
    .CLK(clk),
    .OCE(oce),
    .CE(lut_f_5),
    .RESET(reset),
    .AD({ad[10:0],gw_gnd,gw_gnd,gw_gnd})
);

defparam promx9_inst_5.READ_MODE = 1'b0;
defparam promx9_inst_5.BIT_WIDTH = 9;
defparam promx9_inst_5.RESET_MODE = "ASYNC";
defparam promx9_inst_5.INIT_RAM_00 = 288'hF8783A1C0D86832180B8582A14098482210078381A0C058281208038180A040180802000;
defparam promx9_inst_5.INIT_RAM_01 = 288'hF8783A1C0D86832180B8582A14098482210078381A0C058281208038180A040180802000;
defparam promx9_inst_5.INIT_RAM_02 = 288'hF8783A1C0D86832180B8582A14098482210078381A0C058281208038180A040180802000;
defparam promx9_inst_5.INIT_RAM_03 = 288'hF8783A1C0D86832180B8582A14098482210078381A0C058281208038180A040180802000;
defparam promx9_inst_5.INIT_RAM_04 = 288'hF8783A1C0D86832180B8582A14098482210078381A0C058281208038180A040180802000;
defparam promx9_inst_5.INIT_RAM_05 = 288'hF8783A1C0D86832180B8582A14098482210078381A0C058281208038180A040180802000;
defparam promx9_inst_5.INIT_RAM_06 = 288'hF8783A1C0D86832180B8582A14098482210078381A0C058281208038180A040180802000;
defparam promx9_inst_5.INIT_RAM_07 = 288'hF8783A1C0D86832180B8582A14098482210078381A0C058281208038180A040180802000;
defparam promx9_inst_5.INIT_RAM_08 = 288'hF8783A1C0D86832180B8582A14098482210078381A0C058281208038180A040180802000;
defparam promx9_inst_5.INIT_RAM_09 = 288'hF8783A1C0D86832180B8582A14098482210078381A0C058281208038180A040180802000;
defparam promx9_inst_5.INIT_RAM_0A = 288'hF8783A1C0D86832180B8582A14098482210078381A0C058281208038180A040180802000;
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
defparam promx9_inst_5.INIT_RAM_2F = 288'hF8783A1C0D86832180B8582A14098482210078381A0C058281208038180A040180802000;
defparam promx9_inst_5.INIT_RAM_30 = 288'hF8783A1C0D86832180B8582A14098482210078381A0C058281208038180A040180802000;
defparam promx9_inst_5.INIT_RAM_31 = 288'hF8783A1C0D86832180B8582A14098482210078381A0C058281208038180A040180802000;
defparam promx9_inst_5.INIT_RAM_32 = 288'hF8783A1C0D86832180B8582A14098482210078381A0C058281208038180A040180802000;
defparam promx9_inst_5.INIT_RAM_33 = 288'hF8783A1C0D86832180B8582A14098482210078381A0C058281208038180A040180802000;
defparam promx9_inst_5.INIT_RAM_34 = 288'hF8783A1C0D86832180B8582A14098482210078381A0C058281208038180A040180802000;
defparam promx9_inst_5.INIT_RAM_35 = 288'hF8783A1C0D86832180B8582A14098482210078381A0C058281208038180A040180802000;
defparam promx9_inst_5.INIT_RAM_36 = 288'hF8783A1C0D86832180B8582A14098482210078381A0C058281208038180A040180802000;
defparam promx9_inst_5.INIT_RAM_37 = 288'hF8783A1C0D86832180B8582A14098482210078381A0C058281208038180A040180802000;
defparam promx9_inst_5.INIT_RAM_38 = 288'hF8783A1C0D86832180B8582A14098482210078381A0C058281208038180A040180802000;
defparam promx9_inst_5.INIT_RAM_39 = 288'hF8783A1C0D86832180B8582A14098482210078381A0C058281208038180A040180802000;
defparam promx9_inst_5.INIT_RAM_3A = 288'hF8783A1C0D86832180B8582A14098482210078381A0C058281208038180A040180802000;
defparam promx9_inst_5.INIT_RAM_3B = 288'hF8783A1C0D86832180B8582A14098482210078381A0C058281208038180A040180802000;
defparam promx9_inst_5.INIT_RAM_3C = 288'hF8783A1C0D86832180B8582A14098482210078381A0C058281208038180A040180802000;
defparam promx9_inst_5.INIT_RAM_3D = 288'hF8783A1C0D86832180B8582A14098482210078381A0C058281208038180A040180802000;
defparam promx9_inst_5.INIT_RAM_3E = 288'hF8783A1C0D86832180B8582A14098482210078381A0C058281208038180A040180802000;
defparam promx9_inst_5.INIT_RAM_3F = 288'hF8783A1C0D86832180B8582A14098482210078381A0C058281208038180A040180802000;

pROMX9 promx9_inst_6 (
    .DO({promx9_inst_6_dout_w[26:0],promx9_inst_6_dout[8:0]}),
    .CLK(clk),
    .OCE(oce),
    .CE(lut_f_6),
    .RESET(reset),
    .AD({ad[10:0],gw_gnd,gw_gnd,gw_gnd})
);

defparam promx9_inst_6.READ_MODE = 1'b0;
defparam promx9_inst_6.BIT_WIDTH = 9;
defparam promx9_inst_6.RESET_MODE = "ASYNC";
defparam promx9_inst_6.INIT_RAM_00 = 288'hFFFFFFFFFFFFFFFFFFFFFFFFFFFFFFFFFFFFFFFFFFFFFFFFFFFFFFFFFFFFFFFFFFFFFFFF;
defparam promx9_inst_6.INIT_RAM_01 = 288'hFFFFFFFFFFFFFFFFFFFFFFFFFFFFFFFFFFFFFFFFFFFFFFFFFFFFFFFFFFFFFFFFFFFFFFFF;
defparam promx9_inst_6.INIT_RAM_02 = 288'hFFFFFFFFFFFFFFFFFFFFFFFFFFFFFFFFFFFFFFFFFFFFFFFFFFFFFFFFFFFFFFFFFFFFFFFF;
defparam promx9_inst_6.INIT_RAM_03 = 288'hFFFFFFFFFFFFFFFFFFFFFFFFFFFFFFFFFFFFFFFFFFFFFFFFFFFFFFFFFFFFFFFFFFFFFFFF;
defparam promx9_inst_6.INIT_RAM_04 = 288'hFFFFFFFFFFFFFFFFFFFFFFFFFFFFFFFFFFFFFFFFFFFFFFFFFFFFFFFFFFFFFFFFFFFFFFFF;
defparam promx9_inst_6.INIT_RAM_05 = 288'hFFFFFFFFFFFFFFFFFFFFFFFFFFFFFFFFFFFFFFFFFFFFFFFFFFFFFFFFFFFFFFFFFFFFFFFF;
defparam promx9_inst_6.INIT_RAM_06 = 288'hFFFFFFFFFFFFFFFFFFFFFFFFFFFFFFFFFFFFFFFFFFFFFFFFFFFFFFFFFFFFFFFFFFFFFFFF;
defparam promx9_inst_6.INIT_RAM_07 = 288'hFFFFFFFFFFFFFFFFFFFFFFFFFFFFFFFFFFFFFFFFFFFFFFFFFFFFFFFFFFFFFFFFFFFFFFFF;
defparam promx9_inst_6.INIT_RAM_08 = 288'hFFFFFFFFFFFFFFFFFFFFFFFFFFFFFFFFFFFFFFFFFFFFFFFFFFFFFFFFFFFFFFFFFFFFFFFF;
defparam promx9_inst_6.INIT_RAM_09 = 288'hFFFFFFFFFFFFFFFFFFFFFFFFFFFFFFFFFFFFFFFFFFFFFFFFFFFFFFFFFFFFFFFFFFFFFFFF;
defparam promx9_inst_6.INIT_RAM_0A = 288'hFFFFFFFFFFFFFFFFFFFFFFFFFFFFFFFFFFFFFFFFFFFFFFFFFFFFFFFFFFFFFFFFFFFFFFFF;
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
defparam promx9_inst_6.INIT_RAM_2F = 288'hFFFFFFFFFFFFFFFFFFFFFFFFFFFFFFFFFFFFFFFFFFFFFFFFFFFFFFFFFFFFFFFFFFFFFFFF;
defparam promx9_inst_6.INIT_RAM_30 = 288'hFFFFFFFFFFFFFFFFFFFFFFFFFFFFFFFFFFFFFFFFFFFFFFFFFFFFFFFFFFFFFFFFFFFFFFFF;
defparam promx9_inst_6.INIT_RAM_31 = 288'hFFFFFFFFFFFFFFFFFFFFFFFFFFFFFFFFFFFFFFFFFFFFFFFFFFFFFFFFFFFFFFFFFFFFFFFF;
defparam promx9_inst_6.INIT_RAM_32 = 288'hFFFFFFFFFFFFFFFFFFFFFFFFFFFFFFFFFFFFFFFFFFFFFFFFFFFFFFFFFFFFFFFFFFFFFFFF;
defparam promx9_inst_6.INIT_RAM_33 = 288'hFFFFFFFFFFFFFFFFFFFFFFFFFFFFFFFFFFFFFFFFFFFFFFFFFFFFFFFFFFFFFFFFFFFFFFFF;
defparam promx9_inst_6.INIT_RAM_34 = 288'hFFFFFFFFFFFFFFFFFFFFFFFFFFFFFFFFFFFFFFFFFFFFFFFFFFFFFFFFFFFFFFFFFFFFFFFF;
defparam promx9_inst_6.INIT_RAM_35 = 288'hFFFFFFFFFFFFFFFFFFFFFFFFFFFFFFFFFFFFFFFFFFFFFFFFFFFFFFFFFFFFFFFFFFFFFFFF;
defparam promx9_inst_6.INIT_RAM_36 = 288'hFFFFFFFFFFFFFFFFFFFFFFFFFFFFFFFFFFFFFFFFFFFFFFFFFFFFFFFFFFFFFFFFFFFFFFFF;
defparam promx9_inst_6.INIT_RAM_37 = 288'hFFFFFFFFFFFFFFFFFFFFFFFFFFFFFFFFFFFFFFFFFFFFFFFFFFFFFFFFFFFFFFFFFFFFFFFF;
defparam promx9_inst_6.INIT_RAM_38 = 288'hFFFFFFFFFFFFFFFFFFFFFFFFFFFFFFFFFFFFFFFFFFFFFFFFFFFFFFFFFFFFFFFFFFFFFFFF;
defparam promx9_inst_6.INIT_RAM_39 = 288'hFFFFFFFFFFFFFFFFFFFFFFFFFFFFFFFFFFFFFFFFFFFFFFFFFFFFFFFFFFFFFFFFFFFFFFFF;
defparam promx9_inst_6.INIT_RAM_3A = 288'hFFFFFFFFFFFFFFFFFFFFFFFFFFFFFFFFFFFFFFFFFFFFFFFFFFFFFFFFFFFFFFFFFFFFFFFF;
defparam promx9_inst_6.INIT_RAM_3B = 288'hFFFFFFFFFFFFFFFFFFFFFFFFFFFFFFFFFFFFFFFFFFFFFFFFFFFFFFFFFFFFFFFFFFFFFFFF;
defparam promx9_inst_6.INIT_RAM_3C = 288'hFFFFFFFFFFFFFFFFFFFFFFFFFFFFFFFFFFFFFFFFFFFFFFFFFFFFFFFFFFFFFFFFFFFFFFFF;
defparam promx9_inst_6.INIT_RAM_3D = 288'hFFFFFFFFFFFFFFFFFFFFFFFFFFFFFFFFFFFFFFFFFFFFFFFFFFFFFFFFFFFFFFFFFFFFFFFF;
defparam promx9_inst_6.INIT_RAM_3E = 288'hFFFFFFFFFFFFFFFFFFFFFFFFFFFFFFFFFFFFFFFFFFFFFFFFFFFFFFFFFFFFFFFFFFFFFFFF;
defparam promx9_inst_6.INIT_RAM_3F = 288'hFFFFFFFFFFFFFFFFFFFFFFFFFFFFFFFFFFFFFFFFFFFFFFFFFFFFFFFFFFFFFFFFFFFFFFFF;

pROMX9 promx9_inst_7 (
    .DO({promx9_inst_7_dout_w[26:0],promx9_inst_7_dout[8:0]}),
    .CLK(clk),
    .OCE(oce),
    .CE(lut_f_7),
    .RESET(reset),
    .AD({ad[10:0],gw_gnd,gw_gnd,gw_gnd})
);

defparam promx9_inst_7.READ_MODE = 1'b0;
defparam promx9_inst_7.BIT_WIDTH = 9;
defparam promx9_inst_7.RESET_MODE = "ASYNC";
defparam promx9_inst_7.INIT_RAM_00 = 288'h000000000000000000000000000000000000000000000000000000000000000000000000;
defparam promx9_inst_7.INIT_RAM_01 = 288'h000000000000000000000000000000000000000000000000000000000000000000000000;
defparam promx9_inst_7.INIT_RAM_02 = 288'h000000000000000000000000000000000000000000000000000000000000000000000000;
defparam promx9_inst_7.INIT_RAM_03 = 288'h000000000000000000000000000000000000000000000000000000000000000000000000;
defparam promx9_inst_7.INIT_RAM_04 = 288'h000000000000000000000000000000000000000000000000000000000000000000000000;
defparam promx9_inst_7.INIT_RAM_05 = 288'h000000000000000000000000000000000000000000000000000000000000000000000000;
defparam promx9_inst_7.INIT_RAM_06 = 288'h000000000000000000000000000000000000000000000000000000000000000000000000;
defparam promx9_inst_7.INIT_RAM_07 = 288'h000000000000000000000000000000000000000000000000000000000000000000000000;
defparam promx9_inst_7.INIT_RAM_08 = 288'h000000000000000000000000000000000000000000000000000000000000000000000000;
defparam promx9_inst_7.INIT_RAM_09 = 288'h000000000000000000000000000000000000000000000000000000000000000000000000;
defparam promx9_inst_7.INIT_RAM_0A = 288'h000000000000000000000000000000000000000000000000000000000000000000000000;
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
defparam promx9_inst_7.INIT_RAM_3F = 288'h000000000000000000000000000000000000000000000000000000000000000000000000;

pROM prom_inst_8 (
    .DO({prom_inst_8_dout_w[30:0],dout[9]}),
    .CLK(clk),
    .OCE(oce),
    .CE(ce),
    .RESET(reset),
    .AD(ad[13:0])
);

defparam prom_inst_8.READ_MODE = 1'b0;
defparam prom_inst_8.BIT_WIDTH = 1;
defparam prom_inst_8.RESET_MODE = "ASYNC";
defparam prom_inst_8.INIT_RAM_00 = 256'h07FF001FFC00FFE003FF001FF800FFC007FE007FF003FF003FF801FF801FF800;
defparam prom_inst_8.INIT_RAM_01 = 256'hE0007FFE0007FFC001FFF0007FFC003FFC003FFC003FFC007FF800FFF001FFC0;
defparam prom_inst_8.INIT_RAM_02 = 256'hE000000FFFFFE000007FFFF800007FFFE00007FFFC0001FFFE0001FFFC0007FF;
defparam prom_inst_8.INIT_RAM_03 = 256'hFFFFFFFFFFFFFFFFFFFFFFFFFFFFE000000000001FFFFFFFFF00000001FFFFFF;
defparam prom_inst_8.INIT_RAM_04 = 256'hFFFFFF00000001FFFFFFFFF000000000000FFFFFFFFFFFFFFFFFFFFFFFFFFFFF;
defparam prom_inst_8.INIT_RAM_05 = 256'hFFC0007FFF0000FFFF00007FFFC0000FFFFC00003FFFFC00000FFFFFE000000F;
defparam prom_inst_8.INIT_RAM_06 = 256'h07FF001FFE003FFC007FF8007FF8007FF8007FFC001FFF0007FFC000FFFC000F;
defparam prom_inst_8.INIT_RAM_07 = 256'h003FF003FF003FF801FF801FFC00FFC007FE003FF001FF800FFE007FF001FFC0;
defparam prom_inst_8.INIT_RAM_08 = 256'hF800FFE003FF001FFC00FFE007FF003FF801FF800FFC00FFC007FE007FE007FE;
defparam prom_inst_8.INIT_RAM_09 = 256'h1FFF8001FFF8003FFE000FFF8003FFC003FFC003FFC003FF8007FF000FFE003F;
defparam prom_inst_8.INIT_RAM_0A = 256'h1FFFFFF000001FFFFF800007FFFF80001FFFF80003FFFE0001FFFE0003FFF800;
defparam prom_inst_8.INIT_RAM_0B = 256'h00000000000000000000000000001FFFFFFFFFFFE000000000FFFFFFFE000000;
defparam prom_inst_8.INIT_RAM_0C = 256'h000000FFFFFFFE000000000FFFFFFFFFFFF00000000000000000000000000000;
defparam prom_inst_8.INIT_RAM_0D = 256'h003FFF8000FFFF0000FFFF80003FFFF00003FFFFC00003FFFFF000001FFFFFF0;
defparam prom_inst_8.INIT_RAM_0E = 256'hF800FFE001FFC003FF8007FF8007FF8007FF8003FFE000FFF8003FFF0003FFF0;
defparam prom_inst_8.INIT_RAM_0F = 256'hFFC00FFC00FFC007FE007FE003FF003FF801FFC00FFE007FF001FF800FFE003F;
defparam prom_inst_8.INIT_RAM_10 = 256'hFFFF0000FFFF0000FFFF0000FFFF0000FFFF0000FFFF0000FFFF0000FFFF0000;
defparam prom_inst_8.INIT_RAM_11 = 256'hFFFF0000FFFF0000FFFF0000FFFF0000FFFF0000FFFF0000FFFF0000FFFF0000;
defparam prom_inst_8.INIT_RAM_12 = 256'hFFFF0000FFFF0000FFFF0000FFFF0000FFFF0000FFFF0000FFFF0000FFFF0000;
defparam prom_inst_8.INIT_RAM_13 = 256'hFFFF0000FFFF0000FFFF0000FFFF0000FFFF0000FFFF0000FFFF0000FFFF0000;
defparam prom_inst_8.INIT_RAM_14 = 256'h0001FFFE0001FFFE0001FFFE0001FFFE0001FFFE0001FFFE0001FFFE0001FFFF;
defparam prom_inst_8.INIT_RAM_15 = 256'h0001FFFE0001FFFE0001FFFE0001FFFE0001FFFE0001FFFE0001FFFE0001FFFE;
defparam prom_inst_8.INIT_RAM_16 = 256'h0001FFFE0001FFFE0001FFFE0001FFFE0001FFFE0001FFFE0001FFFE0001FFFE;
defparam prom_inst_8.INIT_RAM_17 = 256'h0001FFFE0001FFFE0001FFFE0001FFFE0001FFFE0001FFFE0001FFFE0001FFFE;
defparam prom_inst_8.INIT_RAM_18 = 256'h0001FFFE0001FFFE0001FFFE0001FFFE0001FFFE0001FFFE0001FFFE0001FFFE;
defparam prom_inst_8.INIT_RAM_19 = 256'h0001FFFE0001FFFE0001FFFE0001FFFE0001FFFE0001FFFE0001FFFE0001FFFE;
defparam prom_inst_8.INIT_RAM_1A = 256'h0001FFFE0001FFFE0001FFFE0001FFFE0001FFFE0001FFFE0001FFFE0001FFFE;
defparam prom_inst_8.INIT_RAM_1B = 256'h0001FFFE0001FFFE0001FFFE0001FFFE0001FFFE0001FFFE0001FFFE0001FFFE;
defparam prom_inst_8.INIT_RAM_1C = 256'hFFFF0000FFFF0000FFFF0000FFFF0000FFFF0000FFFF0000FFFF0000FFFF0000;
defparam prom_inst_8.INIT_RAM_1D = 256'hFFFF0000FFFF0000FFFF0000FFFF0000FFFF0000FFFF0000FFFF0000FFFF0000;
defparam prom_inst_8.INIT_RAM_1E = 256'hFFFF0000FFFF0000FFFF0000FFFF0000FFFF0000FFFF0000FFFF0000FFFF0000;
defparam prom_inst_8.INIT_RAM_1F = 256'hFFFF0000FFFF0000FFFF0000FFFF0000FFFF0000FFFF0000FFFF0000FFFF0000;
defparam prom_inst_8.INIT_RAM_20 = 256'hFFFFFFFF00000000FFFFFFFF00000000FFFFFFFF00000000FFFFFFFF00000000;
defparam prom_inst_8.INIT_RAM_21 = 256'hFFFFFFFF00000000FFFFFFFF00000000FFFFFFFF00000000FFFFFFFF00000000;
defparam prom_inst_8.INIT_RAM_22 = 256'hFFFFFFFF00000000FFFFFFFF00000000FFFFFFFF00000000FFFFFFFF00000000;
defparam prom_inst_8.INIT_RAM_23 = 256'hFFFFFFFF00000000FFFFFFFF00000000FFFFFFFF00000000FFFFFFFF00000000;
defparam prom_inst_8.INIT_RAM_24 = 256'hFFFFFFFF00000000FFFFFFFF00000000FFFFFFFF00000000FFFFFFFF00000000;
defparam prom_inst_8.INIT_RAM_25 = 256'hFFFFFFFF00000000FFFFFFFF00000000FFFFFFFF00000000FFFFFFFF00000000;
defparam prom_inst_8.INIT_RAM_26 = 256'hFFFFFFFF00000000FFFFFFFF00000000FFFFFFFF00000000FFFFFFFF00000000;
defparam prom_inst_8.INIT_RAM_27 = 256'hFFFFFFFF00000000FFFFFFFF00000000FFFFFFFF00000000FFFFFFFF00000000;
defparam prom_inst_8.INIT_RAM_28 = 256'hFFFFFFFF00000000FFFFFFFF00000000FFFFFFFF00000000FFFFFFFF00000000;
defparam prom_inst_8.INIT_RAM_29 = 256'hFFFFFFFF00000000FFFFFFFF00000000FFFFFFFF00000000FFFFFFFF00000000;
defparam prom_inst_8.INIT_RAM_2A = 256'hFFFFFFFF00000000FFFFFFFF00000000FFFFFFFF00000000FFFFFFFF00000000;
defparam prom_inst_8.INIT_RAM_2B = 256'hFFFFFFFF00000000FFFFFFFF00000000FFFFFFFF00000000FFFFFFFF00000000;
defparam prom_inst_8.INIT_RAM_2C = 256'hFFFFFFFF00000000FFFFFFFF00000000FFFFFFFF00000000FFFFFFFF00000000;
defparam prom_inst_8.INIT_RAM_2D = 256'hFFFFFFFF00000000FFFFFFFF00000000FFFFFFFF00000000FFFFFFFF00000000;
defparam prom_inst_8.INIT_RAM_2E = 256'hFFFFFFFF00000000FFFFFFFF00000000FFFFFFFF00000000FFFFFFFF00000000;
defparam prom_inst_8.INIT_RAM_2F = 256'hFFFFFFFF00000000FFFFFFFF00000000FFFFFFFF00000000FFFFFFFF00000000;
defparam prom_inst_8.INIT_RAM_30 = 256'hFFFFFFFFFFFFFFFFFFFFFFFFFFFFFFFFFFFFFFFFFFFFFFFFFFFFFFFFFFFFFFFF;
defparam prom_inst_8.INIT_RAM_31 = 256'hFFFFFFFFFFFFFFFFFFFFFFFFFFFFFFFFFFFFFFFFFFFFFFFFFFFFFFFFFFFFFFFF;
defparam prom_inst_8.INIT_RAM_32 = 256'hFFFFFFFFFFFFFFFFFFFFFFFFFFFFFFFFFFFFFFFFFFFFFFFFFFFFFFFFFFFFFFFF;
defparam prom_inst_8.INIT_RAM_33 = 256'hFFFFFFFFFFFFFFFFFFFFFFFFFFFFFFFFFFFFFFFFFFFFFFFFFFFFFFFFFFFFFFFF;
defparam prom_inst_8.INIT_RAM_34 = 256'hFFFFFFFFFFFFFFFFFFFFFFFFFFFFFFFFFFFFFFFFFFFFFFFFFFFFFFFFFFFFFFFF;
defparam prom_inst_8.INIT_RAM_35 = 256'hFFFFFFFFFFFFFFFFFFFFFFFFFFFFFFFFFFFFFFFFFFFFFFFFFFFFFFFFFFFFFFFF;
defparam prom_inst_8.INIT_RAM_36 = 256'hFFFFFFFFFFFFFFFFFFFFFFFFFFFFFFFFFFFFFFFFFFFFFFFFFFFFFFFFFFFFFFFF;
defparam prom_inst_8.INIT_RAM_37 = 256'hFFFFFFFFFFFFFFFFFFFFFFFFFFFFFFFFFFFFFFFFFFFFFFFFFFFFFFFFFFFFFFFF;
defparam prom_inst_8.INIT_RAM_38 = 256'h0000000000000000000000000000000000000000000000000000000000000000;
defparam prom_inst_8.INIT_RAM_39 = 256'h0000000000000000000000000000000000000000000000000000000000000000;
defparam prom_inst_8.INIT_RAM_3A = 256'h0000000000000000000000000000000000000000000000000000000000000000;
defparam prom_inst_8.INIT_RAM_3B = 256'h0000000000000000000000000000000000000000000000000000000000000000;
defparam prom_inst_8.INIT_RAM_3C = 256'h0000000000000000000000000000000000000000000000000000000000000000;
defparam prom_inst_8.INIT_RAM_3D = 256'h0000000000000000000000000000000000000000000000000000000000000000;
defparam prom_inst_8.INIT_RAM_3E = 256'h0000000000000000000000000000000000000000000000000000000000000000;
defparam prom_inst_8.INIT_RAM_3F = 256'h0000000000000000000000000000000000000000000000000000000000000000;

pROM prom_inst_9 (
    .DO({prom_inst_9_dout_w[30:0],dout[10]}),
    .CLK(clk),
    .OCE(oce),
    .CE(ce),
    .RESET(reset),
    .AD(ad[13:0])
);

defparam prom_inst_9.READ_MODE = 1'b0;
defparam prom_inst_9.BIT_WIDTH = 1;
defparam prom_inst_9.RESET_MODE = "ASYNC";
defparam prom_inst_9.INIT_RAM_00 = 256'h07FFFFE00000FFFFFC00001FFFFF000007FFFF800003FFFFC00001FFFFE00000;
defparam prom_inst_9.INIT_RAM_01 = 256'h00007FFFFFF8000001FFFFFF8000003FFFFFC000003FFFFF800000FFFFFE0000;
defparam prom_inst_9.INIT_RAM_02 = 256'hFFFFFFF000000000007FFFFFFFFF8000000007FFFFFFFE00000001FFFFFFF800;
defparam prom_inst_9.INIT_RAM_03 = 256'hFFFFFFFFFFFFFFFFFFFFFFFFFFFFFFFFFFFFFFFFE00000000000000001FFFFFF;
defparam prom_inst_9.INIT_RAM_04 = 256'hFFFFFF00000000000000000FFFFFFFFFFFFFFFFFFFFFFFFFFFFFFFFFFFFFFFFF;
defparam prom_inst_9.INIT_RAM_05 = 256'h003FFFFFFF00000000FFFFFFFFC000000003FFFFFFFFFC00000000001FFFFFFF;
defparam prom_inst_9.INIT_RAM_06 = 256'h0000FFFFFE000003FFFFF8000007FFFFF8000003FFFFFF0000003FFFFFFC0000;
defparam prom_inst_9.INIT_RAM_07 = 256'h00000FFFFF000007FFFF800003FFFFC00001FFFFF000007FFFFE00000FFFFFC0;
defparam prom_inst_9.INIT_RAM_08 = 256'hF800001FFFFF000003FFFFE00000FFFFF800007FFFFC00003FFFFE00001FFFFE;
defparam prom_inst_9.INIT_RAM_09 = 256'hFFFF80000007FFFFFE0000007FFFFFC000003FFFFFC000007FFFFF000001FFFF;
defparam prom_inst_9.INIT_RAM_0A = 256'h0000000FFFFFFFFFFF80000000007FFFFFFFF800000001FFFFFFFE00000007FF;
defparam prom_inst_9.INIT_RAM_0B = 256'h00000000000000000000000000000000000000001FFFFFFFFFFFFFFFFE000000;
defparam prom_inst_9.INIT_RAM_0C = 256'h000000FFFFFFFFFFFFFFFFF00000000000000000000000000000000000000000;
defparam prom_inst_9.INIT_RAM_0D = 256'hFFC0000000FFFFFFFF000000003FFFFFFFFC0000000003FFFFFFFFFFE0000000;
defparam prom_inst_9.INIT_RAM_0E = 256'hFFFF000001FFFFFC000007FFFFF8000007FFFFFC000000FFFFFFC0000003FFFF;
defparam prom_inst_9.INIT_RAM_0F = 256'hFFFFF00000FFFFF800007FFFFC00003FFFFE00000FFFFF800001FFFFF000003F;
defparam prom_inst_9.INIT_RAM_10 = 256'hFFFFFFFF00000000FFFFFFFF00000000FFFFFFFF00000000FFFFFFFF00000000;
defparam prom_inst_9.INIT_RAM_11 = 256'hFFFFFFFF00000000FFFFFFFF00000000FFFFFFFF00000000FFFFFFFF00000000;
defparam prom_inst_9.INIT_RAM_12 = 256'hFFFFFFFF00000000FFFFFFFF00000000FFFFFFFF00000000FFFFFFFF00000000;
defparam prom_inst_9.INIT_RAM_13 = 256'hFFFFFFFF00000000FFFFFFFF00000000FFFFFFFF00000000FFFFFFFF00000000;
defparam prom_inst_9.INIT_RAM_14 = 256'h00000001FFFFFFFE00000001FFFFFFFE00000001FFFFFFFE00000001FFFFFFFF;
defparam prom_inst_9.INIT_RAM_15 = 256'h00000001FFFFFFFE00000001FFFFFFFE00000001FFFFFFFE00000001FFFFFFFE;
defparam prom_inst_9.INIT_RAM_16 = 256'h00000001FFFFFFFE00000001FFFFFFFE00000001FFFFFFFE00000001FFFFFFFE;
defparam prom_inst_9.INIT_RAM_17 = 256'h00000001FFFFFFFE00000001FFFFFFFE00000001FFFFFFFE00000001FFFFFFFE;
defparam prom_inst_9.INIT_RAM_18 = 256'h00000001FFFFFFFE00000001FFFFFFFE00000001FFFFFFFE00000001FFFFFFFE;
defparam prom_inst_9.INIT_RAM_19 = 256'h00000001FFFFFFFE00000001FFFFFFFE00000001FFFFFFFE00000001FFFFFFFE;
defparam prom_inst_9.INIT_RAM_1A = 256'h00000001FFFFFFFE00000001FFFFFFFE00000001FFFFFFFE00000001FFFFFFFE;
defparam prom_inst_9.INIT_RAM_1B = 256'h00000001FFFFFFFE00000001FFFFFFFE00000001FFFFFFFE00000001FFFFFFFE;
defparam prom_inst_9.INIT_RAM_1C = 256'hFFFFFFFF00000000FFFFFFFF00000000FFFFFFFF00000000FFFFFFFF00000000;
defparam prom_inst_9.INIT_RAM_1D = 256'hFFFFFFFF00000000FFFFFFFF00000000FFFFFFFF00000000FFFFFFFF00000000;
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
defparam prom_inst_9.INIT_RAM_3F = 256'h0000000000000000000000000000000000000000000000000000000000000000;

pROM prom_inst_10 (
    .DO({prom_inst_10_dout_w[30:0],dout[11]}),
    .CLK(clk),
    .OCE(oce),
    .CE(ce),
    .RESET(reset),
    .AD(ad[13:0])
);

defparam prom_inst_10.READ_MODE = 1'b0;
defparam prom_inst_10.BIT_WIDTH = 1;
defparam prom_inst_10.RESET_MODE = "ASYNC";
defparam prom_inst_10.INIT_RAM_00 = 256'h07FFFFFFFFFF00000000001FFFFFFFFFF80000000003FFFFFFFFFE0000000000;
defparam prom_inst_10.INIT_RAM_01 = 256'hFFFF80000000000001FFFFFFFFFFFFC000000000003FFFFFFFFFFF0000000000;
defparam prom_inst_10.INIT_RAM_02 = 256'h0000000000000000007FFFFFFFFFFFFFFFFFF80000000000000001FFFFFFFFFF;
defparam prom_inst_10.INIT_RAM_03 = 256'hFFFFFFFFFFFFFFFFFFFFFFFFFFFFFFFFFFFFFFFFFFFFFFFFFFFFFFFFFE000000;
defparam prom_inst_10.INIT_RAM_04 = 256'h000000FFFFFFFFFFFFFFFFFFFFFFFFFFFFFFFFFFFFFFFFFFFFFFFFFFFFFFFFFF;
defparam prom_inst_10.INIT_RAM_05 = 256'hFFFFFFFFFF00000000000000003FFFFFFFFFFFFFFFFFFC000000000000000000;
defparam prom_inst_10.INIT_RAM_06 = 256'h0000000001FFFFFFFFFFF8000000000007FFFFFFFFFFFF00000000000003FFFF;
defparam prom_inst_10.INIT_RAM_07 = 256'h0000000000FFFFFFFFFF80000000003FFFFFFFFFF00000000001FFFFFFFFFFC0;
defparam prom_inst_10.INIT_RAM_08 = 256'hF80000000000FFFFFFFFFFE00000000007FFFFFFFFFC0000000001FFFFFFFFFE;
defparam prom_inst_10.INIT_RAM_09 = 256'h00007FFFFFFFFFFFFE0000000000003FFFFFFFFFFFC00000000000FFFFFFFFFF;
defparam prom_inst_10.INIT_RAM_0A = 256'hFFFFFFFFFFFFFFFFFF80000000000000000007FFFFFFFFFFFFFFFE0000000000;
defparam prom_inst_10.INIT_RAM_0B = 256'h0000000000000000000000000000000000000000000000000000000001FFFFFF;
defparam prom_inst_10.INIT_RAM_0C = 256'hFFFFFF0000000000000000000000000000000000000000000000000000000000;
defparam prom_inst_10.INIT_RAM_0D = 256'h0000000000FFFFFFFFFFFFFFFFC0000000000000000003FFFFFFFFFFFFFFFFFF;
defparam prom_inst_10.INIT_RAM_0E = 256'hFFFFFFFFFE000000000007FFFFFFFFFFF8000000000000FFFFFFFFFFFFFC0000;
defparam prom_inst_10.INIT_RAM_0F = 256'hFFFFFFFFFF00000000007FFFFFFFFFC0000000000FFFFFFFFFFE00000000003F;
defparam prom_inst_10.INIT_RAM_10 = 256'hFFFFFFFFFFFFFFFF0000000000000000FFFFFFFFFFFFFFFF0000000000000000;
defparam prom_inst_10.INIT_RAM_11 = 256'hFFFFFFFFFFFFFFFF0000000000000000FFFFFFFFFFFFFFFF0000000000000000;
defparam prom_inst_10.INIT_RAM_12 = 256'hFFFFFFFFFFFFFFFF0000000000000000FFFFFFFFFFFFFFFF0000000000000000;
defparam prom_inst_10.INIT_RAM_13 = 256'hFFFFFFFFFFFFFFFF0000000000000000FFFFFFFFFFFFFFFF0000000000000000;
defparam prom_inst_10.INIT_RAM_14 = 256'h0000000000000001FFFFFFFFFFFFFFFE0000000000000001FFFFFFFFFFFFFFFF;
defparam prom_inst_10.INIT_RAM_15 = 256'h0000000000000001FFFFFFFFFFFFFFFE0000000000000001FFFFFFFFFFFFFFFE;
defparam prom_inst_10.INIT_RAM_16 = 256'h0000000000000001FFFFFFFFFFFFFFFE0000000000000001FFFFFFFFFFFFFFFE;
defparam prom_inst_10.INIT_RAM_17 = 256'h0000000000000001FFFFFFFFFFFFFFFE0000000000000001FFFFFFFFFFFFFFFE;
defparam prom_inst_10.INIT_RAM_18 = 256'h0000000000000001FFFFFFFFFFFFFFFE0000000000000001FFFFFFFFFFFFFFFE;
defparam prom_inst_10.INIT_RAM_19 = 256'h0000000000000001FFFFFFFFFFFFFFFE0000000000000001FFFFFFFFFFFFFFFE;
defparam prom_inst_10.INIT_RAM_1A = 256'h0000000000000001FFFFFFFFFFFFFFFE0000000000000001FFFFFFFFFFFFFFFE;
defparam prom_inst_10.INIT_RAM_1B = 256'h0000000000000001FFFFFFFFFFFFFFFE0000000000000001FFFFFFFFFFFFFFFE;
defparam prom_inst_10.INIT_RAM_1C = 256'hFFFFFFFFFFFFFFFF0000000000000000FFFFFFFFFFFFFFFF0000000000000000;
defparam prom_inst_10.INIT_RAM_1D = 256'hFFFFFFFFFFFFFFFF0000000000000000FFFFFFFFFFFFFFFF0000000000000000;
defparam prom_inst_10.INIT_RAM_1E = 256'hFFFFFFFFFFFFFFFF0000000000000000FFFFFFFFFFFFFFFF0000000000000000;
defparam prom_inst_10.INIT_RAM_1F = 256'hFFFFFFFFFFFFFFFF0000000000000000FFFFFFFFFFFFFFFF0000000000000000;
defparam prom_inst_10.INIT_RAM_20 = 256'hFFFFFFFFFFFFFFFFFFFFFFFFFFFFFFFF00000000000000000000000000000000;
defparam prom_inst_10.INIT_RAM_21 = 256'hFFFFFFFFFFFFFFFFFFFFFFFFFFFFFFFF00000000000000000000000000000000;
defparam prom_inst_10.INIT_RAM_22 = 256'hFFFFFFFFFFFFFFFFFFFFFFFFFFFFFFFF00000000000000000000000000000000;
defparam prom_inst_10.INIT_RAM_23 = 256'hFFFFFFFFFFFFFFFFFFFFFFFFFFFFFFFF00000000000000000000000000000000;
defparam prom_inst_10.INIT_RAM_24 = 256'hFFFFFFFFFFFFFFFFFFFFFFFFFFFFFFFF00000000000000000000000000000000;
defparam prom_inst_10.INIT_RAM_25 = 256'hFFFFFFFFFFFFFFFFFFFFFFFFFFFFFFFF00000000000000000000000000000000;
defparam prom_inst_10.INIT_RAM_26 = 256'hFFFFFFFFFFFFFFFFFFFFFFFFFFFFFFFF00000000000000000000000000000000;
defparam prom_inst_10.INIT_RAM_27 = 256'hFFFFFFFFFFFFFFFFFFFFFFFFFFFFFFFF00000000000000000000000000000000;
defparam prom_inst_10.INIT_RAM_28 = 256'hFFFFFFFFFFFFFFFFFFFFFFFFFFFFFFFF00000000000000000000000000000000;
defparam prom_inst_10.INIT_RAM_29 = 256'hFFFFFFFFFFFFFFFFFFFFFFFFFFFFFFFF00000000000000000000000000000000;
defparam prom_inst_10.INIT_RAM_2A = 256'hFFFFFFFFFFFFFFFFFFFFFFFFFFFFFFFF00000000000000000000000000000000;
defparam prom_inst_10.INIT_RAM_2B = 256'hFFFFFFFFFFFFFFFFFFFFFFFFFFFFFFFF00000000000000000000000000000000;
defparam prom_inst_10.INIT_RAM_2C = 256'hFFFFFFFFFFFFFFFFFFFFFFFFFFFFFFFF00000000000000000000000000000000;
defparam prom_inst_10.INIT_RAM_2D = 256'hFFFFFFFFFFFFFFFFFFFFFFFFFFFFFFFF00000000000000000000000000000000;
defparam prom_inst_10.INIT_RAM_2E = 256'hFFFFFFFFFFFFFFFFFFFFFFFFFFFFFFFF00000000000000000000000000000000;
defparam prom_inst_10.INIT_RAM_2F = 256'hFFFFFFFFFFFFFFFFFFFFFFFFFFFFFFFF00000000000000000000000000000000;
defparam prom_inst_10.INIT_RAM_30 = 256'hFFFFFFFFFFFFFFFFFFFFFFFFFFFFFFFFFFFFFFFFFFFFFFFFFFFFFFFFFFFFFFFF;
defparam prom_inst_10.INIT_RAM_31 = 256'hFFFFFFFFFFFFFFFFFFFFFFFFFFFFFFFFFFFFFFFFFFFFFFFFFFFFFFFFFFFFFFFF;
defparam prom_inst_10.INIT_RAM_32 = 256'hFFFFFFFFFFFFFFFFFFFFFFFFFFFFFFFFFFFFFFFFFFFFFFFFFFFFFFFFFFFFFFFF;
defparam prom_inst_10.INIT_RAM_33 = 256'hFFFFFFFFFFFFFFFFFFFFFFFFFFFFFFFFFFFFFFFFFFFFFFFFFFFFFFFFFFFFFFFF;
defparam prom_inst_10.INIT_RAM_34 = 256'hFFFFFFFFFFFFFFFFFFFFFFFFFFFFFFFFFFFFFFFFFFFFFFFFFFFFFFFFFFFFFFFF;
defparam prom_inst_10.INIT_RAM_35 = 256'hFFFFFFFFFFFFFFFFFFFFFFFFFFFFFFFFFFFFFFFFFFFFFFFFFFFFFFFFFFFFFFFF;
defparam prom_inst_10.INIT_RAM_36 = 256'hFFFFFFFFFFFFFFFFFFFFFFFFFFFFFFFFFFFFFFFFFFFFFFFFFFFFFFFFFFFFFFFF;
defparam prom_inst_10.INIT_RAM_37 = 256'hFFFFFFFFFFFFFFFFFFFFFFFFFFFFFFFFFFFFFFFFFFFFFFFFFFFFFFFFFFFFFFFF;
defparam prom_inst_10.INIT_RAM_38 = 256'h0000000000000000000000000000000000000000000000000000000000000000;
defparam prom_inst_10.INIT_RAM_39 = 256'h0000000000000000000000000000000000000000000000000000000000000000;
defparam prom_inst_10.INIT_RAM_3A = 256'h0000000000000000000000000000000000000000000000000000000000000000;
defparam prom_inst_10.INIT_RAM_3B = 256'h0000000000000000000000000000000000000000000000000000000000000000;
defparam prom_inst_10.INIT_RAM_3C = 256'h0000000000000000000000000000000000000000000000000000000000000000;
defparam prom_inst_10.INIT_RAM_3D = 256'h0000000000000000000000000000000000000000000000000000000000000000;
defparam prom_inst_10.INIT_RAM_3E = 256'h0000000000000000000000000000000000000000000000000000000000000000;
defparam prom_inst_10.INIT_RAM_3F = 256'h0000000000000000000000000000000000000000000000000000000000000000;

pROM prom_inst_11 (
    .DO({prom_inst_11_dout_w[30:0],dout[12]}),
    .CLK(clk),
    .OCE(oce),
    .CE(ce),
    .RESET(reset),
    .AD(ad[13:0])
);

defparam prom_inst_11.READ_MODE = 1'b0;
defparam prom_inst_11.BIT_WIDTH = 1;
defparam prom_inst_11.RESET_MODE = "ASYNC";
defparam prom_inst_11.INIT_RAM_00 = 256'hF8000000000000000000001FFFFFFFFFFFFFFFFFFFFC00000000000000000000;
defparam prom_inst_11.INIT_RAM_01 = 256'hFFFFFFFFFFFFFFFFFE0000000000000000000000003FFFFFFFFFFFFFFFFFFFFF;
defparam prom_inst_11.INIT_RAM_02 = 256'hFFFFFFFFFFFFFFFFFF800000000000000000000000000000000001FFFFFFFFFF;
defparam prom_inst_11.INIT_RAM_03 = 256'hFFFFFFFFFFFFFFFFFFFFFFFFFFFFFFFFFFFFFFFFFFFFFFFFFFFFFFFFFFFFFFFF;
defparam prom_inst_11.INIT_RAM_04 = 256'hFFFFFFFFFFFFFFFFFFFFFFFFFFFFFFFFFFFFFFFFFFFFFFFFFFFFFFFFFFFFFFFF;
defparam prom_inst_11.INIT_RAM_05 = 256'hFFFFFFFFFF000000000000000000000000000000000003FFFFFFFFFFFFFFFFFF;
defparam prom_inst_11.INIT_RAM_06 = 256'hFFFFFFFFFFFFFFFFFFFFF8000000000000000000000000FFFFFFFFFFFFFFFFFF;
defparam prom_inst_11.INIT_RAM_07 = 256'h000000000000000000007FFFFFFFFFFFFFFFFFFFF0000000000000000000003F;
defparam prom_inst_11.INIT_RAM_08 = 256'h07FFFFFFFFFFFFFFFFFFFFE000000000000000000003FFFFFFFFFFFFFFFFFFFE;
defparam prom_inst_11.INIT_RAM_09 = 256'h000000000000000001FFFFFFFFFFFFFFFFFFFFFFFFC000000000000000000000;
defparam prom_inst_11.INIT_RAM_0A = 256'h0000000000000000007FFFFFFFFFFFFFFFFFFFFFFFFFFFFFFFFFFE0000000000;
defparam prom_inst_11.INIT_RAM_0B = 256'h0000000000000000000000000000000000000000000000000000000000000000;
defparam prom_inst_11.INIT_RAM_0C = 256'h0000000000000000000000000000000000000000000000000000000000000000;
defparam prom_inst_11.INIT_RAM_0D = 256'h0000000000FFFFFFFFFFFFFFFFFFFFFFFFFFFFFFFFFFFC000000000000000000;
defparam prom_inst_11.INIT_RAM_0E = 256'h0000000000000000000007FFFFFFFFFFFFFFFFFFFFFFFF000000000000000000;
defparam prom_inst_11.INIT_RAM_0F = 256'hFFFFFFFFFFFFFFFFFFFF800000000000000000000FFFFFFFFFFFFFFFFFFFFFC0;
defparam prom_inst_11.INIT_RAM_10 = 256'hFFFFFFFFFFFFFFFFFFFFFFFFFFFFFFFF00000000000000000000000000000000;
defparam prom_inst_11.INIT_RAM_11 = 256'hFFFFFFFFFFFFFFFFFFFFFFFFFFFFFFFF00000000000000000000000000000000;
defparam prom_inst_11.INIT_RAM_12 = 256'hFFFFFFFFFFFFFFFFFFFFFFFFFFFFFFFF00000000000000000000000000000000;
defparam prom_inst_11.INIT_RAM_13 = 256'hFFFFFFFFFFFFFFFFFFFFFFFFFFFFFFFF00000000000000000000000000000000;
defparam prom_inst_11.INIT_RAM_14 = 256'h00000000000000000000000000000001FFFFFFFFFFFFFFFFFFFFFFFFFFFFFFFF;
defparam prom_inst_11.INIT_RAM_15 = 256'h00000000000000000000000000000001FFFFFFFFFFFFFFFFFFFFFFFFFFFFFFFE;
defparam prom_inst_11.INIT_RAM_16 = 256'h00000000000000000000000000000001FFFFFFFFFFFFFFFFFFFFFFFFFFFFFFFE;
defparam prom_inst_11.INIT_RAM_17 = 256'h00000000000000000000000000000001FFFFFFFFFFFFFFFFFFFFFFFFFFFFFFFE;
defparam prom_inst_11.INIT_RAM_18 = 256'h00000000000000000000000000000001FFFFFFFFFFFFFFFFFFFFFFFFFFFFFFFE;
defparam prom_inst_11.INIT_RAM_19 = 256'h00000000000000000000000000000001FFFFFFFFFFFFFFFFFFFFFFFFFFFFFFFE;
defparam prom_inst_11.INIT_RAM_1A = 256'h00000000000000000000000000000001FFFFFFFFFFFFFFFFFFFFFFFFFFFFFFFE;
defparam prom_inst_11.INIT_RAM_1B = 256'h00000000000000000000000000000001FFFFFFFFFFFFFFFFFFFFFFFFFFFFFFFE;
defparam prom_inst_11.INIT_RAM_1C = 256'hFFFFFFFFFFFFFFFFFFFFFFFFFFFFFFFF00000000000000000000000000000000;
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
defparam prom_inst_14.INIT_RAM_3E = 256'hFFFFFFFFFFFFFFFFFFFFFFFFFFFFFFFFFFFFFFFFFFFFFFFFFFFFFFFFFFFFFFFF;
defparam prom_inst_14.INIT_RAM_3F = 256'hFFFFFFFFFFFFFFFFFFFFFFFFFFFFFFFFFFFFFFFFFFFFFFFFFFFFFFFFFFFFFFFF;
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
