MaybeThready/MT-EMI/(commit log)

2026-10-09 init:初始化项目结构
2026-10-11 init: 初始化项目基本文件、开发文档
2026-10-13 FIX!: 修改了系统整体的事件驱动信号，规范了I2S通信时序
2026-10-13 fix: 修改了开发计划中对I2S接口的约定
2026-10-15 fix: 将系统模块拆分为时钟模块和脉冲模块
2026-10-15 init: 初始化相位累加器组模块接口
2026-10-15 feat: 完成了单个相位累加器的编写与测试
2026-10-16 feat: 完成了相位累加器组模块
2026-10-18 FEAT!: 实现键盘与旋钮 UI 控制链并修订音频参数接口
2026-10-18 feat: 添加 UI ModelSim 工程配置与波形调试入口
2026-10-19 feat: 初步实现了包络发生器组模块
2026-10-19 fix: 改善了除法时序违例问题
2026-10-19 fix: 解决了包络模块的时序违例问题
2026-10-19 fix: 改善了相位累加器模块的时序余量
2026-10-20 feat: 新增24键盘输入扫描驱动模块V1.0及测试
2026-10-21 fix:优化了时序裕量，并修复了modelsim仿真路径问题
2026-10-22 feat：添加了音色读取与保存的UI设置模块
2026-10-22 feat: i2s驱动模块开发，使用左声道
2026-10-22 FIX!: 修改了仿真文件组织架构
2026-10-22 FIX!: 修改了仿真文件的组织架构
2026-10-22 fix: 同步了仿真文件组织架构
2026-10-22 fix: 修改了仿真文件组织架构
2026-10-24 feat: 添加了波表插值模块
2026-10-24 feat: 完成了波表合成模块
2026-10-26 feat:添加了弯音模块
2026-10-26 fix: 为I2S模块添加了sd_mode引脚
2026-10-26 docs: 修订了开发计划书
2026-10-27 feat: 完成了通道机架模块
2026-10-27 test: 添加了基本测试模块
2026-10-27 feat: 旋转编码器PCB驱动
2026-10-27 feat: 初步实现了混响功能
2026-10-27 feat: 添加了混响示例音频
2026-10-27 fix: 测试代码统一失败处理
2026-10-27 fix: 更改物理约束
2026-10-29 feat: 初步实现了延迟算法
2026-10-29 fix: 优化了定点数饱和的代码规范
2026-10-29 feat: 按照线性电位器设计的弯音轮驱动
2026-10-29 feat：添加了音色保存与读取功能
2026-10-30 feat: 添加了失真功能
2026-10-30 feat: 添加了合唱功能
2026-10-30 docs: 修正了响度控制参数的格式
2026-10-30 feat: 添加了mixer顶层模块
2026-10-30 fix: 修复了i2s通信未阻塞的漏洞
2026-10-30 test: 添加了混音测试模块
2026-10-30 fix: 优化了混音模块的时序
2026-10-31 feat：更新了ui顶层模块（s2阶段）
2026-10-31 fix: 改善了混音模块的时序
2026-10-31 FIX!: 修复了通道机架模块缺乏与UI通信信号的漏洞
2026-10-31 fix: 添加力度控制
2026-10-31 feat: 添加了按键驱动模块
2026-10-31 feat: 弯音轮ADC确认
2026-11-01 test: 添加了键盘力度联调
2026-11-01 feat:添加lcd驱动和ui交互模块
2026-11-01 fix:优化了时序裕量
2026-11-01 feat：添加了lcd绘制模块
2026-11-01 feat: 旋钮测试
2026-11-02 TEST!: 优化了现有测试模块结构，并添加了弯音轮测试模块
2026-11-02 feat：添加和弦功能
2026-11-02 feat：添加了彩色波形显示功能
2026-11-03 test: 添加了UI测试模块
2026-11-03 fix: 为混音模块添加了增益补偿
2026-11-03 fix: 为UI模块添加了增益补偿
2026-11-03 fix: 为LCD模块添加了增益补偿
2026-11-03 fix: 修复了LCD参数单位、波形频谱幅值异常的漏洞
2026-11-03 feat: 添加了失谐功能
2026-11-03 fix: 优化了和弦触发逻辑
2026-11-03 feat: 编写了综合顶层模块逻辑
2026-11-03 fix: 简单修复了资源占用过多的问题
2026-11-03 fix: 进一步改善布线问题
2026-11-03 fix: 修复了布线问题
2026-11-03 feat: 初步实现了自动演奏功能
2026-11-03 fix: 优化了时序逻辑
2026-11-04 docs: 完善了README文件
